Gabrieldelacal/PFC/Latex project/prolat.pdf

## Projecte Final de Carrera ENGINYERIA INDUSTRIAL

# Control d’un Quadcopter

# Memòria

Autor: | Gabriel de la Cal Mendoza
Director: | Manel Velasco Garcia
Convocatòria: Data a presentar

## Escola Tècnica Superior d’Enginyeria Industrial de Barcelona

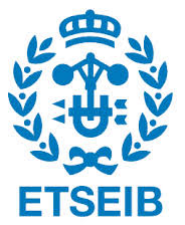
[picture p1: figure]

Quadcopter Control | 1

## Resum

## Índice

Resum | 1
1. Prefaci | 5
2. Introducció | 6
3. Definicio del model | 7
4. Disseny del controlador | 11
5. Implementació del control | 12
6. Construcció del Quadcopter | 13
7. Anàlisi econòmic | 18

4 | Quadcopter Control

## Índice de figuras

1. | Marcs de referència en el quadcopter | | 7
2. | Raspberry Pi a utilitzar | | 13
3. | Conectors de la Raspberry Pi | | 13
4. | IMU MPU-6050 | | 14
5. | Emissora i Receptor | | 14

## 1. Prefaci

### 1.1. Motivació

La principal motivació d’aquest projecte és la d’aplicar els coneixements bàsics adquirits en aquests 6 anys de carrera, i més en particular en l’àrea del control en haver fet l’intensificació d’automàtica.

Llavors, a l’hora de plantejar un tema per al projecte ràpidament va sorgir la idea de realitzar-lo sobre el control d’un sistema, i més en particular sobre un que estigués actualment emergent tant en mercats com en el camp de l’investigació.

D’entre les diferents alternatives, un quadcopter és la més atractiva tant per la seva sim-plicitat constructiva com pel no excessiu cost. Existeixen actualment en el mercat infinitat de proveïdors dels components necessaris per a construïr un quadcopter, amb un gran ventall d’opcions per a escollir cada element com motors, bateries, electrònica, etc.

Les possibles aplicacions són nombroses, tant que encara no s’han ni tan sols explotat totes les possibles. Com a exemple: vigilància de superfícies obertes, transport de petits paquets, eina d’oci, entre d’altres.

El preu d’un quadcopter no es gaire elevat ja que un comercial com el ARDrone2,0 oscil·la els 300 € i en construïr un amb menys prestacions no hauria de superar aquest cost.

### 1.2. Requeriments previs

Com a requeriments previs és necessari tenir certs coneixements mínims en automàtica per tal de controlar el quadcopter, aíxí com l’inquietut per aprendre el que sigui necessari per a complir, en la mesura del possible, els objectius inicials del present projecte com superar les dificultats que hagin sorgit, tenint en compte que el fi no justifica els medis.

## 2. Introducció

Un Quadcopter es un vehicle volador no tripulat (UnmannedAerialV ehicle) que es caracte-ritza per tenir quatre rotors a mode d’actuadors en comptes de dos com en el cas dels helicòpters. Aquest tipus d’autogir intenta obtenir una flotabilitat estable i vol precís balancejant les forces produïdes pels quatre motors.

Un dels avantatges que s’obtenen amb aquest canvi és la major capacitat de càrrega ja que es tenen 4 motors per a soportar el pes. L’estabilitat del vehicle millora en permetre aterratges i enlairaments verticals amb una major maniobrabilitat. També pot treballar en àreas de difícil accés o més agressives, com amb pluja i vent.

### 2.1. Estudi de l’art

### 2.2. Objectius del projecte

Esquemàticament es pot representar com una estructura en X amb el seu centre coincidint amb el centre de masses i quatre actuadors a les puntes de cada braç, tots ells apuntant en la mateixa direcció y sentit
descripción por encima
historia
estudio del arte
futuras aplicaciones

## 3. Definicio del model

### 3.1. Definició de les variables

Per a caracteritzar la planta amb la que es treballarà, és necessari obtenir un model del quadcopter. Les constants pròpies del model es deixaran en forma de paràmetres a calibrar una vegada es tingui l’objecte físic. D’aquesta manera el model serà general per a tot quadcopter que comparteixi la mateixa família de paràmetres. És necessari considerar dos marcs de referència: l’inercial format pels eixos x, y, z i el del cos (Body) format pels eixos xB, yB, zB. El primer té la persepectiva de l’observador en terra, estàtic, mentre que el segon és solidari a l’estructura. Segons l’orientació del eixos del cos amb aquesta referència es poden donar els següents dos cassos:

Crosstype: Els eixos de coordenades coincideixen amb els braços de l’estructura ja que es tenen els actuadors a les puntes de cada braç.
X − type: Els eixos i l’estructura formen 45º. Es tenen llavors dos motors al davant i dos

al darrere.

Per ser més usual la primera opció, es decideix utilitzar la configuració Crosstype tal i com es té en la figura 1.

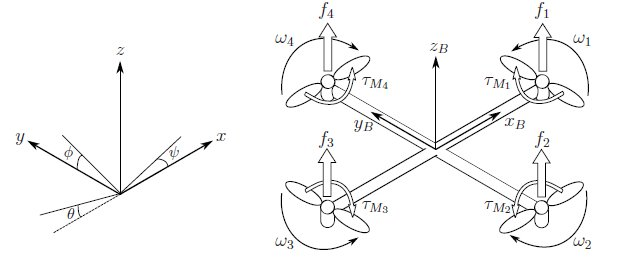
[picture p2: figure]

Figura 1: Marcs de referència en el quadcopter

Es suposa que l’objecte és un rotor esfèric, i per tant el seu tensor d’inèrcia és diagonal:

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
Ixx | 0 | 0
0 | Iyy | 0
0 | 0 | Izz

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
Es defineix la posició linear absoluta amb les coordenades x, y, z pel vector ξ i igualment per a la posició angular a partir de η segons:

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
, η =

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
, q = [
ξ
η
] | (2)

on φ és l’angle de capcineig (Pitch), θ és el de balanceig (Roll) i ψ el de guiñada (Yaw). Per a l’orientació angular entre els dos marcs es té un sistema de referència amb angles Tait Bryan, on la matriu de transformació és:

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
CψCθ | CψSθSφ − SψCφ | CψSθCφ + SψSφ
SψCθ | SψSθSφ + CψCφ | SψSθCφ − CψCφ
−Sθ | CθCφ | CθCφ

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
amb Cφ = cos(φ) i Sφ = sin(φ).

Les velocitats lineals en el marc de referència del cos (Body Frame) es representen amb el vector vB y les velocitats angulars amb γ segons:
vB =

⎡
⎢
⎢
⎢
⎢
⎢
⎣

vx,b

vy,b

vz,b

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
En canvi, les velocitats en el marc de referència inercial (Inertial Frame) es representen per η˙ per a les velocitats lineals i per ˙ξ per a les angulars:

˙ξ =

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
η˙ =

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
Ja que la derivada dels angles φ, θ i ψ no és el vector de velocitats angulars és necessari tenir un canvi de base per relacionar el marc de referència inercial al del cos amb la matriu Wη:

Wη =

⎡
⎢
⎢
⎢
⎢
⎢
⎣
1 | 0 | −Sθ
0 | Cφ | CθSφ
0 −Sφ | CθCφ

⎤
⎥
⎥
⎥
⎥
⎥
⎦
amb | γ = [Wη] η˙ | (6)

Les forces de sustentació i moments generats pels quatre actuadors són f1, f2, f3, f4 i w1, w2, w3, w4 respectivament. Seguint l’orientació de la figura 1, per tal de poder anular els moments produïts en l’eix zB (en el marc del cos) el sentit de gir dels actuadors 4 i 2 és en el de les agulles del rellotge (clockwise) i els dels 1 i 3 en sentit contrari (counterclockwise).

Interessa conèixer quina força i moment aportarà cada motor per a una velocitat angular coneguda. Es tenen les següents relacions per a cada actuador:
fi = kw²

i

τMi = bw²

i

(7)

Per tant l’empenta total TB proporcionada en la direcció zB i els moments generats τB pels motors és:

TB = k (
4
∑

i=1

w

2

i ) ezB =

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
τB =

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
lk(w

2

4 − w
2/2)
lk(w

2

3 − w
2/1)

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
### 3.2. Obtenció del model

Les equacions que governen el sistema s’obtenen amb el mètode de Euler-Lagrange, pel que es parteix obtenint el Lagrangià del sistema:

L = Ecinetica − Epotencial = (Etranslacio + Erotacio) − Epotencial | (9)

Substituïnt cada component per la seva expressió:

L(q, q˙) =
m
2

˙ξ

T ˙ξ +
1
2

γ

T

Iγ − mgz | (10)

Es troba el vector de forçes i moments com:
F = [
f
τB

] =
d
dt (

∂L

∂q˙

) −

∂L
∂q | (11)
amb | q = [ x y z φ θ ψ ]
T
i | q˙ = [ x˙ | y˙ | z˙ φ˙ | ˙θ ψ˙ ]
T

En calcular F és necessari fer el canvi de variables de γ a η˙ amb el canvi de base η˙ = [Wη]
−1
γ
per tal de poder derivar el Lagrangià respecte q˙, que són les variables pròpies del marc de referència inercial

1
2

γ

T

Iγ =
1
2

(Wηη˙)

T

I(Wηη˙) =
1
2

η˙

T

(WT
η

IWη)η˙ =
1
2

η˙

T
Jη˙ | (12)

on la matriu J queda com

J = WT

η

IWη =

⎡
⎢
⎢
⎢
⎢
⎢
⎣
Ixx | 0 | −IxxSθ
0 | IyyC

2

φ + IzzS
2
φ

(Iyy − Izz)CφSφCθ
−IxxSθ | (Iyy − Izz)CφSφCθ | IxxS
2

θ + IyyS
2
φC

2

θ + IzzC
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
(13)

i per tant el Lagrangià queda com:

L(q, q˙) =
m
2

˙ξ

T ˙ξ +
1
2

η˙

T

Jη˙ − mgz | (14)

Les components lineals y angulars no depenen unes de les altres, i per tant es poden estudiar per separat obtenint dos equacions: una per les forces lineals y un altre per als moments. Això vol dir que la força que exerceixen els actuadors no depenen de les velocitats angulars que es tinguéssin, i tampoc es tindran accel·leracions angulars diferents segons l’altura a la que es trobi el quadcopter: l’objecte girarà de la mateixa manera sigui quina sigui la seva posició en l’espai. Llavors, fent la derivada parcial respecte q˙ s’obté

F =
d
dt (

m
2

(1 ⋅

˙ξ + ˙ξ ⋅ 1) +
1
2

∂
∂η˙

(η˙

T

Jη˙)) −

∂L
∂q | (15)

Com que J és una matriux simètrica, es pot dir que ∂
∂η˙

(η˙

T Jη˙) = 2
∂
∂η˙

(η˙

T J)η˙.

Demostració: Per probar això es veurà per al cas ∂
∂x (x

T Ax) = 2
∂
∂x (x

T A)x amb

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
a11 | a12 | a13
a21 | a22 | a23
a31 | a32 | a33

⎤
⎥
⎥
⎥
⎥
⎥
⎦

(16)

Llavors
∂
∂x(x

T Ax) =
∂
∂x

⎛
⎜
⎝

[x1x2x3]

⎡
⎢
⎢
⎢
⎢
⎢
⎣
a11 | a12 | a13
a21 | a22 | a23
a31 | a32 | a33

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
= | (17)

∂
∂x(x

2

1a11 + x1x2a21 + x1x3a31 + x1x2a12 + x 2

xa22 + x2x3a32 + x1x3a13 + x2x3a23 + x 2

3a33) = (18)

Com que A és simètrica a12 = a21, a13 = a31 i a23 = a32, i en fer la derivada direccional resulta

∂
∂x(x

T Ax) =

⎡
⎢
⎢
⎢
⎢
⎢
⎣

2x1a11 + x2a21 + x3a31 + x2a12 + x3a13

x1a21 + x1a12 + 2x2a22 + x3a32 + x3a23

x1a31 + x2a32 + x1a31 + x2a23 + 2x3a23

⎤
⎥
⎥
⎥
⎥
⎥
⎦

= 2 ⋅

⎡
⎢
⎢
⎢
⎢
⎢
⎣

x1a11 + x2a12 + x3a13

x1a12 + x2a22 + x3a23

x1a13 + x2a23 + x3a23

⎤
⎥
⎥
⎥
⎥
⎥
⎦

(19)

I en avaluar l’altre costat de la igualtat es té el mateix resultat

2

∂
∂x(x

T A)x = 2
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
x1a11 + x2a12 + x3a13

x1a21 + x2a22 + x3a23

x1a13 + x2a32 + x3a33

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
x = | (20)
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
a11 | a12 | a13
a21 | a22 | a23
a31 | a32 | a33

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
= 2 ⋅

⎡
⎢
⎢
⎢
⎢
⎢
⎣

x1a11 + x2a12 + x3a13

x1a12 + x2a22 + x3a23

x1a13 + x2a23 + x3a23

⎤
⎥
⎥
⎥
⎥
⎥
⎦

(21)
∎

Com que 2

∂
∂η˙

(η˙

T J)η˙ = 2Jη˙ es té, aplicant la regla de la cadena en el producte Jη˙:

F =
d
dt

(m ˙ξ + Jη˙) −

∂L
∂q = m¨ξ + Jη¨ + J˙η˙ −

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
J)η˙ − mg

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
(22)

Per arribar a aquest resultat s’ha aplicat la derivada direccional a mgz:

Dq(mgz) = Dξ(mgz) = mg

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
(23)

Separant les components lineals i angulars en dues equacions:

f = m¨ξ + mg

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
= RTB | (24)

τ = Jη¨ + (J˙ −
∂
∂η˙

(η˙

T

J))
×≠≠≠≠≠≠≠≠≠≠≠≠≠≠≠≠≠≠≠≠≠÷≠≠≠≠≠≠≠≠≠≠≠≠≠≠≠≠≠≠≠≠≠∂
C(η,η˙)
η˙ = Jη¨ + C(η, η˙)η˙ | (25)

On C(η, η˙) és la matriu de Coriolis. Per obtenir el sistema d’equacions del model s’han d’aïllar les accel·leracions, i s’obté:
⎧⎪⎪
⎨
⎪⎪⎩

¨ξ =
1

m RTB − g ⋅ [ 0 0 1 ]
T
η¨ = J
−1

(τ − C(η, η˙)η˙)

(26)

Per a realitzar el control será útil representar el sistema 26 en forma d’espai d’estats:

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
m RTB − g ⋅ [ 0 0 1 ]
T

η˙
J

−1

(τ − C(η, η˙)η˙)

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
(27)

### 3.3. Representació del model amb Matlab

## 4. Disseny del controlador

## 5. Implementació del control

## 6. Construcció del Quadcopter

El conjunt de peces que formen aquest aparell estan conectades entre sí segons la funció que realitzen. Esencialment la Raspberry Pi controla els motors segons les señals que reb de l’IMU i el Receptor. Tot el conjunt és alimentat per una bateria LiPo i s’adapta el voltatge de 11.1V a 5V per mitjà d’un Regulador per tal d’alimentar a la Raspberry. Tots els components estan subjectats a una estructura (Frame) que també pateix les forces y moments.

### 6.1. Descripció dels components

Es descriu tot seguit cada component i el criteri de sel·lecció que s’ha aplicat.

Raspberry Pi

Abreujat com a RPi, és un petit ordinador integrat en una sola placa (Single-Board Com-puter o SBC en anglès) del tamany d’una targeta de crèdit, és a dir, amb unes dimensions de 85.6cm x 53.98cm, desenvolupat per la Fundació Raspberry Pi amb l’intenció de promocionar les ciències computacionals a les escoles [2].

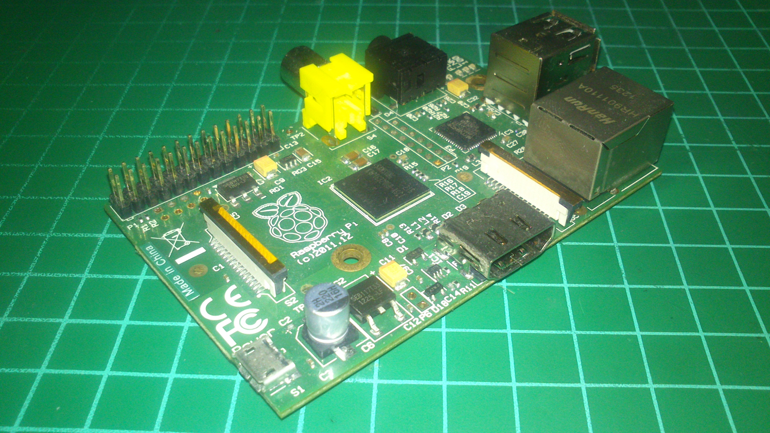
[picture p3: figure]

Figura 2: Raspberry Pi a utilitzar

S’ha optat per aquesta opció pel seu econòmic preu, la velocitat de processament i baix consum. A més, s’ha volgut ampliar els coneixements d’aquest petit monstre. En particular s’utilitza la segona revisió del model B:

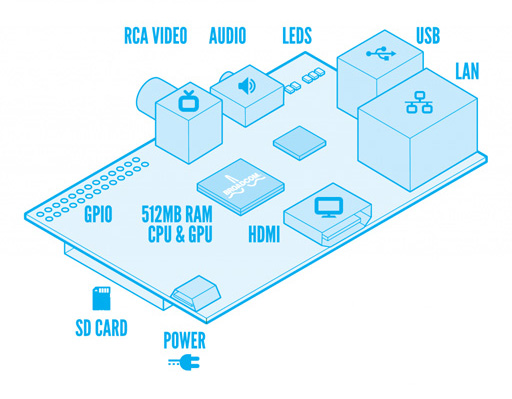
[picture p4: figure]

Figura 3: Conectors de la Raspberry Pi

Té un System-on-Chip (SoC) Broadcom BCM2835 amb un ARM1176JZF-S a 700 Mhz, una GPU VideoCore IV i 512 MB de memòria RAM. Disposa de dos ports USB, una sortida mini-jack 3.5mm, sortida d’audio/vídeo HDMI, una sortida RCA i un port RJ45 10/100 d’Ethernet. L’alimentació es realitza per mitjà d’un mini USB a 5V/700mA, amb un consum de 3.5W. El sistema operatiu és un Raspbian, gravat en una targeta SD de 4GB. Disposa d’un conjunt de pins que permeten comunicació amb perifèrics de baix nivell UART, I2C, SPI i 8 pins de propòsit general (General Porpouse Input Output o GPIO).

GY-521 MPU-6050

Es tracta d’una Unitat de Mesura Inercial (IMU en anglès) que integra en un mateix encap-sulat de 4x4x0,9mm un acceleròmetre i un giròscop, ambdós de 3 eixos. Disposa dun conversor ADC de 16 bits per a cada eix i es comunica mitjançant un protocol de comunicació I2C. S’ha optat per utilitzar aquest dispositiu pel seu baix cost i la fàcil comunicació que comporta amb la RPi.

Figura 4: IMU MPU-6050

Com a característiques dels sensors: el giròscop té un rang de ±250,±500,±1000,±2000 graus/segon, i l’accel·leròmetre de ±2g,±4g,±8g, 16g. La tensió d’alimentació és del rang de 2,375V − 3,46V

i cap la possibilitat d’utilitzar un mòdul DMP (Digital Motion Processor), però s’ha decidit implementar un filtre de Kalman per llegint les dades en cru (raw) de la cua F IF O del sensor.

Emissor-Receptor

Amb aquest parell de components es transmet la consigna generada des del transmissor cap al receptor mitjançant ones de radio. El model que s’utilitza és el T urnigy5X5ChM ini, per què és un model fàcil d’utilitzar i econòmic. Les especificacions tècniques més rellevants són:

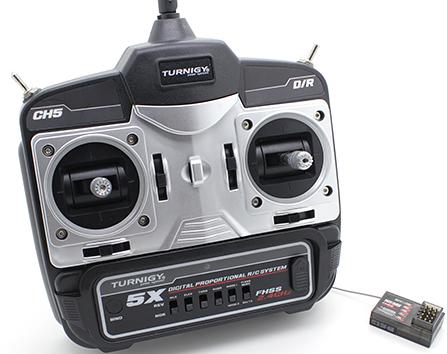
[picture p5: figure]

Figura 5: Emissora i Receptor

El transmissor té unes dimensions de 156x152x50mm, un pes de 265g i s’alimenta a 6V (4 bateries AA). El receptor té unes mides de 33,5x20,5x13mm i s’alimenta a 4.8-6V. Disposa de 5 canals de radio, amb transmissió segura a 2.4GHz amb el mètode FHSS. Pot configurarse per traballar amb dos modes (mode1-mode2).
La senyal que es reb per cada canal en el receptor és de PWM de 50Hz amb un Duty que veria de 1ms a 2ms.

Bateria LiPo

Per a alimentar a tot el conjunt s’utilitza una LiPo T urnigy2200mAh3S1P25C. Per tant, és capaç d’entregar 2.2A durant una hora, i com que la capacitat és de 25C, la descàrrega pot ser de 2,2 ∗ 25 = 55A amb un pic de descàrrega de 35C, és a dir, amb un pic de 2,2 ∗ 35 = 77A

durant 10 segons. Aquesta bateria està formada per tres cel·les que proporcionen un voltatge total d’uns 11,1V :

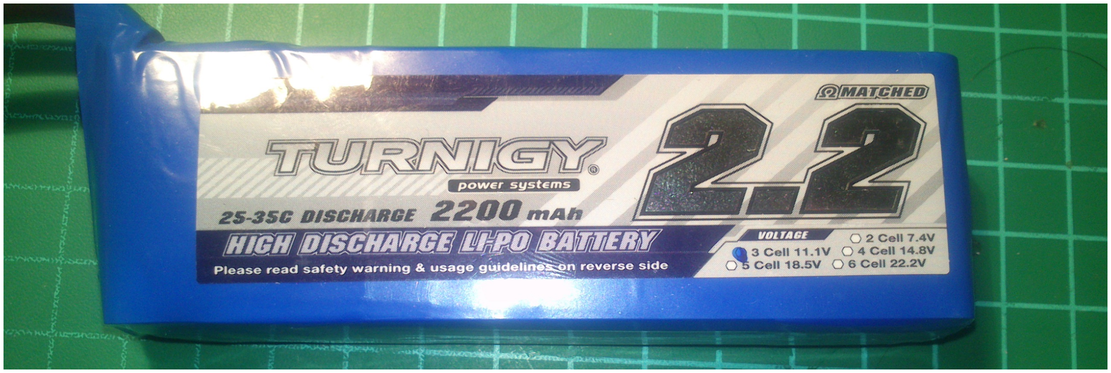
[picture p6: figure]

El conector de càrrega és el JST − XH i el de descàrrega el XT60. Per a tenir en compte amb

per al quadcopter és interessant saber que pesa 188g i respecte a l’estructura (frame) que les seves dimensions són de 105x33x24mm.

Regulador Step-Down

Per adaptar la tensió de 11.1V de la bateria LiPo a 5V per alimentar la Raspberry Pi, és necessari un regulador. En aquest cas es té l’Interruptor-Mode Màxim BEC LM2576S, que proporciona fins a 3A de corrent [6]

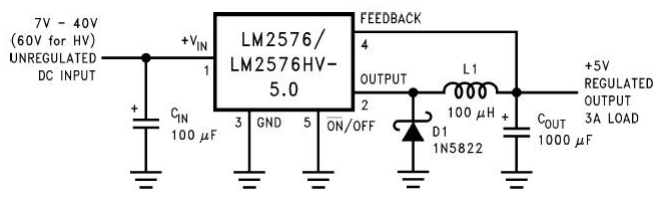
[picture p7: figure]

Motors Brushless

Els actuadors que s’utilitzen són motors brushless (BL-DC). En partircular el Turnigy 2213 20turn 1050kv 19A Outrunner. Les seves especificacions més rellevants són:

Kv: 1050rpm/v

Operating Current: 6A 16A

Peak Current: 19A

Weight: 56g

Dimensions: 27.6 x 32mm

Shaft Size: 3.175mm

Variador ESC

Per a controlar un motor brushless l’etapa de potència a utilitzar un ESC (Electronic Speed Controller) que és un variador que consta d’un inversor trifàsic:

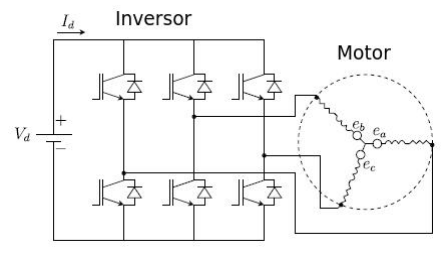
[picture p8: figure]

Turnigy AE-20A Brushless ESC Specification: Output: Continuous 20A, burst 25A up to 10 seconds. Input Voltage: 2-4 cells lithium battery or 5-12 cells NIMH battery. BEC: Linear 2A @ 5V Control Signal Transmission: Optically coupled system. Max Speed: 2 Pole: 210,000rpm 6 Pole: 70,000rpm 12 Pole: 35,000rpm Size: 50mm (L) * 26mm (W) * 12mm (H). Weight: 19g.

Features: High performance microprocessor brings out the best compatibility with all kinds of motors and the highest driving efficiency. Wide-open heatsink design to get the best heat dissipation effect. Improved Normal, Soft, Very-Soft start modes, compatible with aircraft and helicopter. Smooth, linear, quick and precise throttle response. Multiple protection features: Low-voltage cut-off protection / Over-heat protection / Throttle signal loss protection Pro-gramable via transmitter Programming features: Brake setting (we recommend using brake for only folding props applications) Battery type(Li-xx or Ni-xx) Low voltage cutoff setting Factory default setup restore Timing settings (to enhance ESC efficiency and smoothness) Soft acceleration start ups (for delicate gearbox applications) Low voltage cutoff type (power reduction orirnmediate shutdown)
Factory default settings: Brake: off Battery type: Li-xx (Li-ion or Li-Po) Low voltage cutoff threshold: Soft cut-off (2.6V) Timing setup: Low Soft Acceleration Start Up: Normal
Low voltage cutoff type: Medium

Frame

Peso 190g

Hèlix

### 6.2. Muntatge

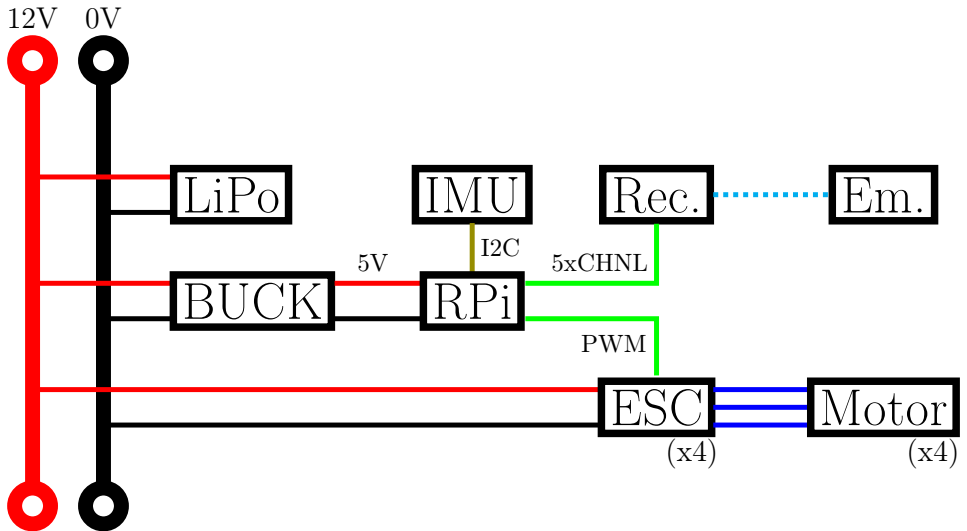
[picture p9: figure]
LiPo; IMU; Rec.; 5xCHNL; BUCK; RPi; PWM ESC; Motor

## 7. Anàlisi econòmic

## ANNEXES

Annex 1: Obtenció vector de forces

asdfasdf

Annex 2:Preparació de la Raspberry Pi

Per a posar a punt la RPi s’ha d’instal·lar Raspbian i configurar-lo per tal que es pugui comunicar amb la placa MPU-6050.

Instalació Raspbian

Havent introduït la targeta SD en un lector adeqüat, es detecta en una terminal mitjançant l’ordre df -h. Suposant que hagués estat gravada anteriorment:

S’han de desmontar les dos particions, tant la /dev/sdb1 com la /dev/sdb2 :

umount /dev/sdb1
umount /dev/sdb2

Havent descarregat la imatge a instalar per exemple a l’Escriptori, es procedeix amb:

sudo dd bs=4M if=~/Escritorio/2013-07-26-wheezy-raspbian.img of=/dev/sdb

Passats uns minuts ja es té la SD grabada amb el sistema operatiu Raspbian.

Configuració de la Raspberry

Per tal de poder comunicar la RPi amb la IMU MPU-6050 per I2C és necessari configurar el sistema. Primer és necessari instal·lar els drivers més rellevants. De l’arxiu

sudo nano /etc/modules

s’han d’afegir les següents dues línies al final de l’arxiu:

i2c-bcm2708
i2c-dev

En l’arxiu blacklist:

sudo vi /etc/modprobe.d/raspi-blacklist.conf

les següents dues línies han de començar amb un signe # (de comentari):

#blacklist spi-bcm2708

#blacklist i2c-bcm2708

Per provar de connectar el sensor, és necessari seguir primer el connexionat:

És a dir:

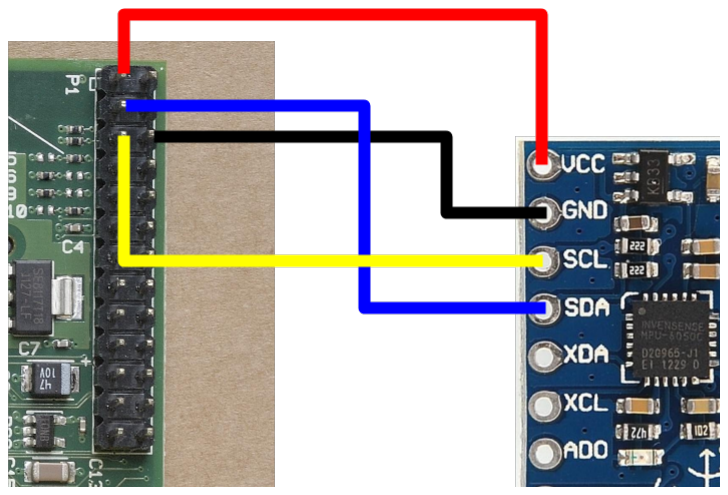
[picture p10: figure]

Pin1-3.3V es connecta VCC.

Pin3-SDA es connecta a SDA

Pin5-SCL es connecta a SCL

Pin6-Ground es connecta a GND
S’ha d’instal·lar el paquet i2c − tools:

sudo apt-get install i2c-tools

Per a veure el sensor s’escriu:

sudo i2cdetect -y 1

El resultat és

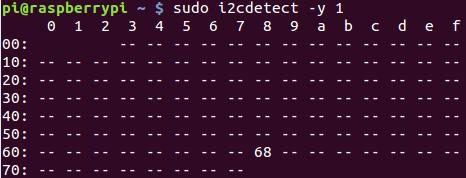
[picture p11: figure]

que és el dispositiu que correspon al MPU-6050.

Annex 3: Filtre de kalman

## Referencias

[1] Teppo Luukkonen (August 22,2011). Modelling and control of quadcopter
[2] Wikipedia de la Raspberry Pi: http://en.wikipedia.org/wiki/Raspberry_Pi
[3] Accel·leròmetre i Giròscop MPU-6050 per a Arduino: http://playground.arduino.cc/Main/MPU-6050#.UzhsVCK9jb4 (http://playground.arduino.cc/Main/MPU-6050#.UzhsVCK9jb4)
[4] MPU-6050. Especificació del producte: http://www.invensense.com/mems/gyro/documents/PS-MPU-6000A-00v3.4.pdf (http://www.invensense.com/mems/gyro/documents/PS-MPU-6000A-00v3.4.pdf)
[5] MPU-6050. Mapa de Registres i descripcions: http://www.invensense.com/mems/gyro/documents/RM-MPU-6000A-00v4.2.pdf (http://www.invensense.com/mems/gyro/documents/RM-MPU-6000A-00v4.2.pdf)
[6] LM2576S Datasheet: http://www.ti.com/lit/ds/symlink/lm2576.pdf
