Gabrieldelacal/PFC/Latex project/prolat.tex

\documentclass[twoside,11pt]{book}

%\usepackage[latin1]{inputenc}
\usepackage[utf8]{inputenc}
\usepackage[spanish]{babel}
\usepackage{amsmath, amsthm, amsfonts}
\usepackage{textcomp}
\usepackage[T1]{fontenc}
\usepackage{hyperref}
\usepackage{array}
\usepackage{MnSymbol}   % Para poder escribir el cuadrado negro

\usepackage{geometry}
    \geometry{a4paper,total={210mm,297mm},left=30mm,right=20mm,top=30mm,bottom=30mm,}

\usepackage{listings}
\lstset{
	% linewidth=15cm,
	% xrightmargin=1cm,
	breaklines=true,
	numbers=left,
	language=Matlab,
	frame=single}
\usepackage{color}
\usepackage{pgfplots}
\usepackage{pgfplotstable}
\usepackage{slashbox}
\usepackage{tikz}
\usetikzlibrary{arrows,shapes,trees}
\usepackage{multirow}
\usepackage{tabularx}
%\usepackage[official]{eurosym}
\usetikzlibrary{decorations.pathmorphing,patterns,calc,shapes,arrows}
\usepackage{setspace}
% \renewcommand{\baselinestretch}{1.3}

\usepackage{booktabs}

\usepackage{graphicx}
%\usepackage{epstopdf}

\title{\begin{center} 
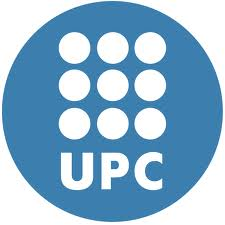
[picture p12: Latex project/images/upc.png]
 
\end{center} 
\vspace{0cm} 
Proyecto Final de Carrera\\
INGENIERÍA INDUSTRIAL \\
\vspace{0cm} 
\Huge{Modelado, simulación, construcción y control de un Quadcopter} 
\vspace{0cm} \\ 
Memoria}
%\author{Gabriel de la Cal Mendoza}
\date{}

\usepackage{fancyhdr}		%% Para cabezera de página

\pagestyle{fancy}

% \lhead[x1]{x2}
% \chead[y1]{y2}
% \rhead[LE,RO]{z2}
% \renewcommand{\headrulewidth}{0.5pt}

% \lfoot[a1]{b2}
% \cfoot[c1]{d2}
% \rfoot[LE,RO]{\includegraphics[scale=0.1]{etseib.jpg}}
% \renewcommand{\footrulewidth}{0.5pt}

\fancyhead[LO,RE]{Modelado, simulación, construcción y control de un Quadcopter}
\fancyhead[LE,RO]{\thepage}
\fancyfoot[LE,RO]{\includegraphics[scale=0.2,bb=0 0 257 257] {images/etseib_blue.png}}
\fancyfoot[C]{}

\begin{document}
\onehalfspacing
%\maketitle
%\begin{center}
%\large{
%$\begin{array}{ll}
%\mbox{Autor:} & \mbox{Gabriel de la Cal Mendoza} \\
%\mbox{Director:} & \mbox{Manel Velasco Garcia} \\
%\mbox{Convocatoria:} & \mbox{Fecha a presentar}
%\end{array}$}
%\\ \vspace{0cm} \Large{Escola Tècnica Superior d'Enginyeria Industrial de Barcelona}\\ \vspace{0cm}
%\includegraphics[scale=0.4]{images/etseib.jpg}
%\end{center}

\thispagestyle{empty}
\newpage
\begin{center}

\end{center}
\thispagestyle{empty}
\newpage
\setcounter{page}{1}

\begin{center}
\section*{Resumen}
\end{center}

En el presente proyecto se ha tenido como meta el control de un Quadcopter. Para tal propósito se ha linealizado  el modelo no lineal obtenido y controlado mediante un Regulador Lineal Cuadrático (LQR). El contenido de este trabajo está organizado en 9 capítulos y 4 anexos.\\

En el capítulo \ref{prefacio} se presentan los motivos por los que se ha elegido este tema y requerimientos previos para no tener insalvables dificultades. 

En el capítulo \ref{intro}, como Introducción, se hace un estudio del arte, con breves pinceladas del basto campo que hoy en día se encuentra sobre este tema. Además se describen los objetivos de este proyecto. Éstos no son más que el resolver todo problema que haya surgido durante esta aventura.

Se obtiene el modelo a partir de los parámetros característicos del sistema físico en el capítulo \ref{def}. En linealizar el sistema en el punto de equilibrio se llega a la conclusión de que las variables que lo forman se desacoplan y se comportan como un conjunto de dobles integradores. Ésto permite que la ley de control sea sencilla y justifica el que se hayan usado controladores PID tan asiduamente. También se presenta el modelo implementado en Simulink, con el que se probará el control obtenido posteriormente para verificar su eficiencia.

El capítulo anterior permite que en el \ref{control} se obtengan las acciones de control $\pmb{u}=-\pmb{k} \cdot \pmb{X}$ por medio de un regulador LQR (Linear Quadratic Regulator) y así atacar al sistema.

%En el capítulo \ref{implement} se explica cómo y qué se ha implementado respecto al control. Se comenta el código C que se está continuamente ejecutando.

En el capítulo \ref{construc} se describen tanto los componentes que se utilizan como el proceso de montaje paso a paso. Se justifica la elección de cada elemento tomando como criterio tanto las características de los otros elementos que lo componen como el dimensionado mismo del Quadcopter. 

En los capítulos \ref{economics}, \ref{impacto} y \ref{conclusiones} se tiene un análisis económico, un  estudio de impacto ambiental y las conclusiones respectivamente. En el primero se desglosan los costes materiales y se valoran las horas invertidas. Sobre el impacto ambiental se describen brevemente los principales efectos en el medio ambiente de los componentes que se utilizan y en el último capítulo se relata con qué se queda uno en limpio tras acabar esta empresa y sobre la continuad del proyecto.\\

En el Anexo A se muestra mediante códigos Matlab de dónde se ha extraído el vector de fuerzas del modelo y se obtienen las constantes $K$ de la realimentación.

En el Anexo B se detalla el proceso de grabado y posteriores modificaciones realizadas a la Raspberry Pi según se ha requerido.
 
En el Anexo C se describe el filtro de Kalman y cómo se ha implementado. 

En el Anexo D se describe cómo se han encontrado los parámetros que representan al sistema físico que se tiene. Para ello se han caracterizado los motores, además de la masa, inercias y distancias características propias del aparato.

%\newpage
%\begin{center}

%\end{center}
%\thispagestyle{empty}
\newpage

\setcounter{page}{1}
\tableofcontents
\addcontentsline{toc}{section}{Resumen}
\fancyhead[LE,RO]{3}
\fancyfoot[C]{}
%\setcounter{page}{1}
\newpage
\fancyhead[LE,RO]{\thepage}
\setcounter{page}{4}
\listoffigures
\newpage

\chapter{Prefacio} \label{prefacio}
%\section{Prefacio} \label{prefacio}
\section{Motivación}

La principal motivación de este proyecto es la de aplicar por uno mismo los conocimientos básicos adquiridos en la carrera, y más en particular en el área del control en haber cursado la intensificación de automática.\\

En plantear un tema para el proyecto rápidamente surgió la idea de realizarlo sobre el control de un sistema mecánico, y más en particular sobre uno que estuviera actualmente emergiendo tanto en mercados como en el campo de la investigación.\\ 

De entre las diferentes alternativas, un quadcopter es la más atractiva para el proyecto tanto por su simplicidad constructiva como por su no excesivo coste. Existen actualmente en el mercado infinidad de proveedores para los componentes necesarios para construir un quadcopter, con un gran abanico de opciones de entre las que escoger cada elemento como motores, baterías, electrónica, etc.\\

Las posibles aplicaciones son numerosas, tanto que aún no se han explotado todas las posibles. Como ejemplo: vigilancia de superficies abiertas, transporte de pequeños paquetes, herramienta de ocio, entre otras.\\

Entender el funcionamiento y familiarizarse con el mecanismo es una inquietud que se ha mantenido insatisfecha durante largo tiempo. Con este pretexto se pretende acabar de justificar la elección del tema de esta pequeña gran empresa.

\section{Requerimientos previos}

Es necesario tener ciertos conocimientos mínimos en automática para poder controlar el quadcopter, así como la inquietud de aprender lo que sea necesario para cumplir, en la medida de lo posible, los objetivos iniciales. \\

Nociones de mecánica son necesarias para elaborar e interpretar el sistema sobre el que se trabaje, así como sus resultados. Conocimientos del lenguaje $C$ como $Matlab$ son imprescindibles ya que el código del programa que realiza los cálculos está escrito en este mismo lenguaje. Estar familiarizado con $Simulink$ ha sido de gran ayuda a la hora de implementar el modelo y simularlo. 

Para adaptar los elementos que componen el aparato y afianzarlos a la estructura (Frame)  del Quadcopter ha sido de gran ayuda contar con el servicio de una impresora 3D de creación también propia, así como estar familiarizado con el argot y elementos de un Quadcopter: motores, emisoras de radio, entre otros. \\

Superar las dificultades que han surgido, teniendo en cuenta que el fin no justifica los medios, es la praxis que se ha aplicado a la hora de realizar este trabajo. Finalmente, recordar reminiscencias de la carrera es siempre útil e interesante: conceptos adquiridos pero no utilizados que se esperan aplicar.
 
\newpage
\chapter{Introducción} \label{intro}
%\section{Introducción} \label{intro}

Un Quadcopter es un vehículo volador no tripulado ($Unmanned \>Aerial\>Vehicle$ o $UAV$) que se caracteriza por tener quatro rotores como actuadores en vez de dos como en el caso de los helicópteros. Este tipo de autogiro intenta obtener una flotabilidad más estable y vuelo preciso balanceando las fuerzas producidas por los cuatro motores y surge de la necesidad de tener un aparato de vuelo de dimensiones reducidas y gran estabilidad, con prestaciones superiores a las de un helicóptero convencional. \\

\begin{figure}[h!]
\begin{center}
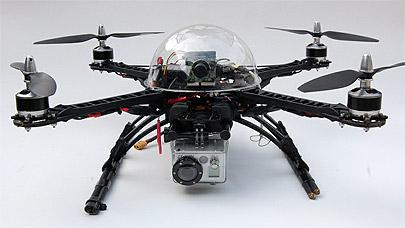
[picture p13: Latex project/images/quadcopter_example.png]
\hspace{1cm}
\caption{Quadcopter de ejemplo con cámara}
\end{center}
\end{figure}

Una de las ventajas que se obtiene con el cambio es la mayor capacidad de carga ya que es tienen 4 motores  para soportar el peso. La estabilidad del vehículo mejora en permitir aterrizajes y despegues verticales con una mayor maniobrabilidad. También puede trabajar en áreas de difícil acceso o más agresivas, como con lluvia y viento. \\

Esquemáticamente se puede representar como una estructura en $X$ con su centroide coincidiendo con el centro de masas y cuatro actuadores en las puntas de cada brazo, todos ellos apuntando en la misma dirección y sentido pero con giros de aspa en sentido contrario, pero igual en lados opuestos.

\section{Estudio del arte}

En la actualidad el campo referente a estos aparatos se ha diversificado tanto que se pueden encontrar muchas variedades y tipos de Quadcopters. Se ha hecho mención del modelo de cuatro motores, pero bien pueden encontrarse de tres hasta 8 motores, sino más en casos más concretos. \\

\begin{figure}[h!]
\begin{center}
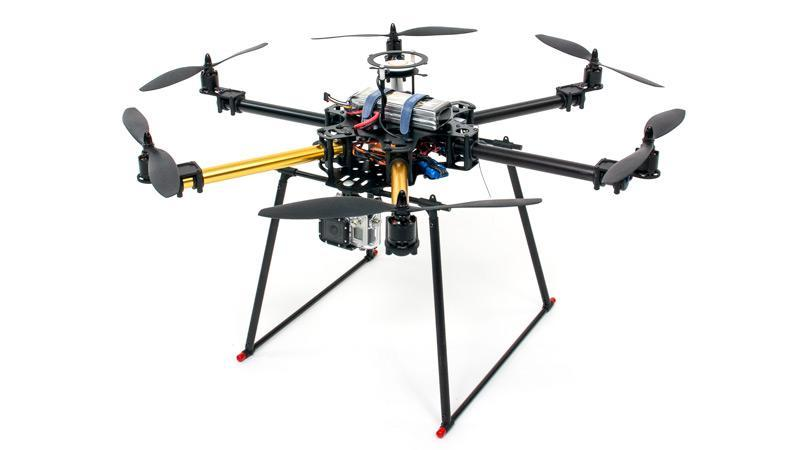
[picture p14: Latex project/images/6_armed_quadcopter.png]

\caption{Ejemplo de Quadcopter con 6 motores}
\end{center}
\end{figure}

Con el objetivo de desarrollar un $UAV$ que realice tareas de forma totalmente autónoma, se han diseñado sensores para estimar los estados del vehículo de manera más rápida y eficiente, así como diferentes estrategias para controlar la estabilidad y orientación del mismo. Se ha utilizado visión  por computador para realizar aterrizajes, detección de objetivos y navegación autónoma. También pueden combinarse diferentes técnicas con el uso del GPS para asegurar una buena localización del aparato. \\

Para controlar esta clase de aparatos se utilizan diferentes leyes de control, así como PID, LQR, Redes Neuronales, Machine Learning, entre otros. La más utilizada es sin duda el PID por su fácil implementación y poca carga computacional.

\section{Objetivos del proyecto}

La meta que se persigue es la de controlar un Quadcopter. Éste es un excelente subterfugio para cumplir con otros objetivos relacionados con este fin, como el control de motores, el inteligente uso de la electrónica y correcto diseño mecánico del aparato. Además, se espera haber ampliado la visión que uno tiene en cada campo. \\

De entre todas las disciplinas involucradas, se espera acabar familiarizado con las facetas relacionadas con la presente empresa para clarificar la relación entre los elementos que componen un Quadcopter.  A saber, se espera poder acabar entendiendo la electrónica, mecánica y conocimientos de control que reinan en el sistema. \\

En el caso de la electrónica se espera entender y poder implementar sencillos protocolos de comunicación, en este caso $I2C$ entre los sensores y la Raspberry Pi. Ésta es el centro neurálgico del Quadcopter, así que es esencial saber utilizarla como se requiere para que pueda recibir consignas, estados y enviar la correspondiente acción de control a los motores para que se llegue al estado final deseado. \\

Por parte de la mecánica, es primordial tener conocimientos sólidos de conceptos como el Teorema de la Cantidad de Movimiento y el de la conservación del Momento de Inercia, así como poder calcular el Lagrangiano ($\mathcal{L}$) para generar un modelo verosímil y que represente fidedignamente la realidad para que se desarrolle de manera efectiva el control. \\

Finalmente, y como más serio objetivo de toda esta aventura, es el de haber afianzado lo que se creía entendido en relación al control. Asimilar otros métodos de control aplicables a sistemas multilineales no contemplados en la carrera es un excitante reto que se espera haber superado con éxito. \\

Entonces, se entiende este trabajo como la causa de la motivación a cumplir con un objetivo multidisciplinar, como puede serlo cualquiera en el campo de la robótica, en el que se debe tener constancia de muchos aspectos relevantes, como el de la economía. Poder tener idea de lo que cuesta un robot es de gran importancia si uno se embarca en un proyecto de envergadura, ya que se quiere que los pronósticos sobre el presupuesto cuadren con la futura realidad. 
\section{Alcance}

En este proyecto se ha perseguido el objetivo de controlar un Quadcopter mediante un regulador LQR. Para ello se ha obtenido un modelo lineal parametrizado con la información representativa propia del sistema real que representa: masas, inercias, distancias y caracterización de los actuadores, al que se le ha aplicado la misma ley de control que al sistema real. \\

La construcción del mismo se ha llevado a cabo mediante piezas compradas por separado sin recurrir a kits montados o modelos completos, como Ardupilot o un AR Drone. No se ha pretendido construir un vehículo totalmente robusto, sino una plataforma de trabajo sobre la que se comparan comportamientos con su simulación y a la que se intenta abordar un control.\\  

No se analizan ni comparan los resultados con otros posibles controles a implementar, tales como el PID. Se juzgará la calidad del vuelo según su aparente estabilidad y si se mantiene la posición asignada como consigna. 

\newpage
\chapter{Definición del modelo} \label{def}
%\section{Definición del modelo} \label{def}
\section{Definición de las variables}
Para caracterizar la planta con la que es trabajará, es necesario obtener un modelo del Quadcopter. Las constantes propias del modelo se dejarán en forma de parámetros a calibrar una vez se tenga el objeto físico. De esta manera el modelo será general para todo Quadcopter que comparta la misma familia de parámetros.
Es necesario considerar dos marcos de referencia: el inercial formado por los ejes $x,y,z$ y el del cuerpo (Body) formado por los ejes $x_B,y_B,z_B$. El primero tiene la perspectiva de el observador en tierra, estático, mientras que el segundo es solidario a la estructura. Según la orientación de los ejes del cuerpo con esta referencia se pueden dar los siguientes dos casos:
\begin{itemize}
\item \textbf{Cross type}: Los ejes de coordenadas coinciden con los brazos de la estructura ya que se tienen los actuadores en las puntas de cada brazo.
\item \textbf{X-type}: Los ejes y la estructura forman $45º$. Se tienen entonces dos motores en la parte delantera y dos en la trasera.
\end{itemize} 
Por ser más usual la primera opción, se decide utilizar la configuración $Cross type$ tal y como se tiene en la figura \ref{RefQuad}.
\begin{figure}[h!]
\centering
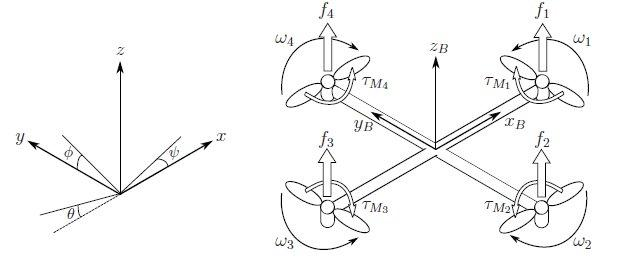
[picture p15: Latex project/images/quad.png]
\hspace{2cm}
\caption{Marcos de referencia en el quadcopter}
\label{RefQuad}
\end{figure}\\
Se supone que el objeto es un rotor esférico, y por tanto su tensor de inercia es diagonal:
\begin{equation}\textbf{I}=\left[ \begin{array}{ccc}
I_{xx} & 0 & 0 \\
0 & I_{yy} & 0 \\
0 & 0 & I_{zz} 
\end{array} \right] \end{equation}
Se define la posición lineal absoluta a partir de las coordenadas $x,y,z$ con el vector $\pmb{\xi}$ e igualmente para la posición angular a partir de $\pmb{\eta}$ según:
\begin{equation} 
\pmb{\xi}=\left[ \begin{array}{ccc}
x\\
y\\
z \end{array} \right] ,\quad \pmb{\eta}=\left[ \begin{array}{ccc}
\phi\\
\theta\\
\psi \end{array} \right] , \quad \pmb{q}=\left[\begin{array}{c}
\pmb{\xi}\\
\pmb{\eta} \end{array} \right] 
\end{equation}

donde $\phi$ es el ángulo de cabeceo (Pitch), $\theta$ és el de alabeo (Roll) y $\psi$ el de guiñada o deriva (Yaw).\\
Para la orientación angular entre los dos marcos se tiene un sistema de referencia con ángulos Tait-Bryan, donde la matriz de transformación es:

\begin{equation}
\pmb{R}(\phi,\theta,\psi)=\left[\begin{array}{ccc}
C_\psi C_\theta & C_\psi S_\theta S_\phi - S_\psi C_\phi & C_\psi S_\theta C_\phi + S_\psi S_\phi \\
S_\psi C_\theta & S_\psi S_\theta S_\phi + C_\psi C_\phi & S_\psi S_\theta C_\phi - C_\psi C_\phi \\
-S_\theta & C_\theta C_\phi & C_\theta C_\phi 
\end{array}\right]
\end{equation}

con $C_\phi=cos(\phi)$ i $S_\phi=sin(\phi)$. Ésto se obtiene del sistema de  orientación intrínseco basado en las rotaciones fundamentales respecto $\phi,\theta$ y $\psi$:

\begin{equation}
\pmb{R}(\phi,\theta,\psi)=\pmb{R}_{1}(\psi)\cdot \pmb{R}_{2}(\theta)\cdot \pmb{R}_{3}(\phi)
\end{equation}

donde las matrices de rotación son de la forma:

\begin{equation}
\begin{array}{c}
\pmb{R}(\phi)=\left[\begin{array}{ccc}
1 & 0 & 0 \\
0 & cos(\phi) & -sin(\phi) \\
0 & sin(\phi) & cos(\phi) \\ \end{array} \right]\hspace{1cm} \pmb{R}(\theta)=\left[\begin{array}{ccc}
cos(\theta) & 0 & sin(\theta) \\
0 & 1 & 0 \\
-sin(\theta) & 0 & cos(\theta) \\ \end{array} \right] \\
\\
\pmb{R}(\psi)=\left[\begin{array}{ccc}
cos(\psi) & -sin(\psi) & 0 \\
sin(\psi) & cos(\psi) & 0 \\
0 & 0 & 1 \\ \end{array} \right] \end{array}
\end{equation}

Las velocidades lineales en el marco de referencia del cuerpo (Body Frame) se representan con el vector $v_B$ y las velocidades angulares con $\gamma$ según:
\begin{equation}
\pmb{v_B}=\left[\begin{array}{c}
v_{x,b}\\
v_{y,b}\\
v_{z,b}\\
\end{array}\right] \hspace{1cm} \pmb{\gamma}=\left[\begin{array}{c}
p\\
n\\
r
\end{array} \right]
\end{equation}
En cambio, las velocidades en el marco de referencia inercial (Inertial Frame)  se representan por $\pmb{\dot{\xi}}$ para las velocidades lineales y con $\pmb{\dot{\eta}}$ para las angulares: 
\begin{equation}
\pmb{\dot{\xi}}=\left[\begin{array}{c}
\dot{x} \\
\dot{y} \\
\dot{z}
\end{array} \right] \hspace{1cm} \pmb{\dot{\eta}}=\left[\begin{array}{c}
\dot{\phi} \\
\dot{\theta} \\
\dot{\psi}
\end{array} \right] 
\end{equation}
Ya que la derivada de los ángulos $\phi$, $\theta$ y $\psi$ no es igual al vector de velocidades angulares ($\pmb{\gamma} \neq \pmb{\dot{\eta}}$), es necesario tener un cambio de base para relacionar las velocidades en el marco de referencia inercial con las del cuerpo. Para ello se calcula la matriz de transformación de velocidades angulares entre las referencias Inercial y Body como:

\begin{equation}
\left[ \begin{array}{c}
p \\
n \\
r\\\end{array} \right] = \pmb{I_{3}}\left[\begin{array}{c}
\dot{\phi} \\
0 \\
0 \\ \end{array} \right] + \pmb{R}(\phi) \left[ \begin{array}{c}
0 \\
\dot{\theta} \\
0 \\ \end{array} \right] + \pmb{R}(\phi)\cdot \pmb{R}(\theta) \left[ \begin{array}{c}
0 \\
0 \\
\dot{\psi} \\ \end{array} \right]= \left[ \pmb{W_{\eta}} \right] \left[ \begin{array}{c}
\dot{\phi} \\
\dot{\theta} \\
\dot{\psi} \\ \end{array} \right] 
\end{equation}

y se obtiene la matriz $\pmb{W_\eta}$:

\begin{equation}
\pmb{W_\eta}=\left[\begin{array}{ccc}
%1 & 0 & -S_\theta \\
%0 & C_\phi & C_\theta S_\phi \\
%0 & -S_\phi & C_\theta C_\phi 
1 & 0 & sin(\theta) \\
0 & cos(\phi) & -sin(\phi)cos(\theta) \\
0 & sin(\phi) & cos(\phi)cos(\theta) \\
\end{array} \right] \hspace{0.5cm} con \hspace{0.5cm} 
\pmb{\gamma}=\left[ \pmb{W_\eta} \right] \pmb{\dot{\eta}} 
\end{equation}

Las fuerzas de sustentación y velocidades angulares de los cuatro actuadores son $f_1,f_2,f_3,f_4$ y $w_1,w_2,w_3,w_4$ respectivamente. Siguiendo la orientación de la figura \ref{RefQuad}, con el objetivo de poder anular los momentos producidos en el eje $z_B$ (en el marco del cuerpo $B$) el sentido de giro de los actuadores  $4$ y $2$ son en el de las agujas del reloj (clockwise) y el de los $1$ y $3$ en sentido contrario (counterclockwise).

Interesa conocer qué fuerza y momento aportará cada motor dada una velocidad angular conocida. Se supone poder controlar ambos y cómo aproximación inicial se considera que están relacionados con la velocidad angular de la forma:
\begin{equation}
\begin{array}{l}
f_i=kw^2_i \\ 
\tau_{M_i}=bw^2_i
\end{array}
\end{equation}
Por tanto el empuje total $\pmb{T_B}$ proporcionado en la dirección $z_B$ y los momentos generados $\pmb{\tau_B}$ por los motores son:
\begin{equation}
\pmb{T_B}=k\left(\sum_{i=1}^{4}w^2_i \right)e_{z_B}=\left[ \begin{array}{c}
0 \\
0 \\
\displaystyle\sum_{i=1}^{4}f_i
\end{array} \right] 
\hspace{1cm} \pmb{\tau_B}=\left[ \begin{array}{c}
\tau_\phi \\
\tau_\theta \\
\tau_\psi
\end{array} \right] = \left[ \begin{array}{c}
l(f_4 - f_2) \\
l(f_3 - f_1) \\
\displaystyle\sum_{i=1}^{4}\tau_{M_i}
\end{array} \right]
\end{equation}

donde $l$ es la longitud de los brazos.

\section{Obtención del modelo}
Las ecuaciones que gobiernan el sistema se obtienen con el método de Euler-Lagrange, por lo que se empieza obteniendo el Lagrangiano del sistema:
\begin{equation}
\mathcal{L}=E_{cinetica} - E_{potencial} = (E_{translacion}+E_{rotacion})-E_{potencial}
\end{equation}

Substituyendo cada componente por su expresión:
\begin{equation}
\mathcal{L}(\pmb{q},\pmb{\dot{q}})=\frac{m}{2} \pmb{\dot{\xi}}^T \pmb{\dot{\xi}} + \frac{1}{2}\pmb{\gamma}^{T}\pmb{I}\pmb{\gamma} - mgz
\end{equation}
Es encuentra el vector de fuerzas y  momentos:
\begin{equation}
\pmb{F}=\left[ \begin{array}{c}
\pmb{f} \\
\pmb{\tau_B}
\end{array} \right] = \frac{d}{dt}\left(\frac{\partial \mathcal{L}}{\partial \pmb{\dot{q}}}\right)-\frac{\partial\mathcal{L}}{\partial \pmb{q}}
\end{equation}

con $ \hspace{0.5cm} \pmb{q}=[\begin{array}{cccccc}
x & y & z & \phi & \theta & \psi
\end{array} ]^{T} \hspace{0.5cm}$ y $ \hspace{0.5cm} \pmb{\dot{q}}=[\begin{array}{cccccc}
\dot{x} & \dot{y} & \dot{z} & \dot{\phi} & \dot{\theta} & \dot{\psi}
\end{array} ]^{T}$.\\

En calcular $\pmb{F}$ es necesario hacer el cambio de variables de $\pmb{\gamma}$ a $\pmb{\dot{\eta}}$ con el cambio de base $\pmb{\dot{\eta}}=\left[ \pmb{W_\eta} \right]^{-1} \pmb{\gamma}$ para poder derivar el Lagrangiano respecto $\pmb{\dot{q}}$, que son las variables propias del marco de referencia inercial:

\begin{equation}
\frac{1}{2}\pmb{\gamma}^{T}\pmb{I}\pmb{\gamma} = \frac{1}{2}(\pmb{W_\eta} \pmb{\dot{\eta}})^{T}\pmb{I}(\pmb{W_\eta} \pmb{\dot{\eta}}) = \frac{1}{2}\pmb{\dot{\eta}}^{T}(\pmb{W_\eta} ^{T}\pmb{I}\pmb{W_\eta})\pmb{\dot{\eta}} = \frac{1}{2}\pmb{\dot{\eta}}^{T}\pmb{J}\pmb{\dot{\eta}}
\end{equation}

donde la matriz $J$ queda como
\begin{equation}
\pmb{J}=\pmb{W_\eta} ^{T}\pmb{I}\pmb{W_\eta} = \left[ \begin{array}{ccc}
I_{xx} & 0 & I_{xx} S_\theta \\
0 & I_{yy} C^2_\phi + I_{zz} S^2_\phi & (I_{zz}-I_{yy}) C_{\phi} S_\phi C_\theta \\
I_{xx} S_\theta & (I_{zz}-I_{yy}) C_{\phi} S_\phi C_\theta & I_{xx} S^2_{\theta}+I_{yy} S^2_{\phi} C^2_\theta +I_{zz}C^2_{\phi} C^2_{\theta}
\end{array} \right]
\end{equation} 

y por tanto el Lagrangiano queda:

\begin{equation}
\mathcal{L}(\pmb{q},\pmb{\dot{q}})=\frac{m}{2} \pmb{\dot{\xi}}^T \pmb{\dot{\xi}} + \frac{1}{2}\pmb{\dot{\eta}}^{T}\pmb{J}\pmb{\dot{\eta}} - mgz
\end{equation}
Los componentes lineales y angulares del vector de fuerzas no dependen unos de los otros y por tanto se pueden estudiar por separado obteniendo dos ecuaciones: una para las fuerzas lineales y otro para los momentos. Ésto quiere decir que la fuerza que ejercen los actuadores no depende de las velocidades angulares que se tengan ni tampoco se tendrán aceleraciones angulares diferentes según la altura a la que se encuentre el quadcopter: el objeto girará de la misma manera sea cual sea la  posición en la que se encuentre en el espacio.

Entonces, calculando la derivada parcial respecto $\pmb{\dot{q}}$ se obtiene que 
\begin{equation}
\pmb{F}=\frac{d}{dt}\left(\frac{m}{2}(1\cdot \pmb{ \dot{\xi}}+\pmb{\dot{\xi}}\cdot 1)+\frac{1}{2}\frac{\partial}{\partial \pmb{\dot{\eta}}}(\pmb{\dot{\eta}}^{T}\pmb{J}\pmb{\dot{\eta}})\right)-\frac{\partial \mathcal{L}}{\partial \pmb{q}}
\end{equation}

En ser $\pmb{J}$ una matriz simétrica, se puede decir que  $\frac{\partial}{\partial \pmb{\dot{\eta}}}(\pmb{\dot{\eta}}^{T}\pmb{J}\pmb{\dot{\eta}})=2 \frac{\partial}{\partial \pmb{\dot{\eta}}}(\pmb{\dot{\eta}}^{T}\pmb{J})\pmb{\dot{\eta}} $. \\

\textbf{Demostración:} Para probar ésto se verá para el caso $\frac{\partial}{\partial \pmb{x}}(\pmb{x}^{T}\pmb{A}\pmb{x})=2 \frac{\partial}{\partial \pmb{x}}(\pmb{x}^{T}\pmb{A})\pmb{x} $ con 

\begin{equation}
\pmb{x}=\left[ \begin{array}{c}
x_1 \\
x_2 \\
x_3 
\end{array} \right] \hspace{1cm} \pmb{A}=\left[ \begin{array}{ccc}
a_{11} & a_{12} & a_{13} \\
a_{21} & a_{22} & a_{23} \\
a_{31} & a_{32} & a_{33} 
\end{array} \right]
\end{equation}
Llavors
\begin{equation}
\frac{\partial}{\partial \pmb{x}}(\pmb{x}^{T}\pmb{A} \pmb{x}) = \frac{\partial}{\partial \pmb{x}}\left(\left[x_1 x_2 x_3 \right]\left[\begin{array}{ccc}
a_{11} & a_{12} & a_{13} \\
a_{21} & a_{22} & a_{23} \\
a_{31} & a_{32} & a_{33} 
\end{array} \right]\left[\begin{array}{c}
x_1 \\
x_2 \\
x_3 
\end{array} \right] \right) =
\end{equation}
\begin{equation}
\frac{\partial}{\partial \pmb{x}}(x^2_1 a_{11}+x_1x_2a_{21}+x_1x_3a_{31} + x_1x_2a_{12}+x^2_xa_{22}+x_2x_3a_{32} + x_1x_3a_{13}+x_2x_3a_{23}+x^2_3a_{33})=
\end{equation}
Com que $\pmb{A}$ es simétrica $a_{12}=a_{21}$, $a_{13}=a_{31}$ i $a_{23}=a_{32}$, y en hacer la derivada direccional resulta
\begin{equation}
\frac{\partial}{\partial \pmb{x}}(\pmb{x}^{T}\pmb{A} \pmb{x})=\left[ \begin{array}{c}
2x_1a_{11}+x_2a_{21}+x_3a_{31}+x_2a_{12}+x_3a_{13} \\
x_1a_{21}+x_1a_{12}+2x_2a_{22}+x_3a_{32}+x_3a_{23} \\
x_1a_{31}+x_2a_{32}+x_1a_{31}+x_2a_{23}+2x_3a_{23}
\end{array} \right]=2\cdot\left[ \begin{array}{c}
x_1a_{11}+x_2a_{12}+x_3a_{13} \\
x_1a_{12}+x_2a_{22}+x_3a_{23} \\
x_1a_{13}+x_2a_{23}+x_3a_{23}
\end{array} \right]
\end{equation}
Y en avaluar el otro costado de la igualdad se tiene el mismo resultado
\begin{equation}
2 \frac{\partial}{\partial \pmb{x}}(\pmb{x}^{T}\pmb{A})\pmb{x}=2 \frac{\partial}{\partial \pmb{x}} \left( \left[ \begin{array}{ccc}
x_1a_{11}+x_2a_{12}+x_3a_{13} \\
x_1a_{21}+x_2a_{22}+x_3a_{23} \\
x_1a_{13}+x_2a_{32}+x_3a_{33}
\end{array} \right]^{T} \right)\pmb{x}=
\end{equation}
\begin{equation}
=2\left[\begin{array}{ccc}
a_{11} & a_{12} & a_{13} \\
a_{21} & a_{22} & a_{23} \\
a_{31} & a_{32} & a_{33} 
\end{array} \right]\cdot\left[\begin{array}{c}
x_1 \\
x_2 \\
x_3
\end{array} \right]=2\cdot\left[ \begin{array}{c}
x_1a_{11}+x_2a_{12}+x_3a_{13} \\
x_1a_{12}+x_2a_{22}+x_3a_{23} \\
x_1a_{13}+x_2a_{23}+x_3a_{23}
\end{array} \right]
\end{equation}
\hfill $\blacksquare$ \\
Como $2 \frac{\partial}{\partial \pmb{\dot{\eta}}}(\pmb{\dot{\eta}}^{T}\pmb{J})\pmb{\dot{\eta}=2} \pmb{J} \pmb{\dot{\eta}}$, en aplicar la regla de la cadena en el producto $\pmb{J}\pmb{\dot{\eta}}$ se obtiene que:
\begin{equation}
\pmb{F}=\frac{d}{dt}\left(m \dot{\pmb{\xi}}+\pmb{J} \pmb{\dot{\eta}}\right)-\frac{\partial \mathcal{L}}{\partial \pmb{q}} =m\pmb{\ddot{\xi}} + \pmb{J}\pmb{\ddot{\eta}} + \pmb{\dot{J}}\pmb{\dot{\eta}}-\left( \frac{1}{2} 2 \frac{\partial}{\partial \pmb{\dot{\eta}}} ( \pmb{\dot{\eta}}^{T}\pmb{J})\pmb{\dot{\eta}} - mg\left[\begin{array}{c}
0 \\
0 \\
1
\end{array} \right] \right)
\end{equation}

Para llegar a este resultado se ha aplicado la derivada direccional a $mgz$:
\begin{equation}
D_q(mgz)=D_{\pmb{\xi}}(mgz)=mg \left[ \begin{array}{c}
0 \\
0 \\
1
\end{array} \right]
\end{equation}

Separando las componentes lineales y angulares en dos ecuaciones:
\begin{equation}
\begin{cases}
%\begin{align}
\pmb{f} & = m \pmb{\ddot{\xi}} + mg \left[ \begin{array}{c}
0 \\
0 \\
1
\end{array} \right] =\pmb{R}\pmb{T_B} \\
\pmb{\tau} & =\pmb{J} \pmb{\ddot{\eta}} +  \underbrace{\left( \pmb{\dot{J}} - \frac{\partial}{\partial \pmb{\dot{\eta}}}(\pmb{\dot{\eta}}^{T}\pmb{J})\right)}_{\pmb{C(}\eta,\dot{\eta}\pmb{)}} \pmb{\dot{\eta}} =\pmb{J} \pmb{\ddot{\eta}} +  \pmb{C(\eta,\dot{\eta})}\cdot\pmb{\dot{\eta}} 
%\end{align}
\end{cases}
\label{3.24}
\end{equation}

Donde $\pmb{C(\eta,\dot{\eta})}$ es la matriz de Coriolis. 
Para obtener el sistema de ecuaciones del modelo se deben aislar las aceleraciones y se obtiene:
\begin{equation}
\begin{cases}
\pmb{\ddot{\xi}} & =\frac{1}{m}\pmb{R}\pmb{T_{B}} - g \cdot \left[ \begin{array}{ccc}
0 & 0 & 1\\
\end{array} \right]^{T} \\
\pmb{\ddot{\eta}} & =\pmb{J}^{-1} \left( \pmb{\tau} - \pmb{C(\eta,\dot{\eta})}\cdot\pmb{\dot{\eta}}  \right)
\end{cases}
\label{eq:system}
\end{equation}

Reescribiendo estas ecuaciones de la forma $\pmb{\dot{x}}=\pmb{f(x,u)}$, donde $\pmb{u}$ es el conjunto de fuerzas ejercidas por los motores, se tiene 

\begin{equation}
\frac{\partial}{\partial t}\left[ \begin{array}{l}
\pmb{\xi} \\
\pmb{\dot{\xi}} \\
\pmb{\eta} \\
\pmb{\dot{\eta}} \\
\end{array} \right] =\left[ \begin{array}{l}
\pmb{\dot{\xi}} \\
\frac{1}{m}\pmb{R}\pmb{T_{B}} - g \cdot \left[ \begin{array}{ccc}
0 & 0 & 1 \\
\end{array} \right]^{T} \\
\pmb{\dot{\eta}} \\
\pmb{J}^{-1} \left( \pmb{\tau} - \pmb{C(\eta,\dot{\eta})}\cdot\pmb{\dot{\eta}} \right)
\end{array} \right]
\label{eq:system2}
\end{equation}

Para realizar el control será útil representar el sistema \ref{eq:system}  en forma de espacio de estados, y por tanto el vector de estados será de la forma $\enspace \pmb{X}=\left[ x \enspace \dot{x} \enspace y \enspace \dot{y} \enspace z \enspace \dot{z} \enspace \phi \enspace \dot{\phi} \enspace \theta \enspace \dot{\theta} \enspace \psi \enspace \dot{\psi} \right]$. El punto de equilibrio de este sistema es aquél que hace que las componentes angulares del vector de estados no varíe y no haya desplazamientos lineales. 

Este caso se puede dar para toda posición $\pmb{\xi}$ dada. Ésto se tiene si todos los motores hacen exactamente la misma fuerza y en total, sumando la de los cuatro, la misma al peso del Quadcopter, además de tener una cantidad de movimiento nulo y evitar que el ángulo  $\psi$ (yaw) varíe. Se trata de un punto de equilibrio forzado. El punto de equilibrio será entonces:

\begin{equation}
\begin{cases}
\pmb{X_0}=\left[x \enspace 0 \enspace y \enspace 0 \enspace z \enspace 0 \enspace 0 \enspace 0 \enspace 0 \enspace 0 \enspace 0 \enspace 0 \right]^{T} \\
\pmb{U_0}=\left[ \begin{array}{l}
f_{1} \\
f_{2} \\
f_{3} \\
f_{4} \end{array} \right] = \frac{m \cdot g}{4} \left[ \begin{array}{l}
1 \\
1 \\
1 \\
1 \\ \end{array} \right]
\end{cases}
\end{equation}

El modelo se expresa en forma lineal como

\begin{equation}
\begin{array}{l}
\pmb{\dot{X}}=[\pmb{A}] \cdot \pmb{X} + \pmb{G} + [\pmb{B}] \cdot \pmb{U} \\
\pmb{Y} = [\pmb{C}] \cdot \pmb{X} 
\end{array}
\end{equation} 

donde $\pmb{G}$ es el término que incluye a la constate de la gravedad, separada de la función $\pmb{f(x,u)}$. Se calculan las matrices $\pmb{A}$ y $\pmb{B}$ con los respectivos jacobianos en el punto de equilibrio:

\begin{equation}
\begin{array}{c}
%\vspace*{-0.6cm}
\pmb{A}=\left.{\frac{\partial \pmb{f(x,u)}}{\partial \pmb{x}}}\right\vert_{\pmb{X_0},\pmb{U_0}} \\ %\hspace*{1.5cm} 
\\
\pmb{B}=\left.{\frac{\partial \pmb{f(x,u)}}{\partial \pmb{u}}}\right\vert_{\pmb{X_0},\pmb{U_0}} \\\end{array}
\label{jacobians}
%\vspace*{1cm}
\end{equation}

En considerar que las posiciones angulares de $\phi$ y $\theta$ no diferirán significativamente respecto de zero y que el ángulo $\psi$ no es relevante, se trabaja con una matriz de rotación $R$ igual a la identidad
\begin{equation}
\pmb{R}=\left[\begin{array}{ccc}
1 & 0 & 0 \\
0 & 1 & 0 \\
0 & 0 & 1 \\ \end{array} \right]
\end{equation}
Se ha mantenido el término independiente de la gravedad a fuera de la función $\pmb{f(x,u)}$ para no eliminarlo en la derivada del jacobiano. Las matrices $\pmb{A}$ y $\pmb{B}$ quedan como
\begin{equation}
\hspace*{-0.9cm}\pmb{A}=\left[ \begin{array}{cccccccccccc}
0 & 1 & 0 & 0 & 0 & 0 & 0 & 0 & 0 & 0 & 0 & 0 \\
0 & 0 & 0 & 0 & 0 & 0 & 0 & 0 & 0 & 0 & 0 & 0 \\
0 & 0 & 0 & 1 & 0 & 0 & 0 & 0 & 0 & 0 & 0 & 0 \\
0 & 0 & 0 & 0 & 0 & 0 & 0 & 0 & 0 & 0 & 0 & 0 \\
0 & 0 & 0 & 0 & 0 & 1 & 0 & 0 & 0 & 0 & 0 & 0 \\
0 & 0 & 0 & 0 & 0 & 0 & 0 & 0 & 0 & 0 & 0 & 0 \\
0 & 0 & 0 & 0 & 0 & 0 & 0 & 1 & 0 & 0 & 0 & 0 \\
0 & 0 & 0 & 0 & 0 & 0 & 0 & 0 & 0 & 0 & 0 & 0 \\
0 & 0 & 0 & 0 & 0 & 0 & 0 & 0 & 0 & 1 & 0 & 0 \\
0 & 0 & 0 & 0 & 0 & 0 & 0 & 0 & 0 & 0 & 0 & 0 \\
0 & 0 & 0 & 0 & 0 & 0 & 0 & 0 & 0 & 0 & 0 & 1 \\
0 & 0 & 0 & 0 & 0 & 0 & 0 & 0 & 0 & 0 & 0 & 0 \\ \end{array} \right] \hspace*{0.5cm} \pmb{B} = \left[ \begin{array}{cccc}
0 & 0 & 0 & 0 \\
0 & 0 & 0 & 0 \\
0 & 0 & 0 & 0 \\
0 & 0 & 0 & 0 \\
0 & 0 & 0 & 0 \\
1/m & 1/m & 1/m & 1/m \\ 
0 & 0 & 0 & 0 \\
0 & {}^{-l}/_{Ixx} & 0 & {}^{l}/_{Ixx} \\ 
0 & 0 & 0 & 0 \\
{}^{-l}/_{Iyy} & 0 & {}^{l}/_{Iyy} & 0 \\
0 & 0 & 0 & 0 \\
{}^{b}/_{Izz} & {}^{-b}/_{Izz} & {}^{b}/_{Izz} & {}^{-b}/_{Izz} \\ \end{array} \right]
\end{equation}

y las matrices $\pmb{G}$ i $\pmb{C}$ quedan como 

\begin{equation}
\hspace*{0.5cm} \pmb{G}= \left[ \begin{array}{c}
0 \\
0 \\
0 \\
0 \\
0 \\
-9.81 \\
0 \\
0 \\
0 \\
0 \\
0 \\
0 \\ \end{array} \right]  \hspace*{1cm} \pmb{C}=\left[ \begin{array}{cccccccccccc}
1 & 0 & 0 & 0 & 0 & 0 & 0 & 0 & 0 & 0 & 0 & 0 \\
0 & 0 & 1 & 0 & 0 & 0 & 0 & 0 & 0 & 0 & 0 & 0 \\
0 & 0 & 0 & 0 & 1 & 0 & 0 & 0 & 0 & 0 & 0 & 0 \\
0 & 0 & 0 & 0 & 0 & 0 & 1 & 0 & 0 & 0 & 0 & 0 \\
0 & 0 & 0 & 0 & 0 & 0 & 0 & 0 & 1 & 0 & 0 & 0 \\
0 & 0 & 0 & 0 & 0 & 0 & 0 & 0 & 0 & 0 & 1 & 0 \\ \end{array} \right]
\end{equation}

Éstos son los resultados obtenidos del código comentado en el $Anexo \>\>A$, en donde se detalla el procedimiento.

Como se desea implantar un control sobre el equilibrio del Quadcopter en vez de la posición, se tendrán las variables pertinentes a la orientación, y por tanto el vector de estados estará formado por %$\enspace \left[ \enspace \phi \enspace \dot{\phi} \enspace \theta \enspace \dot{\theta} \enspace \psi \enspace \dot{\psi} \right]$.
$\pmb{X}=\left[ \enspace \phi \enspace \dot{\phi} \enspace \theta \enspace \dot{\theta} \right]$. 

Queda entonces
\iffalse
\begin{center}
\begin{equation}
\left[ \begin{array}{c}
\dot{\phi} \\
\ddot{\phi} \\
\dot{\theta} \\
\ddot{\theta} \\
\dot{\psi} \\
\ddot{\psi} \\ \end{array} \right] = \left[ \begin{array}{cccccc}
0 & 1 & 0 & 0 & 0 & 0 \\
0 & 0 & 0 & 0 & 0 & 0 \\
0 & 0 & 0 & 1 & 0 & 0 \\
0 & 0 & 0 & 0 & 0 & 0 \\
0 & 0 & 0 & 0 & 0 & 1 \\
0 & 0 & 0 & 0 & 0 & 0 \\ \end{array} \right] \left[ \begin{array}{c}
\phi \\
\dot{\phi} \\
\theta \\
\dot{\theta} \\
\psi \\
\dot{\psi} \\ 
\end{array} \right] + \left[ \begin{array}{cccc}
0 & 0 & 0 & 0 \\
0 & {}^{-l}/_{Ixx} & 0 & {}^{l}/_{Ixx} \\ 
0 & 0 & 0 & 0 \\
{}^{-l}/_{Iyy} & 0 & {}^{l}/_{Iyy} & 0 \\
0 & 0 & 0 & 0 \\
{}^{b}/_{Izz} & {}^{-b}/_{Izz} & {}^{b}/_{Izz} & {}^{-b}/_{Izz} \\ \end{array} \right] \left[ \begin{array}{c}
f_{1} \\
f_{2} \\
f_{3} \\
f_{4} \\ \end{array} \right]
\end{equation} 
\end{center}

\begin{equation}
\nonumber
Y=\left[ \begin{array}{cccccc}
1 & 0 & 0 & 0 & 0 & 0 \\
0 & 0 & 1 & 0 & 0 & 0 \\
0 & 0 & 0 & 0 & 1 & 0 \\
\end{array} \right] \left[ \begin{array}{c}
\phi \\
\dot{\phi} \\
\theta \\
\dot{\theta} \\
\psi \\
\dot{\psi} \\ \end{array} \right]
\end{equation} 
\fi
\begin{center}
\begin{equation}
\left[ \begin{array}{c}
\dot{\phi} \\
\ddot{\phi} \\
\dot{\theta} \\
\ddot{\theta} \\ \end{array} \right] = \left[ \begin{array}{cccccc}
0 & 1 & 0 & 0 \\
0 & 0 & 0 & 0 \\
0 & 0 & 0 & 1 \\
0 & 0 & 0 & 0 \\ \end{array} \right] \left[ \begin{array}{c}
\phi \\
\dot{\phi} \\
\theta \\
\dot{\theta} \\\end{array} \right] + \left[ \begin{array}{cccc}
0 & 0 & 0 & 0 \\
0 & {}^{-l}/_{Ixx} & 0 & {}^{l}/_{Ixx} \\ 
0 & 0 & 0 & 0 \\
{}^{-l}/_{Iyy} & 0 & {}^{l}/_{Iyy} & 0 \\ \end{array} \right] \left[ \begin{array}{c}
f_{1} \\
f_{2} \\
f_{3} \\
f_{4} \\ \end{array} \right]
\label{eq:final_system}
\end{equation} 
\end{center}

\begin{equation}
\nonumber
\pmb{Y}=\left[ \begin{array}{cccccc}
1 & 0 & 0 & 0 \\
0 & 0 & 1 & 0 \\ \end{array} \right] \left[ \begin{array}{c}
\phi \\
\dot{\phi} \\
\theta \\
\dot{\theta} \\ \end{array} \right]
\end{equation} 

donde el vector $\pmb{G}$ se ha obviado porque las componentes que se hubieran considerado de éste son todas nulas. 

El eliminar estas componentes se hace porque no hay una referencia zero para el ángulo $\psi$, mientras que en el caso de los ángulos $\phi$ y $\theta$ la referencia siempre será la horizontal. No supone un infranqueable problema a la hora de hacer mover el Quadcopter, pues éste ya se puede desplazar en todo su plano horizontal, sin necesidad de girar en la dirección del $yaw$.\\

Para abordar el control de este sistema reducido se evalúa su controlabilidad y observabilidad. Se espera poder llevar el vector de estados de una posición a otra mediante una entrada adecuada, en un tiempo finito. La matriz de controlabilidad $\pmb{W_c}=[B \>\> AB \>\> A^{2}B \>\> ... \>]$ es de la forma:

\begin{equation}
\pmb{Wc}=\left[ \left.{\begin{array}{cccc}
0 & 0 & 0 & 0 \\
0 & {}^{-l}/_{Ixx} & 0 & {}^{l}/_{Ixx} \\ 
0 & 0 & 0 & 0 \\
{}^{-l}/_{Iyy} & 0 & {}^{l}/_{Iyy} & 0 \\ \end{array}}\right\vert_{} \left.{\begin{array}{cccc}
0 & {}^{-l}/_{Ixx} & 0 & {}^{l}/_{Ixx} \\
0 & 0 & 0 & 0 \\
{}^{-l}/_{Iyy} & 0 & {}^{l}/_{Iyy} & 0 \\
0 & 0 & 0 & 0 \\
\end{array}}\right\vert_{} \quad ... \quad \right]
\end{equation}

Con las 8 primeras columnas es suficiente para ver que el rango de la matriz es máximo, y el resto de componentes de la matriz son nulas. Por lo tanto, no hay subsistema inaccesible des de la entrada y es entonces controlable:

\begin{equation}
rango(\pmb{Wc})=4\>\>(max.)\> \rightarrow \>Controlable
\end{equation}

Para evaluar la observabilidad se calcula la matriz de observabilidad $\pmb{W_o}$ y como en el caso anterior, se evaluará su rango:

\begin{equation}
\pmb{W_o}=\left[ \begin{array}{c}
C \\
CA \\
CA^2 \\
...
\end{array}\right] =\left[\begin{array}{c}

\begin{array}{cccc}
1 & 0 & 0 & 0 \\
0 & 0 & 1 & 0 \\
\hline 
0 & 1 & 0 & 0 \\
0 & 0 & 0 & 1 \\
\hline
\end{array}\\
...\\ \end{array} \right]
\end{equation}

otra vez no es necesario evaluar todos los términos de la matriz, ya que con las primeras 4 filas se ve que el rango vuelve a es máximo:
\begin{equation}
rango(\pmb{W_o})=4\>\>(max.) \> \rightarrow \> Observable
\end{equation}

Ésto arroja lo que ya era sabido del sistema: de un Quadcopter se pueden observar sus estados y se puede gobernar (controlar) mediante los actuadores provistos. 

\newpage
\section{Representación del modelo con Simulink}

Obtenidas las ecuaciones del modelo, se quiere poder trabajar con éste para comprobar que la ley de control que se tenga es válida como para controlar el aparato real. Se intenta que el modelo sea lo más preciso posible, por lo que no se tienen en cuenta linealizaciones ni aproximaciones de tipo alguno. 

\begin{figure}[h!]
\begin{center}
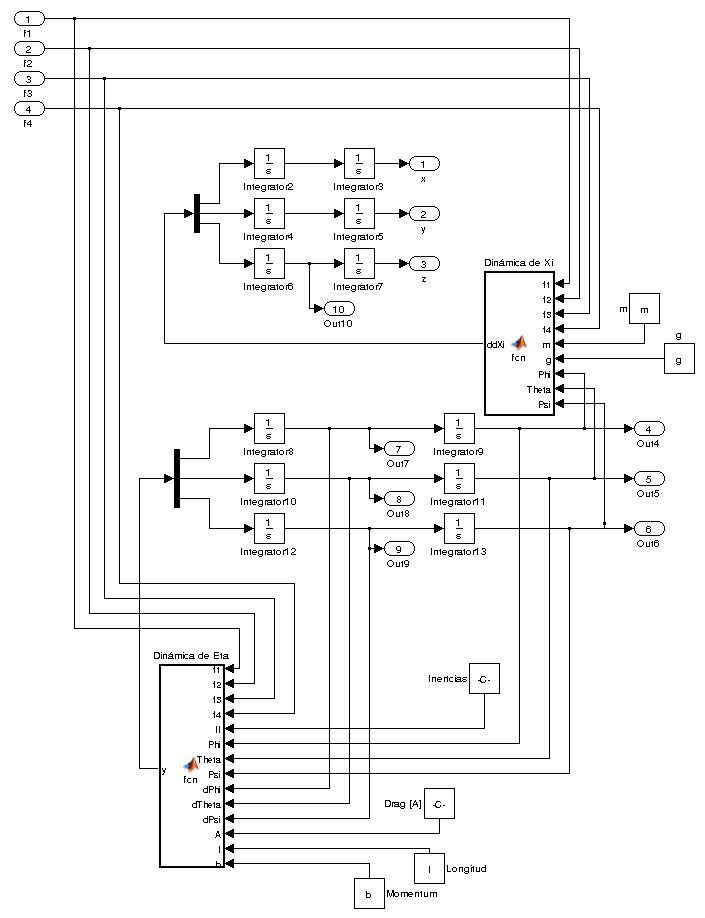
[picture p16: Latex project/images/Simulink_model.png]
\hspace{0cm} 
\caption{Modelo en Simulink de la dinámica del Quadcopter}
\end{center}
\end{figure}

Como se ha visto en el apartado anterior, no se han tenido en cuenta en el modelo los respectivos coeficientes de fricción con el aire ya que la determinación de estos parámetros no es fácil y de incluirse podrían aportar un considerable error en los resultados. \\

Tal y como se explica a la hora de caracterizar los motores, no se pudo encontrar la relación existente entre la fuerza y momento ejercido por cada actuador, por lo que en este caso se ha supuesto que varía proporcionalmente con $b$.

Los dos bloques presentes en el modelo ($Function \>\> Matlab$) definen su dinámica. La función $Dinámica \>\> de \>\> Xi$ determina las aceleraciones lineales. El código incluido en ésta es:\\

\begin{lstlisting}[language=Matlab]
function ddXi = fcn(f1,f2,f3,f4,m,g,Phi,Theta,Psi)
%#codegen

R=[[cos(Psi)*cos(Theta) cos(Psi)*sin(Theta)*sin(Phi)-sin(Psi)*cos(Phi) cos(Psi)*sin(Theta)*cos(Phi)+sin(Psi)*sin(Phi)];
   [sin(Psi)*cos(Theta) sin(Psi)*sin(Theta)*sin(Phi)+cos(Psi)*cos(Phi) sin(Psi)*sin(Theta)*cos(Phi)-cos(Psi)*sin(Phi)];
   [-sin(Theta) cos(Theta)*sin(Phi) cos(Theta)*cos(Phi)]];

T=[0; 0; (f1+f2+f3+f4)];

ddXi = R*T/m+[0; 0; -g];
\end{lstlisting}

En ella se calcula la matriz de rotación $\mathbf{R}$ en función de la posición angular($\phi$, $\theta$ y $\psi$) y con el vector de fuerzas en la base móvil (del cuerpo $Body$) se calcula en vector de aceleraciones lineales, es decir, $\pmb{\ddot{\xi}}=\left[ \ddot{\phi} \quad \ddot{\theta} \quad \ddot{\psi} \right]^{T}$. \\

En la función $Dinámica \>\> de \>\> Eta$ se calculan las aceleraciones angulares. Su código corresponde a: 

\singlespacing
\begin{lstlisting}[language=Matlab]
function y = fcn(f1,f2,f3,f4,II,Phi,Theta,Psi,dPhi,dTheta,dPsi,A,l,b)
%#codegen

Ixx=II(1);
Iyy=II(2);
Izz=II(3);
 
TauB=[[       l*(f4-f2)];
      [       l*(f3-f1)];
      [ b*(f1+f3-f2-f4)]];  

Weta=[[ 1         0           sin(Theta)];
      [ 0  cos(Phi) -cos(Theta)*sin(Phi)];
      [ 0  sin(Phi)  cos(Theta)*cos(Phi)]];
 
J=transpose(Weta)*[[Ixx 0 0];[0 Iyy 0];[0 0 Izz]]*Weta;  

CdE1=(Iyy*dTheta^2*sin(2*Phi))/2 - (Izz*dTheta^2*sin(2*Phi))/2 - Ixx*dPsi*dTheta*cos(Theta) - (Iyy*dPsi^2*sin(2*Phi)*cos(Theta)^2)/2 + (Izz*dPsi^2*sin(2*Phi)*cos(Theta)^2)/2 - Iyy*dPsi*dTheta*cos(2*Phi)*cos(Theta) + Izz*dPsi*dTheta*cos(2*Phi)*cos(Theta);

CdE2=-dPhi*(Ixx*dPsi*cos(Theta) + 2*Iyy*dTheta*cos(Phi)*sin(Phi) - 2*Izz*dTheta*cos(Phi)*sin(Phi) + Iyy*dPsi*cos(Phi)^2*cos(Theta) - Izz*dPsi*cos(Phi)^2*cos(Theta) - Iyy*dPsi*cos(Theta)*sin(Phi)^2 + Izz*dPsi*cos(Theta)*sin(Phi)^2)  - Ixx*dPsi^2*cos(Theta)*sin(Theta) + Iyy*dPsi^2*cos(Theta)*sin(Phi)^2*sin(Theta) + Izz*dPsi^2*cos(Phi)^2*cos(Theta)*sin(Theta);

CdE3= dPhi*(Ixx*dTheta*cos(Theta) - Iyy*dTheta*cos(Phi)^2*cos(Theta) + Izz*dTheta*cos(Phi)^2*cos(Theta) + Iyy*dTheta*cos(Theta)*sin(Phi)^2 - Izz*dTheta*cos(Theta)*sin(Phi)^2 + 2*Iyy*dPsi*cos(Phi)*cos(Theta)^2*sin(Phi) - 2*Izz*dPsi*cos(Phi)*cos(Theta)^2*sin(Phi)) + Iyy*dTheta^2*cos(Phi)*sin(Phi)*sin(Theta) - Izz*dTheta^2*cos(Phi)*sin(Phi)*sin(Theta) + 2*Ixx*dPsi*dTheta*cos(Theta)*sin(Theta) - 2*Izz*dPsi*dTheta*cos(Phi)^2*cos(Theta)*sin(Theta) - 2*Iyy*dPsi*dTheta*cos(Theta)*sin(Phi)^2*sin(Theta);

CdEta=[CdE1; CdE2; CdE3];

y = inv(J)*(TauB-CdEta);
\end{lstlisting}
\onehalfspacing

En esta función se calcula el vector de momentos ($\mathbf{TauB}$), se calcula la actual matriz de cambio de base de velocidad angular a derivadas de ángulos de Euler ($\pmb{W_\eta}$), se actualiza el tensor de inercias según este cambio y se obtiene el producto $\pmb{C(\eta,\dot{\eta})}\cdot\pmb{\dot{\eta}}$. Finalmente devuelve las aceleraciones según se obtienen en la ecuación \ref{eq:system2}.

Los parámetros que se cargan en Matlab necesarios para definir este modelo son
\begin{lstlisting}[language=Matlab]
% Declaracion simbolica de las variables

syms x dx ddx y dy ddy z dz ddz Phi dPhi ddPhi Theta dTheta ddTheta Psi dPsi ddPsi
syms f1 f2 f3 f4 
syms Ixx Iyy Izz
syms Ax Ay Az 
syms k m g l b

l=0.165			% Longitud de los brazos (m)
Ixx=0.007931		% Producto de inercia en x (kg*m2)
Iyy=0.007664		% Producto de inercia en y (kg*m2)
Izz=0.009741		% Producto de inercia en z (kg*m2)
m=0.96			% Masa del Quadcopter (kg)
b=1.2*10^-7		% Relacion Momento-Fuerza
g=9.81			% Aceleracion gravedad (m/s2)

Ax=0			% Friccion aire (no usado)
Ay=0
Az=0
\end{lstlisting}

\newpage
\chapter{Diseño del controlador} \label{control}
% \section{Diseño del controlador} \label{control}

Con el modelo linealizado del sistema ya se tiene lo que emulará una respuesta verosímil y acorde a la realidad.Para que haga lo que uno espera  se decide aplicar un control óptimo mediante un regulador LQR (Linear Quadratic Regulator). \\

\section{Regulador Quadrático Lineal}
% Explicar teoría del regulador

Dado un sistema lineal de tiempo discreto definido por 

\begin{equation}
\begin{array}{l}
\dot{\mathbf{X}}_{k+1}=[\mathbf{A}] \cdot \mathbf{X}_{k} + [\mathbf{B}] \cdot \mathbf{U}_{k} \\
\mathbf{Y}_{k+1} = [\mathbf{C}] \cdot \mathbf{X}_{k} 
\end{array}
\end{equation} 

se quiere operar este sistema mediante un coste mínimo según un criterio determinado. Este criterio se caracteriza por tener una función de costes $\mathbf{J}$ que depende tanto de los estados como de las entradas del sistemas \cite{LQR_Wikipedia}

\begin{equation}
\mathbf{J} =\sum^{\infty}_{k=0} \left( \mathbf{X}^{T}_{k} \mathbf{Q}\pmb{X}_{k} + \mathbf{U}^{T}_{k} \mathbf{R}\mathbf{U}_{k} + 2\mathbf{X}^{T}_{k} \mathbf{N}\mathbf{U}_{k} \right)
\end{equation}

y se definen los pesos $\mathbf{Q}$, $\mathbf{R}$ y $\mathbf{N}$ como matrices definidas positivas y simétricas, según la penalización que se le quiera dar a los estados ($\mathbf{X}$), acciones ($\mathbf{U}$) o el efecto de ambos ($\mathbf{N}$) respectivamente, tal que se minimice el coste $\mathbf{J}$. Se Supondrá que $\mathbf{N}=\pmb{0}$. Se obtiene la ley de control $\mathbf{U}_{k}=-\mathbf{K} \cdot \mathbf{X}_{k}$ de 

%\begin{equation}
%\mathbf{K}=\mathbf{R}^{-1} \left( \mathbf{B}^{T} \mathbf{S} + \mathbf{N}^{T} \right) 
%\end{equation}

\begin{equation}
\mathbf{K}=(\mathbf{B}^{T}\mathbf{S}\mathbf{B}+\mathbf{R})^{-1}(\mathbf{B}^{T}\mathbf{S}\mathbf{A}+\mathbf{N}^{T})
\end{equation}

donde $\mathbf{S}$ es la solución de la ecuación de Riccati asociada 

%\begin{equation}
%\mathbf{A}^{T}\mathbf{S} + \mathbf{S}\mathbf{A} - \left( \mathbf{S}\pmb{B}+\mathbf{N} \right) \mathbf{R}^{-1} \left( \mathbf{B}^{T} \mathbf{S} + \mathbf{N}^{T} \right) + \mathbf{Q} = \pmb{0}
%\end{equation}

\begin{equation}
\mathbf{A}^{T}\mathbf{S}\mathbf{A}-\mathbf{S}-(\mathbf{A}^{T}\mathbf{S}\mathbf{B}+\mathbf{N})(\mathbf{B}^{T}\mathbf{S}\mathbf{B}+\mathbf{R})^{-1}(\mathbf{B}^{T}\mathbf{S}\mathbf{A}+\mathbf{N}^{T})+\mathbf{Q}=\mathbf{0}
\end{equation}

%En este caso se supondrá que $\mathbf{N}=0$ \cite{LQR_Matlab} se tendrá

%\begin{equation}
%\mathbf{J} =\int^{\infty}_{0} \left( \mathbf{X}^{T} \mathbf{Q}\mathbf{X} + \mathbf{U}^{T}\mathbf{R}\mathbf{U} \right) dt
%\end{equation}

%y por consiguiente, la ecuación a resolver es

%\begin{equation}
%\mathbf{A}^{T}\mathbf{S} + \mathbf{S}\mathbf{A} - \mathbf{S}\mathbf{B} \mathbf{R}^{-1} \mathbf{B}^{T} \mathbf{S} + \mathbf{Q} = 0
%\end{equation}

Finalmente, de este procedimiento se obtiene, además de las constantes de realimentación $\mathbf{K}$ y la solución $\mathbf{S}$, los polos del sistema: $\mathbf{P}=eigenvalue( \mathbf{A} - \mathbf{B} \cdot \mathbf{K})$.

\section{Obtención de la ley de control}
% Cálculo de las k's

Como se ha visto en la ecuación \ref{eq:final_system}, las matrices que representan el sistema son

\begin{equation}
\pmb{A}= \left[ \begin{array}{cccc}
0 & 1 & 0 & 0 \\
0 & 0 & 0 & 0 \\
0 & 0 & 0 & 1 \\
0 & 0 & 0 & 0 \\ \end{array} \right] \hspace{1cm} \pmb{B}=\left[ \begin{array}{cccc}
0 & 0 & 0 & 0 \\
0 & {}^{-l}/_{Ixx} & 0 & {}^{l}/_{Ixx} \\ 
0 & 0 & 0 & 0 \\
{}^{-l}/_{Iyy} & 0 & {}^{l}/_{Iyy} & 0 \\ \end{array} \right] 
\end{equation} 

\begin{equation}
\nonumber
\pmb{C}=\left[ \begin{array}{cccc}
1 & 0 & 0 & 0 \\
0 & 0 & 1 & 0 \\ \end{array} \right] 
\end{equation} 

En el apartado anterior se ha visto que se deben asignar valores a $\mathbf{Q}$ y $\mathbf{R}$, y como tanto $\mathbf{X}$ como $\mathbf{U}$ son vectores $4x1$, las matrices a asignar serán $4x4$. La matriz $\mathbf{Q}$ se puede escribir como 

\begin{equation}
\mathbf{Q}=1 \cdot \pmb{C}^{T}\pmb{C}
\end{equation}

por lo tanto 

\begin{equation}
\mathbf{Q}= \left[ \begin{array}{cc}
1 & 0 \\
0 & 0 \\
0 & 1 \\
0 & 0 \\ \end{array} \right] \left[ \begin{array}{cccc}
1 & 0 & 0 & 0 \\
0 & 0 & 1 & 0 \\ \end{array} \right] = \left[ \begin{array}{cccc}
1 & 0 & 0 & 0 \\
0 & 0 & 0 & 0 \\
0 & 0 & 1 & 0 \\
0 & 0 & 0 & 0 \\ \end{array} \right]
\end{equation}

Para el caso de $\mathbf{R}$ se consideran toda un mismo peso para todas las entradas $f_i$ y muy superior a los pesos de $\mathbf{Q}$: 

\begin{equation}
\mathbf{R}=100 \cdot \pmb{I} = \left[ \begin{array}{cccc}
100 &   0 &   0 &   0 \\
0   & 100 &   0 &   0 \\
0   &   0 & 100 &   0 \\
0   &   0 &   0 & 100 \\ \end{array} \right] 
\end{equation}

Se hayan $\mathbf{K}$,$\mathbf{S}$ y $ \mathbf{E}$ mediante la toolbox de Matlab para calcular el control óptimo según el regulador LQR\cite{Toolbox_lqr} en tiempo discreto:

\begin{verbatim}
            [K,S,E] = lqrd(A,B,Q,R,Ts)
\end{verbatim}

El tiempo de muestreo se tiene que es $T_{s}=20\>ms$ porque las acciones de control tienen una frecuencia de 50 Hz. Teniendo en cuenta que los parámetros del sistema físico obtenidos en el Anexo 4 son $I_{xx}=7.931\cdot 10^{-3} \>\> kg \cdot m^{2}$, $I_{yy}=7.664\cdot 10^{-3}\>\> kg \cdot m^{2}$ y $l=0.165 \>\> m$ se tiene que las constantes $\mathbf{K}$ en la realimentación son:

\begin{equation}
\mathbf{K}= \left[ \begin{array}{cccc}
         0  &      0  &  -0.0690  & -0.0566 \\
   -0.0690 &   -0.0576    &     0    &     0 \\
         0    &     0 &   0.0690  &  0.0566 \\
    0.0690  &  0.0576    &     0    &     0 \\ \end{array} \right]
   \label{Kmatrix}
\end{equation}

En ser la ley de control $\pmb{U}=-\mathbf{K}\cdot \mathbf{X}$, el vector de estados $\mathbf{X}=[\phi \quad \dot{\phi \quad \theta \quad \dot{\theta}}]^{T}$ y $\mathbf{U}=[f_{1} \quad f_{2} \quad f_{3} \quad f_{4}]$, el ángulo $\phi$ tendrán efecto en el los motores $f_{1}$ y  $f_{3}$ mientras que $\theta$ afectará a $f_{2}$ y $f_{4}$. La matriz $\mathbf{S}$, solución de la ecuación de Riccati, queda

\begin{equation}
\mathbf{S}= \left[ \begin{array}{cccc}

    0.8245  &  0.3399    &     0 &        0 \\
    0.3399  &  0.2802    &     0   &      0 \\
         0  &       0  &  0.8107  &  0.3286 \\
         0   &      0  & 0.3286  &  0.2664 \\ \end{array}     \right]
\end{equation}

y los polos del sistema, considerando que es un sistema discreto, son

\begin{equation}
\mathbf{E}= \left[ \begin{array}{c}
  -0.9757 + 0.0237i \\
  -0.9757 - 0.0237i \\
  -0.9753 + 0.0241i \\
  -0.9753 - 0.0241i \\
\end{array} \right] 
\end{equation}

\section{Aplicación en el modelo}

Como prueba para la ley de control extraída, se aplica ésta al modelo simulado en Matlab explicado anteriormente. Se encierra el modelo de la dinámica del sistema en un bloque ($Quadcopter$) y se usan sus salidas para realimentar la acción de control de control a través de los motores. \\

No se considera el control de la altura en el sistema real, pero se implementa un PID para evaluar la respuesta también en la estabilización mientras se alcanza una altura determinada. Esta disposición de bloques permite implementar otros controles sobre el sistema también usados en el mundo físico tales como PID. El sistema que se tiene en Simulink es

\newpage

\begin{center}
\begin{figure}[h!]
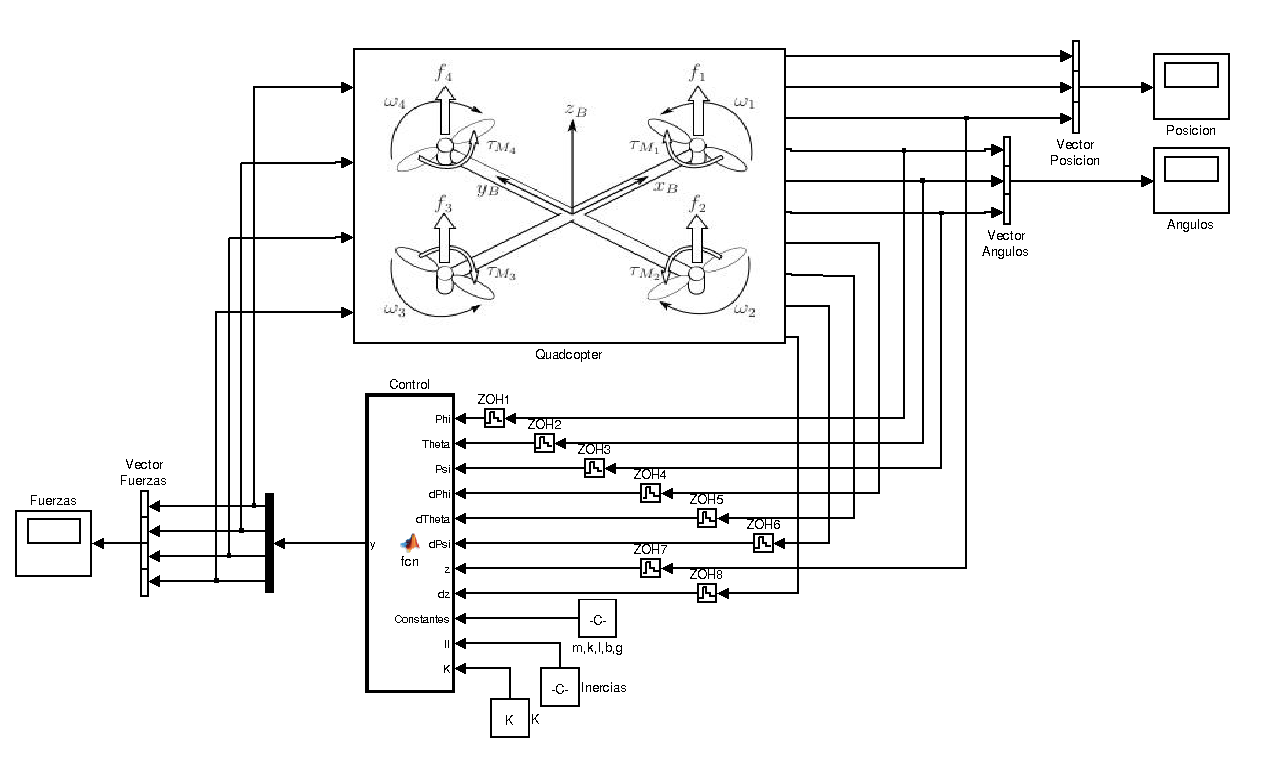
[picture p17: Latex project/images/Simulink_model_2.png]

\caption{Modelo en Simulink del lazo cerrado aplicado en el Quadcopter}
\end{figure}
\end{center}

La frecuencia de la señal con la que se controlan los motores es de 50 Hz, por lo que se disponen los $Zero-Order-Holder$ en la entrada de la función de Matlab $Control$ para incluir en la simulación esta característica del sistema real.\\ 
Mediante los tres $Scopes$ se pueden observar la posición, ángulos y acciones de los motores del Quadcopter. La $Function \>\> Matlab$ proporciona la acción de control según sea el estado del sistema. En ella se importan las constantes de realimentación $\mathbf{K}$ desde el $Workspace$ de Matlab y su contenido es

\begin{lstlisting}[language=Matlab]
function y = fcn(Phi,Theta,Psi,dPhi,dTheta,dPsi,z,dz,Constantes,II,K)
%#codegen

m=Constantes(1);
% k=Constantes(2);
l=Constantes(2);
b=Constantes(3);
g=Constantes(4);

Ixx=II(1);
Iyy=II(2);
Izz=II(3);

zD=10;
dzD=0;

KzP=6;
KzD=1.75;

vector=-K*[Phi; dPhi; Theta; dTheta]+(g+KzD*(dzD-dz)+KzP*(zD-z))*m;

if(vector(1)<0) 
       vector(1)=0;
elseif(vector(1)>10)
       vector(1)=10;
end
if(vector(2)<0) 
       vector(2)=0;
elseif(vector(2)>10)
       vector(2)=10;       
end
if(vector(3)<0) 
       vector(3)=0;
elseif(vector(3)>10)
       vector(3)=10;       
end
if(vector(4)<0) 
       vector(4)=0;       
elseif(vector(4)>10)
       vector(4)=10;       
end
 
y=[vector(1);vector(2);vector(3);vector(4)];
\end{lstlisting}

Se calcula la acción de control $\mathbf{U}=-\mathbf{K} \cdot \mathbf{X}$ en la línea 21 mediante los estados pero se añade un control para la altura para simular un caso más real. Se saturan las acciones de control para que no puedan ser negativas con los cuatro $if's$ entre las líneas 23 y 34 porque los motores no pueden ni cambiar de sentido ni superar la fuerza máxima que puedan aportar, que se considera que es de $10\>\>N$. De esta manera se tiene una representación de la realidad más verosímil. 

A modo de ejemplo, para las $\mathbf{K}2$ calculadas según los parámetros obtenidos del modelo,
%\begin{equation}
%\mathbf{K}=\left[ \begin{array}{cccc}
%         0 &         0 &  -0.0224 &  -0.0322 \\
%   -0.0224 &  -0.0328    &     0  &       0 \\
%         0      &   0  &  0.0224 &   0.0322 \\
%    0.0224  &  0.0328  &       0    &     0 \\
%\end{array} \right]
%\end{equation}
y partiendo de unas condiciones iniciales de $\mathbf{q}=[\xi \quad \eta]^{T}=[0 \quad 0 \quad 0 \quad 45^{o} \quad 0 \quad 0 ]$ se tiene como respuesta para el ángulo $\phi$: 

\begin{figure}[h!]
\begin{center}
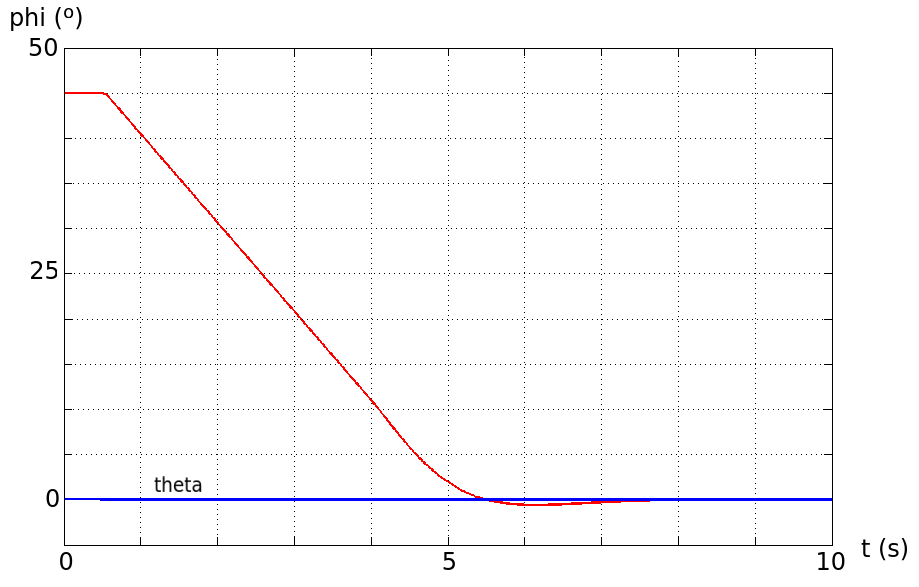
[picture p18: Latex project/images/simulation_2_2.png]

\end{center}
\caption{Respuesta del ángulo $\phi$ en la simulación}
\end{figure}

representado en grados $(^{o})$ por considerarse más gráfico. La acción de control que se ha aplicado por parte de los motores hasta llegar a la posición de equilibrio es

\begin{figure}[h!]				
\begin{center}
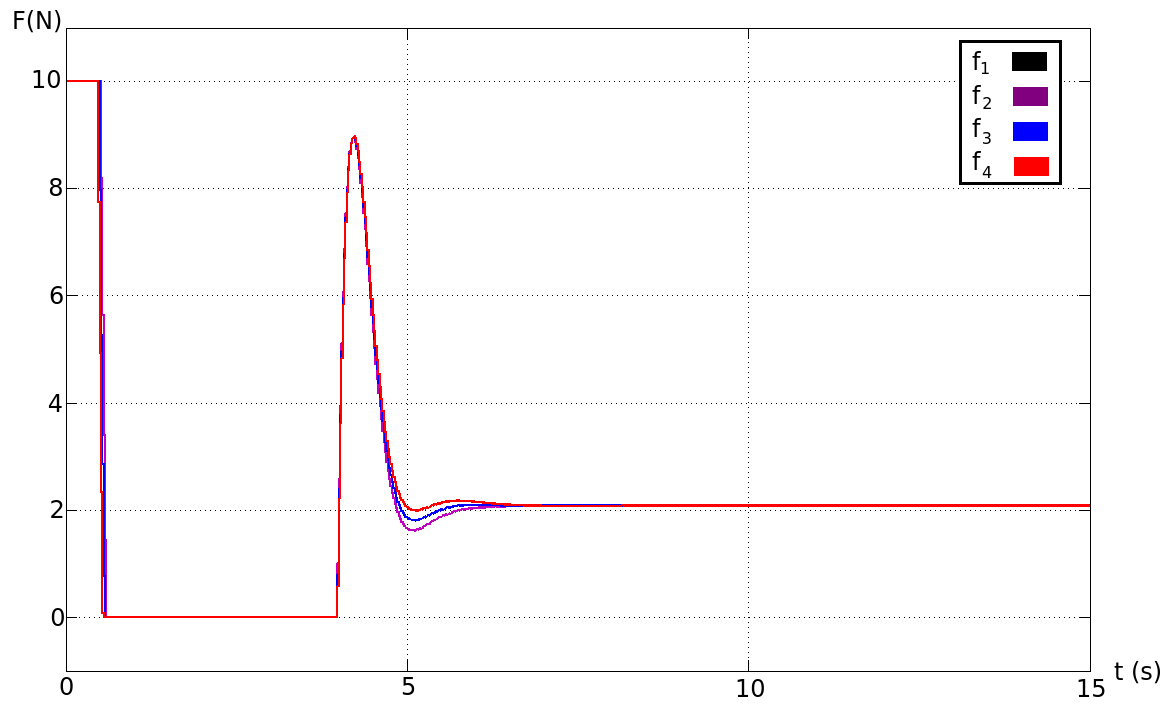
[picture p19: Latex project/images/simulation_1_1.png]

\end{center}
\caption{Acciones de los motores en la simulación}
\end{figure}

Se hace notar que las acciones de los actuadores estan saturadas con límites tanto inferior como superior y el control implementado no contempla tales no linealidades. Por ello el control no es óptimo y se tarda más, aún seguir siendo estable, en alcanzar la consigna. Se detecta también un comportamiento extraño en la evolución del mismo ángulo, que se atribuye a la no linealidad del modelo.
	
\newpage
\chapter{Implementación del control} \label{implement}
% \section{Implementación del control} \label{implement}

El implementar un control implica hacer capaz al sistema en cuestión de poder recibir la información necesaria para calcular las acciones de control apropiadas y atacar con éstas al sistema. \\

Las funciones que debe realizar la Raspberry Pi en este caso son las de captar tanto la consigna como los sensores, y calcular qué señal PWM se les debe enviar a los cuatro motores que se tienen a partir del error entre estado y consigna: 

\begin{figure}[h!]
\begin{center}
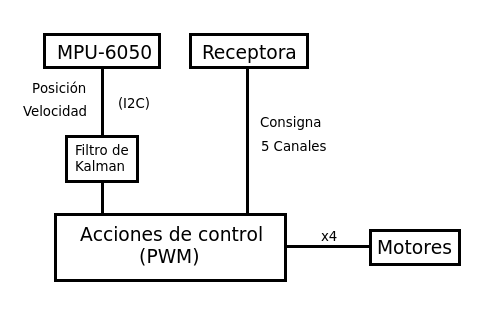
[picture p20: Latex project/images/flowchart.png]

\caption{Flowchart del código a ejecutar}
\label{flowchart}
\end{center}
\end{figure}

A los sensores giróscopo y acelerómetro se accede mediante el protocolo de comunicaciones $I2C$ con la librería $wiringPiI2C.h$ y se hace pasar la información por un filtro de Kalman ($Anexo\>\>C$) para quitar el ruido existente en las lecturas. De éstos se obtiene la posición y velocidad.

La consigna se obtiene de la Receptora. Ésta emite 5 señales PWM de iguales características que las que se envían a los motores, es decir, de 50 Hz con un ciclo de trabajo de entre el 5\% y 10\% y se leen del GPIO (General Purpose Input-Output) las 5 señales mediante interrupciones por cambio de flanco y flanco de bajada creadas con la librería $wiringPi.h$.

Mediante la consigna y la lectura de las estimaciones de los estados $\hat{\pmb{x}}_{k|k}$ se calcula con la matriz $\pmb{K}$, obtenida mediante el regulador LQR, la señal a enviar a los motores. Ésta tiene dos componentes: una está influenciada por la diferencia entre los estados  $\pmb{X}=[\phi \quad \dot{\phi} \quad \theta \quad \dot{\theta}]$ y la consigna, es decir, los valores que se desean que tomen. La otra componente viene dada por la persona que controla el aparato en cuestión: el $throttle$, es decir, cuánta fuerza se quiere que apliquen los actuadores (por igual) al sistema, que influirá en el impulso mecánico total del vehículo. 

Entonces, si $K_{i,j}$ es cada constante de la matriz $\pmb{K}$ (\ref{Kmatrix}) y si $f_i$ es la fuerza que requiere ser ejercida por cada motor $i-\acute{e}simo$ en gramos (pondios), éstas se obtienen en el bloque $Acciones\>\>de\>\>control$ de la figura \ref{flowchart} como: 

\begin{equation}
\begin{array}{l}
f_1=(K_{1,3}\cdot(-\theta+\theta_{c})+K_{1,4}\cdot(\dot{\theta}))\cdot \frac{1000}{9.81}+throttle \\
f_2=(K_{2,1}\cdot(-\phi+\phi_{c})+K_{2,2}\cdot(\dot{\phi}))\cdot \frac{1000}{9.81}+throttle \\
f_3=(K_{3,3}\cdot(-\theta+\theta_{c})+K_{3,4}\cdot(\dot{\theta}))\cdot \frac{1000}{9.81}+throttle \\
f_4=(K_{4,1}\cdot(-\phi+\phi_{c})+K_{4,2}\cdot(\dot{\phi}))\cdot \frac{1000}{9.81}+throttle \\ \end{array}
\end{equation}

donde $\phi_{c}$ y $\theta_{c}$ son las consignas. Finalmente, para hallar el ciclo de trabajo que deben tener las señales que se envían a los motores se usa la relación encontrada en el $Anexo\>\>D$ en la caracterización de los motores:

\begin{equation}
f_{i}=119\cdot PWM_{i} -613 \hspace{1cm} \longrightarrow \hspace{1cm}  PWM_{i}=\frac{f_{i}+613}{119}
\end{equation}

Para enviar la información se escribe según la especificación de la librería $pi-blaster$ en el archivo FIFO $/dev/pi-blaster$ (creado en la instalación de la misma) el PWM al que funcionará cada motor.

\newpage
\chapter{Construcción del Quadcopter} \label{construc}
% \section{Construcción del Quadcopter} \label{construc}
% Descripción de cómo se hará en general
El conjunto de piezas que forman este aparato están conectadas entre sí según la función que realicen. Esencialmente la Raspberry Pi controla los motores según les señales que recibe de la IMU y el Receptor. Todo el conjunto es alimentado por una batería LiPo y se adapta el voltaje de 11.1V a 5V por medio de un Regulador para poder alimentar a la Raspberry. Todos los componentes están sujetos a una estructura (Frame) que también subre las fuerzas y momentos.  

\section{Descripción de los componentes}
% Descripción y explicación de cada componente del Quadcopter, con imágenes de cada
Se describe seguidamente cada componente y el criterio de selección que se ha aplicado.
\subsubsection*{Raspberry Pi} 
Abreviado como RPi, es un pequeño ordenador integrado en una sola placa (Single-Board Computer o SBC en inglés) del tamaño de una tarjeta de crédito, es dir, con unas dimensiones de 85.6cm x 53.98cm, desarrollada por la Fundación Raspberry Pi con la intención de promocionar las ciencias computacionales en las escuelas: \cite{RPiWiki}. 

%\begin{tabular}{cc}
\begin{figure}[h!]
\begin{center}
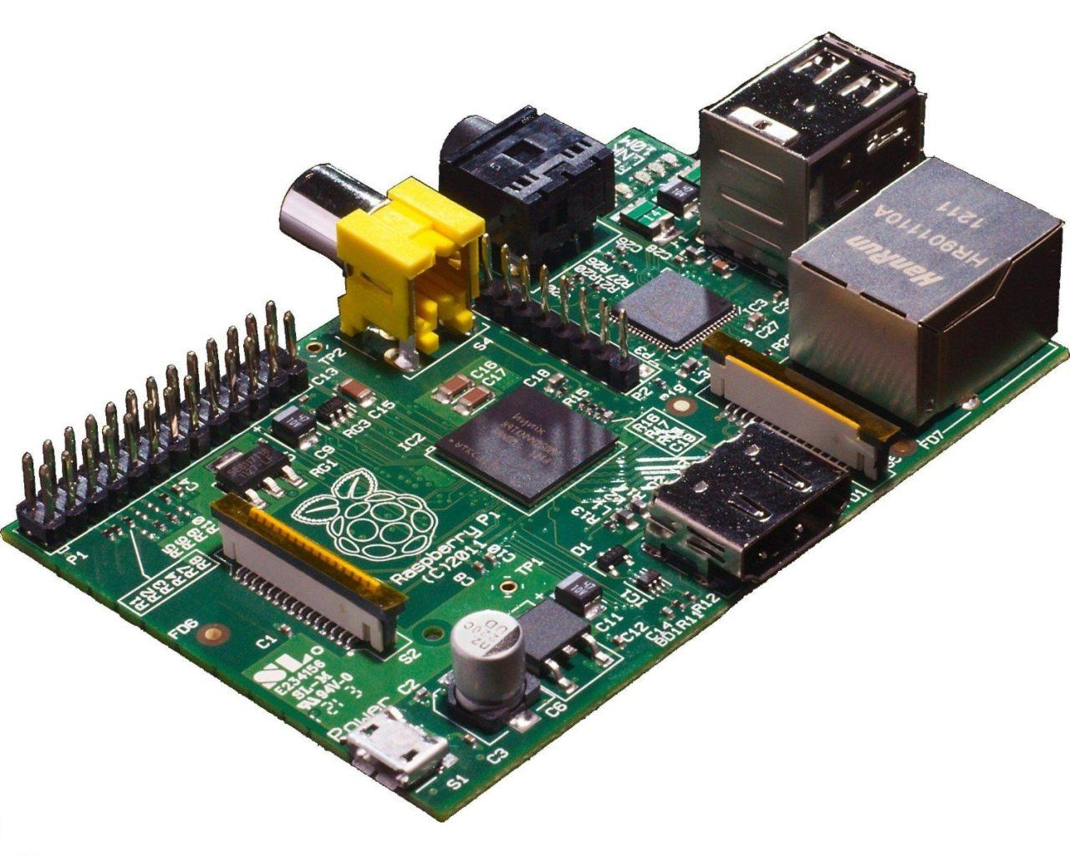
[picture p21: Latex project/images/RPi.png]

\caption{Raspberry Pi a utilizar}
\label{RPiImage}
\end{center}
\end{figure}
%\end{tabular}

Se ha optado por esta opción por su económico precio, la velocidad de procesamiento y bajo consumo. Además, se han querido ampliar los conocimientos de este pequeño monstruo. En particular se utiliza la segunda revisión del modelo B:

\begin{figure}[h!]
\begin{center}
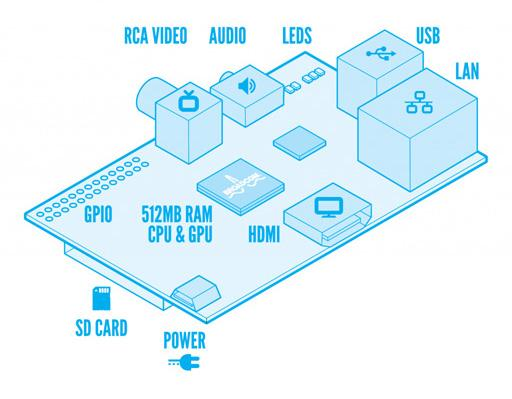
[picture p22: Latex project/images/RPi2.png]

\caption{Conectores de la Raspberry Pi}
\label{RPiConn}
\end{center}
\end{figure}

%\begin{tabular}{cc}
%\hspace{1cm}\includegraphics[scale=0.06]{images/RPi.jpg}
%& \hspace{0.5cm} \includegraphics[scale=0.3]{images/RPi2.jpg}
%\end{tabular} \\

Tiene un System-on-Chip (SoC) Broadcom BCM2835 con un ARM1176JZF-S a 700 Mhz, una GPU VideoCore IV y 512 MB de memoria RAM. Dispone de dos puertos USB, una salida mini-jack 3.5mm, salida de audio/vídeo HDMI, una salida RCA y un puerto  RJ45 10/100 de Ethernet. 

La alimentación se realiza por medio de un mini USB a 5V/700mA, con un consumo de 3.5W. El sistema operativo es un $Raspbian$, grabado en una tarjeta SD de 8GB. Dispone de un conjunto de pines que permiten comunicación con periféricos de bajo nivel UART, I2C, SPI y 8 pines de propósito general (General Porpouse Input Output o GPIO).

\subsubsection*{GY-521 MPU-6050} 
Utilizado a modo de Unidad de Medida Inercial (IMU en inglés) que integra en un mismo encapsulado de $4x4x0.9mm$ un acelerómetro y un giróscopo, ambos de 3 ejes. Dispone de un conversor ADC de 16 bits para cada eje y se comunica mediante un protocolo de comunicación $I2C$. Se ha optado por utilizar este dispositivo por su bajo coste y la fácil comunicación con la RPi.
\begin{figure}[h!]
\begin{center}
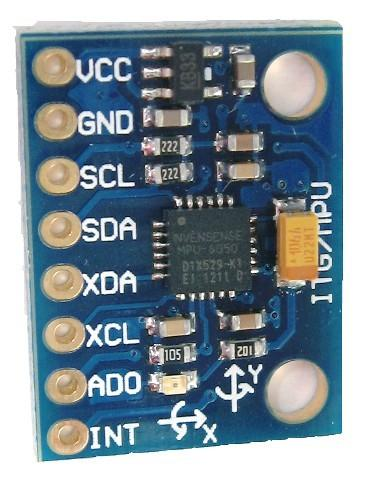
[picture p23: Latex project/images/mpu-6050.png]
 
\caption{IMU MPU-6050}
\end{center}
\end{figure}\\
Como características de los sensores: el giróscopo tiene un rango configurable de  $\pm250^{o}/s$, $\pm500^{o}/s$, $\pm1000^{o}/s$, $\pm2000^{o}/s$ y el acelerómetro de $\pm2g,\pm4g,\pm8g,16g$. La tensión de alimentación es del rango de $2.375V-3.46V$ y cabe la posibilidad de utilizar un módulo $DMP$ (Digital Motion Processor), pero se ha decidido implementar un filtro de Kalman para leer los datos en crudo (raw) de la cola $FIFO$ del sensor.

\subsubsection*{Emisor-Receptor}
Con este aparato de se transmite la consigna generada des del transmisor hacia el receptor mediante ondas de radio. El modelo que se utiliza es el $Turnigy\>\>5X\>\>5Ch\>\>Mini$, porque es fácil de utilizar y además económico. Las especificaciones técnicas más relevantes son: 

\begin{figure}[h!]
\begin{center}
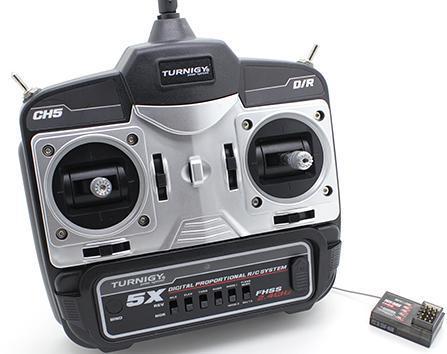
[picture p24: Latex project/images/E_R.png]
 
\caption{Emisora y Receptor}
\end{center}
\end{figure}

El transmisor tiene unas dimensiones de $156x152x50mm$, un peso de 265g y se alimenta a 6V (4 baterías AA). El receptor tiene unas medidas de $33.5x20.5x13mm$ y se alimenta a 4.8-6V. Dispone de 5 canales de radio, con transmisión segura a 2.4GHz con el método FHSS. Puede configurarse para trabajar con dos modos(mode1-mode2).

La señal que se recibe en cada canal en el receptor es un $PWM$ de $50Hz$ con un ciclo de trabajo entre $1ms$ y $2ms$. Las señales que se reciben son  : Aileron, Elevator, Throttle, Rudder y el Channel 5. 

%% Especificación por canal de los PWM: mínimo y máximo Duty
%% Mirar con osciloscopio la señal

\subsubsection*{Batería LiPo}
Para alimentar a todo el conjunto se utiliza una LiPo $Turnigy\>\>2200mAh\>\>3S1P\>\>25C$: 

\begin{figure}[h!]
\begin{center}
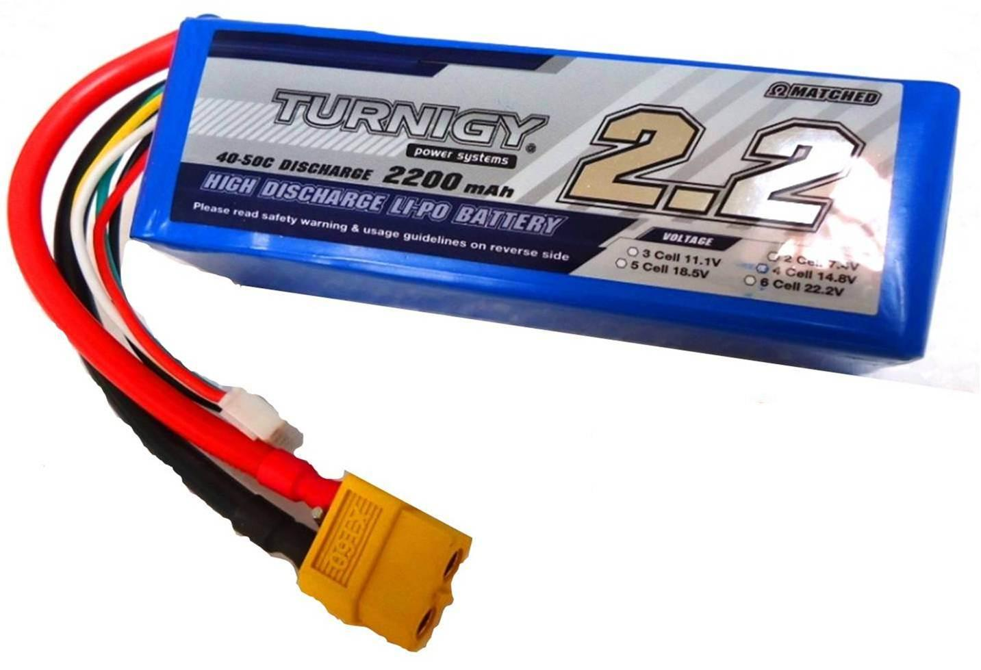
[picture p25: Latex project/images/LiPo.png]
 \\
\caption{Batería LiPo empleada}
\end{center}
\end{figure}

%viewport=0 400 2560 1250,clip

Por tanto, es capaz de entregar 2.2A durante una hora, y como la capacidad es de 25C, la descarga puede ser de $2.2*25=55A$ con un pico de descarga de 35C, es dir, con un pico de $2.2*35=77A$ durante 10 segundos. Esta batería está formada por tres celdas que proporcionan un voltaje total de unos $11.1V$.

El conector de carga es el $JST-XH$ y el de descarga el $XT60$. De cara al diseño del Quadcopter, es interesante saber que pesa $188g$ y respecto al dimensionado de la estructura (frame) que sus dimensiones son de $105x33x24mm$.

\subsubsection*{Regulador Step-Down}
Para adaptar la tensión de 11.1V de la batería LiPo a 5V para alimentar la Raspberry Pi, es necesario un regulador. En este caso se tiene el Interruptor-Modo Máximo BEC LM2576S, que proporciona hasta 3A de corriente.

%\begin{figure}[h!]
%\begin{center}
%\includegraphics[scale=0.06]{images/Reg_stepdown.jpg}
%\caption{Regulador Step-Down}
%\end{center}
%\end{figure}

El esquema del componente \cite{lm2576s}:

\begin{figure}[h!]
\begin{center}
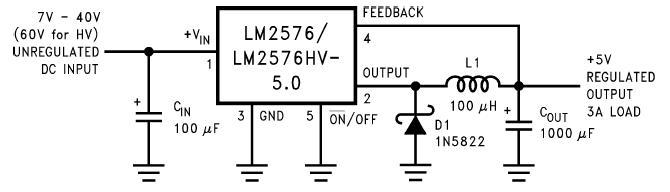
[picture p26: Latex project/images/lm2576s.png]
 
\caption{Esquema del Regulador Step-Down}
\end{center}
\end{figure}

\subsubsection*{Motores Brushless}
Los actuadores que se utilizan son motores brushless (BL-DC). En particular el Turnigy 2213 20turn 1050kv 19A Outrunner.
Se trata de máquinas síncronas de imanes permanentes, con un campo magnético repartido uniformemente en el entrehierro. Se conocen también de fuerza electromotriz (FEM) trapezoidal porque a velocidad constante la FEM tiene esta forma. 
Para controlarlo se utiliza un inversor (inverter), y como la conmutación deja de ser mecánica la armadura de la máquina puede ser el estátor. Ésto permite llegar a voltajes de uso y velocidades de funcionamiento más altos.
Sus especificaciones más relevantes son:
\begin{itemize}
\item Kv: 1050rpm/V
\item Corriente de trabajo: 6A ~ 16A
\item Corriente de pico: 19A
\item Peso: 56g
\item Dimensiones: 27.6 x 32mm
\item Medida de el eje: 3.175mm
\end{itemize}

El primer parámetro hace referencia a cuántas rpm's funcionará el motor por Voltio aplicado. A este valor se le aplica un porcentaje $\%NLS$ (Porcentaje de Velocidad sin Carga, típicamente de 70\%) para saber cuántas revoluciones por minuto funcionará:

\begin{equation}
Kv  \cdot V \cdot \%NLS = 1050 \cdot \frac{rpm}{V}\cdot V \cdot 0.70 = 8085 \>\> rpm
\end{equation}

Esta velocidad es teórica, y como no hay un lazo de control sobre ésta no se tendrá en cuenta, siendo éste un valor orientativo. En cambio, se atacará al motor con la señal de PWM que se envía al Variador que lo controla. La relación entre la señal de PWM y la fuerza, así como el consumo que se desarrolla se encuenta en los Anexos. 

\subsubsection*{Variador ESC}

Para controlar un motor brushless la etapa de potencia a utilitzar es un ESC (Electronic Speed Controller) que es un  variador que se compone de un inversor trifásico:
\begin{figure}[h!]
\begin{center}
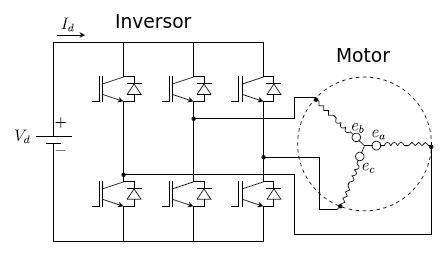
[picture p27: Latex project/images/ESC.png]

\caption{Esquema de un Variador como inversor trifásico}
\end{center}
\end{figure}
El modelo a utilitzar es el Turnigy AE-20A Brushless ESC. El uso de éste en particular se justifica con el amperaje que soporta, en cuanto los motores consumen un pico de hasta 19A, que es menor a la màxima corrente de este Variador (como límite se puede quemar el componente si se hacen circular 25A durante 10 segundos). 
Se debe asegurar la compatibilidad con la batería también, ya que soporta tensiones de entrada correspondientes a Baterías LiPo de entre 2 y 4 celdas. 

Incluye un circuito BEC (Battery Eliminator Circuit) para poder alimentar también el receptor de 2A de máxima corriente. 
La máxima velocidad de funcionamiento del motor depende de sus polos: si es de 2 polos será de 210000 rpm, con 6 polos de 70000 rpm y de 12 polos a 35000 rpm.

Tanto el peso de $19$g,  como las dimensiones de $50x26x12$mm son parámetros a tener en cuenta en el montaje, ya que se hubican en los brazos del Quadcopter, aumentando la inercia por eje e influyendo considerablemente en el modelo. Antes de usar cada Variador se ha tenido que programar para que éste responda con un mejor rendimiento al caso en cuestión.

\begin{figure}[h!]
\begin{center}
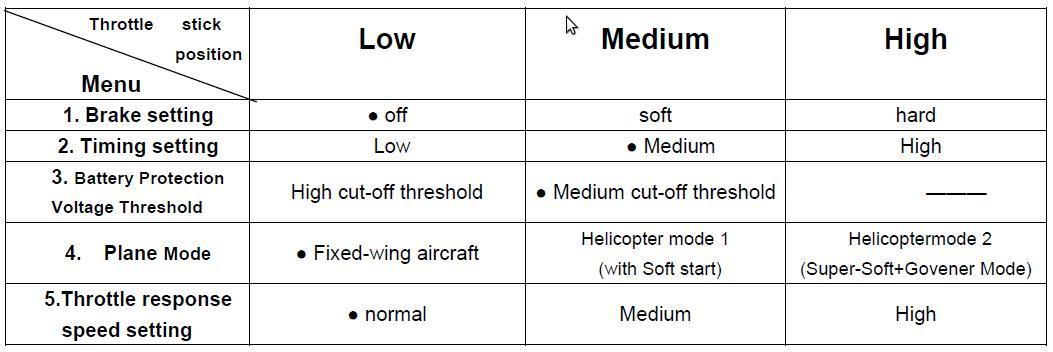
[picture p28: Latex project/images/ESC_config.png]

\caption{Tabla de Set up de un ESC}
\end{center}
\end{figure}

Para los 5 parámetros a configurar hay tres opciones, y las marcadas con un punto son las que se han aplicado.

\subsubsection*{Marco}

Todos los elementos que componen el Quadcopter se sujetan en una estructura que mantiene la integridad y rigidez necesarias para el vuelo. Para el caso se tiene el modelo $F330\>\>Wheelbase\>\>330mm$:

\begin{figure}[h!]
\begin{center}

\caption{Piezas que componen la estructura del Quadcopter}
\end{center}
\end{figure}

La mayor parte del peso se concentra en el centro de la estructura e interesa que sea lo más ligera posible sin comprometer su integridad, de tal manera que los motores, situados en las puntas de cada brazo, deban compensar el menor peso posible. En este caso tiene un peso de 190g y las piezas están hechas de fibra de vidrio las centrales (de color negro en la imagen) y de Nylon los brazos (rojo y blanco en la imagen). La distancia entre dos motores de una diagonal es de 33cm.

\subsubsection*{Hélices}

En girar el motor, las aspas solidarias a su eje utilizan la energía cinética del rotor para proporcionar sustentación propulsando aire en sentido contrario. El tipo de aspa condiciona el rendimiento que se obtenga, así que se utilizan las que optimizan la fuerza de propulsión respecto al consumo de corriente. El modelo de hélice utilizado es el 8x4

\begin{figure}[h!]
\begin{center}
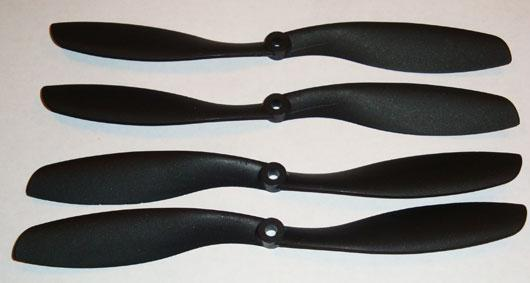
[picture p29: Latex project/images/propellers4.png]

\caption{Hélices 8x4 simétricas}
\end{center}
\end{figure}

% ,viewport=0 200 2560 1100,clip

Los parámetros que definen una hélice son su Longitud ($X$), és decir, diámetro de superficie recorrida por las aspas en pulgadas, y el Pitch ($Y$), que es la distancia que se avanzaría la hélice en una revolución de moverse en una masa blanda. Se representan en el siguiente gráfico:

\begin{figure}[h!]
\begin{center}

\caption{Representación de la Longitud y Pitch de una hélice de dos aspas}
\end{center}
\end{figure} 

\newpage
\section{Montaje}

En la unión de todos los componentes se ha optado por hacer uso de la impresión 3D para crear las piezas que se han necesitado en la unión de las mismas. En el ensamblaje de los componentes, se ha empezado con el Frame: \\

\begin{figure}[h!]
\begin{center}
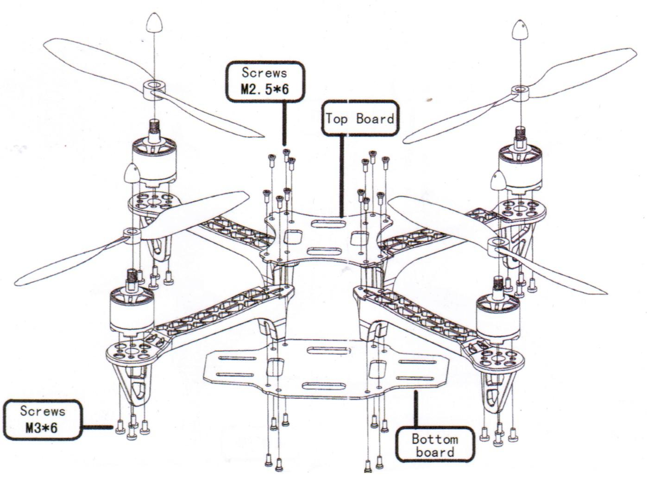
[picture p30: Latex project/images/frame_mount.png]

\end{center}
\caption{Ensamblaje del esqueleto del Quadcopter}
\end{figure}

Dado que no se tiene una montura para la Raspberry Pi y demás piezas, se diseñan dos piezas a modo de soporte para la electrónica, con el fin también de proteger tales componentes. Se sujetarán a estas piezas la Raspberry Pi y el Receptor: \\

\begin{figure}[h!]
\begin{center}
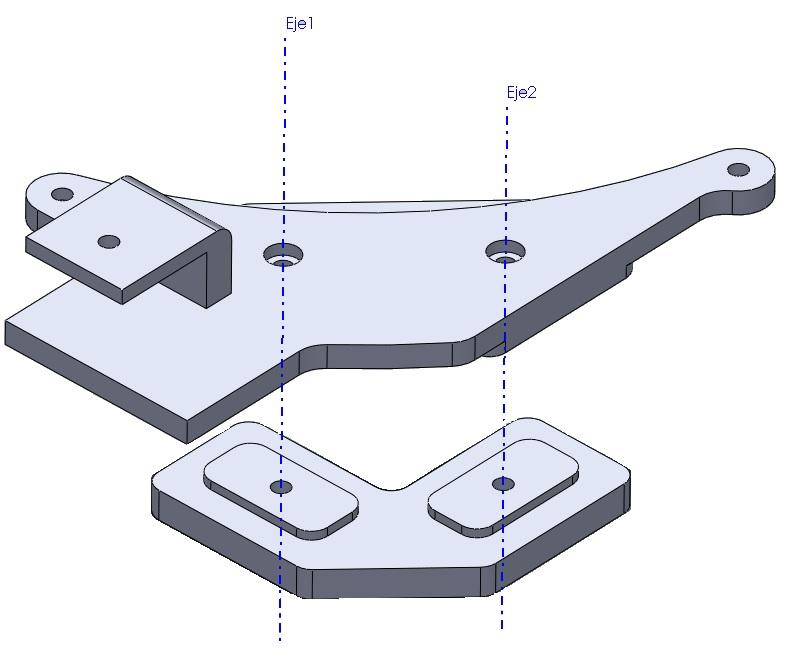
[picture p31: Latex project/images/ensamblaje_rpi_mount.png]

\end{center}
\caption{Ensamblaje de la montura de la RPi y el Receptor}
\end{figure}

Atornillados los motores, se sueldan a éstos los variadores, sujetándolos con bridas y teniendo en cuenta que se quiere que se quiere que el sentido de rotación de éstos sea opuesto en las diagonales:\\

\begin{figure}[h!]
\begin{center}
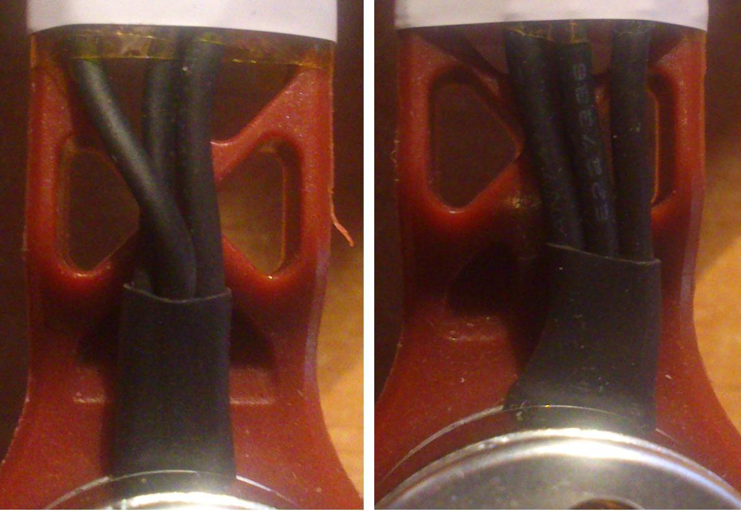
[picture p32: Latex project/images/comp_motor_wires.png]

\end{center}
\caption{Detalle del cruce de fases en los motores}
\label{detalle_cable_motor}
\end{figure}

Para tener un vuelo estable es necesario asegurar la sugeción de la batería al marco. En ser ésta el elemento más pesado de todos de los que componen el aparato, de moverse sería el que más contribuiría en un cambio de los parámetros del sistema, i.e.: los momentos de inercia $I_{xx}$ y $I_{yy}$. Se montan entonces escuadras que se atornillan a la estructura para fijar su posición. \\

En despegar se tiene un efecto aerodinámico no considerado en el modelo denominado "$Efecto \>\> suelo$". Se trata de las perturbaciones del aire que, en encontrarse con el suelo, afectan al funcionamiento de las hélices. Para evitar este efecto no deseado se decide elevar la altura inicial del Quadcopter con una extensión de las patas mediante piezas imprimidas: \\

\begin{figure}[h!]
\begin{center}
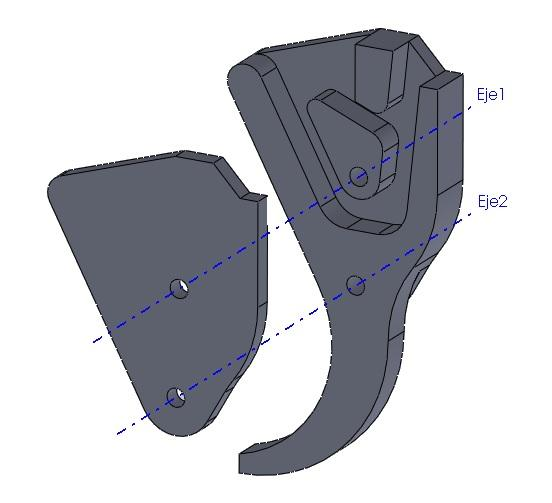
[picture p33: Latex project/images/ensamblaje_pata.png]
 \hspace{1.5cm}
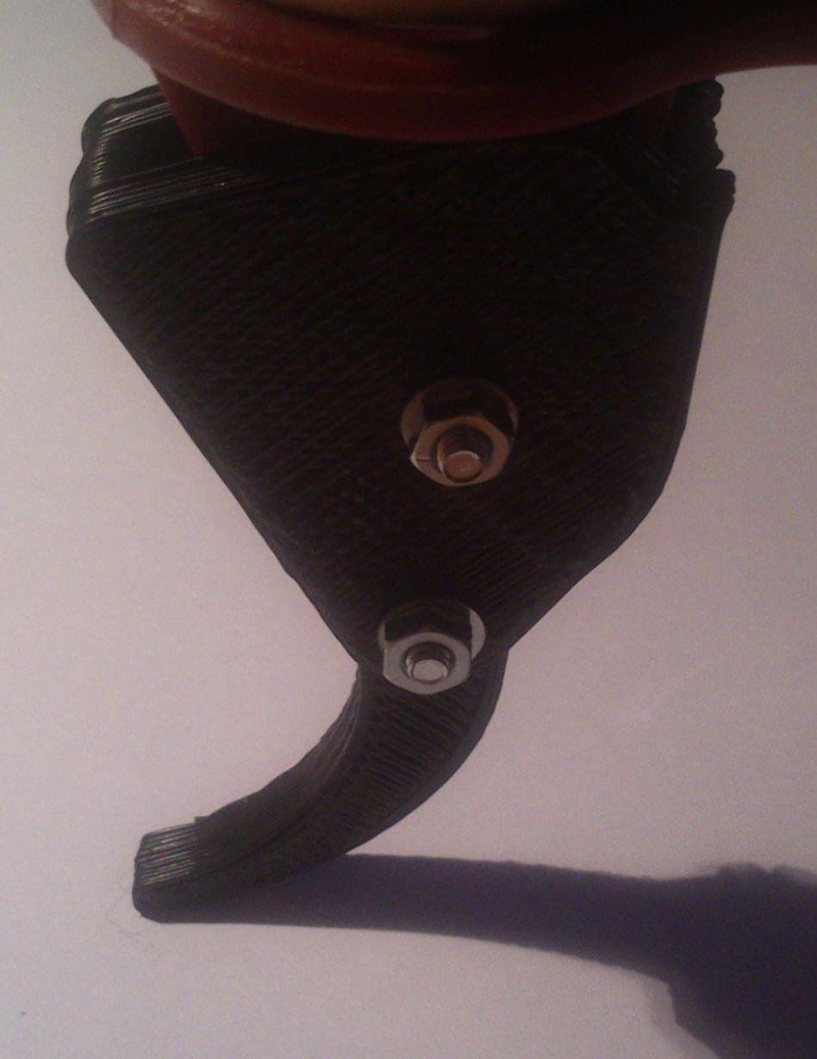
[picture p34: Latex project/images/detalle_pata.png]

\end{center}
\caption{Ensamblaje y detalle de una de las patas.}
\end{figure}

Y finalmente se fija el Regulador Step-Down a la estructura mediante bridas. En lo referente al conexionado, el esquema que se sigue es \\

\begin{center}
\begin{tikzpicture}
%%% POWER LINES
\path[draw] (1,8.25) node {\large 12V};
\path[draw] (2,8.25) node {\large 0V};
\path[draw,line width=6pt,color=red,o-o] (1,1) -- (1,8);
\path[draw,line width=6pt,color=black,o-o] (2,1) -- (2,8);

%%% LIPO LEVEL
\path[draw,line width=2pt,color=red] (1,6) -- (3,6);
\path[draw,line width=2pt,color=black] (2,5.5) -- (3,5.5);
\path[draw] (3.8,5.75) node[draw,line width=3pt] (nodeA) {\huge LiPo};
\path[draw] (7.2, 5.75) node[draw,line width=3pt] (nodeA) {\huge IMU};
\path[draw,line width=2pt,color=olive] (7.2,5.35) -- (7.2,4.6);
\path[draw] (7.6,5) node (nodeC) { I2C};
\path[draw] (9.8, 5.75) node[draw,line width=3pt] (nodeA) {\huge Rec.};
\path[draw, line width=2pt,color=green] (9.8, 5.34) -- (9.8, 4.5) -- (7.95, 4.5);
\path[draw] (9, 4.8) node {5xCHNL};
\path[draw,line width=2pt,dotted, color=cyan](10.6,5.75) -- (12.3,5.75);
\path[draw] (13, 5.75) node[draw,line width=3pt] (nodeA) {\huge Em.};

%\node[draw, minimum width=2cm, minimum height=1cm, anchor=south west, text width=2cm, align=center] (A) at (LLA) {Impedance\\control};

%%% BUCK LEVEL
\path[draw,line width=2pt,color=red] (1,4.5) -- (3,4.5);
\path[draw,line width=2pt,color=black] (2,4) -- (3,4);
\path[draw] (4.1,4.25) node[draw,line width=3pt] (nodeA) {\huge BUCK};
\path[draw,line width=2pt,color=red] (5.26,4.5) -- (6.5,4.5);
\path[draw,line width=2pt,color=black] (5.2,4) -- (6.5,4);
\path[draw] (7.2,4.25) node[draw,line width=3pt] (nodeA) {\huge RPi};
\path[draw] (5.8,4.8) node (nodeC) {5V};
\path[draw, line width=2pt, color=green] (7.95,4)--(9.8,4) -- (9.8,3.2);
\path[draw] (9.2,3.65) node {PWM};

%%% ESC LEVEL
\path[draw, line width=2pt, color=red] (1,3) -- (9,3);
\path[draw, line width=2pt, color=black] (2,2.5) -- (9,2.5);
\path[draw] (9.8,2.75) node[draw,line width=3pt] (nodeC) {\huge ESC};
\path[draw] (10.3,2.1) node (nodeC) {\large (x4)};
\path[draw, line width=2pt, color=blue] (10.6,3) -- (12,3);
\path[draw, line width=2pt, color=blue] (10.6,2.75) -- (12,2.75);
\path[draw, line width=2pt, color=blue] (10.6,2.5) -- (12,2.5);
\path[draw] (13,2.75) node[draw,line width=3pt] (nodeC) {\huge Motor};
\path[draw] (13.7,2.1) node (nodeC) {\large (x4)};
\end{tikzpicture}
\end{center}

Se han introducido conectores en las tomas positivas de cada ESC para poder programar cada uno por separado de ser necesario. \\

A cada motor se le atornilla la hélice adecuada según su sentido de giro, que viene dado por el orden en que se han soldado las fases del actuador, según \ref{detalle_cable_motor}.\\

El resultado final es:

%\textbf{Figura con el resultado final}
\begin{figure}[h!]
\begin{center}
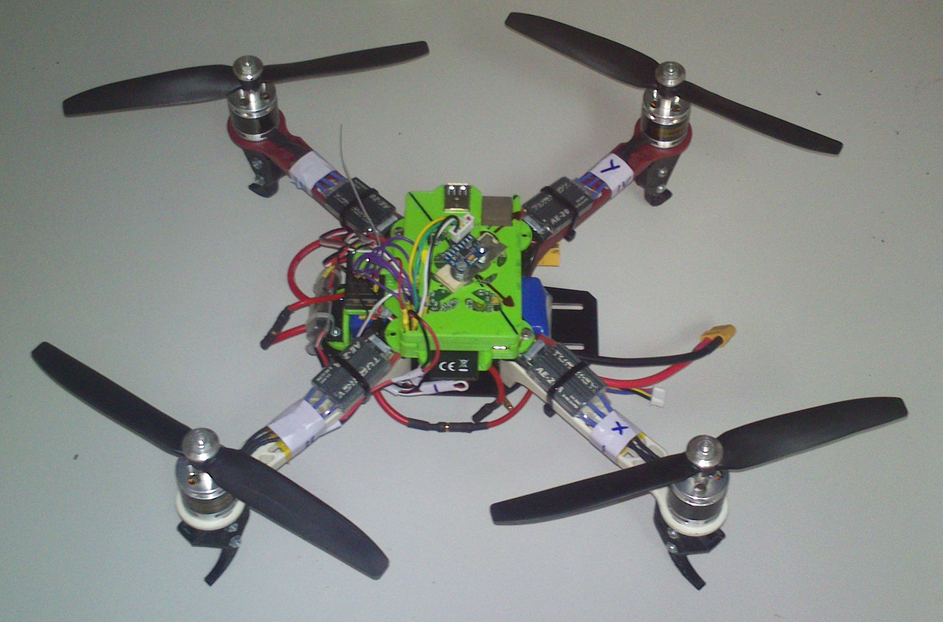
[picture p35: Latex project/images/qc_final.png]

\caption{Vehículo finalizado}
\end{center}
\end{figure}

\newpage

\chapter{Análisis económico} \label{economics}

Como en todo proyecto es importante conocer y justificar el gasto económico implicado. En no ser éste una excepción, se desglosan los costes asociados, tanto materiales como los de mano de obra. \\
Referente a los costes materiales, se incluye el de todos los elementos que componen el Quadcopter, así como otros igualmente necesarios como el cargador de las baterías. Se considera que el trabajo se ha realizado por un estudiante en desarrollo de su Proyecto Final de Carrera. El coste que se le supone por el tiempo del digno obrero es de $6$€$/ hora$. \\  
%\hspace{-1cm}
\begin{figure}[h!]
\hspace{0.6cm}
\begin{tabular}{|l|r|r|r|}
\hline

\hspace{2cm}\textbf{Componente} & \textbf{Precio}(€ /u) & \textbf{Cantidad} & \textbf{Coste}(€) \\
%\textbf{Componente} & \textbf{Precio unitario} & \textbf{Cantidad} & \textbf{Coste}(€) \\

\hline
\hline
Conector XT60 macho & 0.36 & 1 & 0.36 \\
Cable 12AWG (1 metro) Turnigy & 2.2 & 1 & 2.20 \\
Emisor-Receptor Mini Turnigy 5X 5Ch & 24.99 & 1 & 24.99 \\
Batería Turnigy LiPo 2200mAh 3S 25C & 10.57 & 2 & 21.14 \\
Motor Turnigy 2213 20turn 1050kv 19A & 14.53 & 4 & 58.12 \\
Variador Turnigy AE-20A Brushless & 10.48 & 4 & 41.92 \\
Pack 4 hélices 8x4 & 2.28 & 1 & 2.28 \\
Pack 4 hélices 8x4R & 2.28 & 1 & 2.28 \\ 

Cargador LiPo iMAX B6 & 16.95 & 1 & 16.95 \\
\hline \cmidrule{2-4}

%Cargador lipo & 16.95 & 1 & 16.95 \\
%\hline \cmidrule{3-4}

%\hline
\multicolumn{1}{r}{} & \multicolumn{2}{|l|}{\textbf{Total del Coste material}} & 170.24 €\\ \cmidrule{2-4}
\multicolumn{4}{r}{} \\
\hline
\hspace{1.5cm}\textbf{Recursos Humanos} & \textbf{Coste}(€/hora) & \textbf{Horas} & \textbf{Coste}(€) \\
\hline
\hline
Estudiante de PFC & 6 & 540 & 3240 \\
\hline \cmidrule{2-4}
%\hline
\multicolumn{1}{r}{} & \multicolumn{2}{|l|}{\textbf{Total R.R. H.H.}} & 3240 €\\ \cmidrule{2-4}
\multicolumn{4}{r}{} \\
\cmidrule{3-4}
\multicolumn{2}{r}{} & \multicolumn{1}{|l|}{\textbf{TOTAL}} & 3410.24 €\\ \cmidrule{3-4}
\end{tabular} 
\end{figure}
\newpage

\chapter{Impacto ambiental} \label{impacto}

En el desarrollo del presente proyecto se ha construido un aparato  compuesto por partes de diferentes materiales, de entre los que destacan el ABS, Nylon y fibra de vidrio. No se estudiará el  impacto medioambiental del complejo proceso de producción, uso y reciclaje de los mismos, sino un comentario del impacto que éstos generan en general. \\

Por parte de la fibra de vidrio, se considera un material de baja toxicidad debido a sus diferencias con los cancerígenos asbestos. En poder fabricarse las fibras a partir de vídrio reciclado, el impacto de este material al medio se considera bajo.

Por otro lado, el Nylon es una poliamida de gran resistencia a la corrosión ambiental. Por este motivo éste es uno de los plásticos que más han contribuido en el incremento de los niveles de contaminación. Los tiempos de degradación del Nylon son muy largos y sus residuos muy perjudiciales para el medio ambiente. Por ello es de gran importancia tener una consolidada etapa de reciclado de éste material, también para otros polímeros parecidos a éste.

Respecto al ABS, se trata de un plástico de ingeniería que de la misma manera que el Nylon por su resistencia térmica y química, debe reciclarse y tratarse los residuos. \\

Como sistema de alimentación para el quadcopter se usan baterías del tipo LiPo, conocidas también como de ion de litio. Éstas son muy contaminantes de no tratarse adecuadamente en la fase de reciclado y requieren estar completamente descargadas antes de ser entregadas a un punto de recogida.

\newpage

\chapter{Conclusiones} \label{conclusiones}

Concluido el trabajo, se tiene como resultado el modelo de un Quadcopter definido a partir de sus parámetros característicos, los cuales se han obtenido a partir de procedimientos eminentemente heurísticos. Dado cualquier Quadcopter, éste puede ser representado por el modelo.

Se ha obtenido un modelo no lineal, pero a la hora de diseñar el controlador conveniente se ha  linealizado el sistema. Se ha atacado al sistema mediante un control basado en un regulador LQR en función de las características del vehículo, por lo que adoptando un criterio adecuado a la hora de imponer los pesos en la función de costes con $\mathbf{Q}$ y $\mathbf{R}$ el vehículo podría estabilizarse.

A pesar de atacar un sistema fuertemente no lineal mediante un controlador lineal, en la simulación se obtiene como resultado que el vehículo se estabiliza, aún mostrar un comportamiento no lineal en estar alejado del punto de equilibrio. \\

Como los resultados distan mucho de ser óptimos, se esperan añadir mejoras en el futuro y mantener al proyecto en constante evolución. Por ello se mantiene en el repositorio  $https://github.com/Gabrieldelacal/PFC$ toda la información y material necesario tanto para seguir mejorando el trabajo como para que, quien lo desee, clonar el repositorio y seguir por cuenta propia.

\newpage

\chapter*{Agradecimientos}

Un trabajo de esta índole no podría haber sido posible sin la ayuda y apoyo de quienes, sin o con la aportación directa en el proyecto, lo han hecho realmente posible. \\

A la familia, la verdadera $Alma\>\>Mater$, por su apoyo,  soporte y paciencia en la convivencia durante mis peores momentos, que no han sido pocos. A Manel Velasco y Cecilio Angulo, tutores y mentores de este pobre $umpa\>\>lumpa$ de la ciencia, por la guía, consejos y espacio de trabajo tan amablemente proporcionados en esta empresa. A Joan Guasch y Diego Muñoz, porque es importante hacer ameno el trabajo en los días poco fructíferos, que tan pesados son. 

\newpage

\begin{thebibliography}{99}
\bibitem{QuadPaper} Teppo Luukkonen (August 22,2011). \textit{Modelling and control of quadcopter}
\bibitem{RPiWiki} Wikipedia de la Raspberry Pi: \url{http://en.wikipedia.org/wiki/Raspberry_Pi}
\bibitem{IMUArduino} Acelerómetro y giroscopio MPU-6050 para Arduino: \url{http://playground.arduino.cc/Main/MPU-6050#.UzhsVCK9jb4}
\bibitem{6050Esp} MPU-6050. Especificación del producto: \url{http://www.invensense.com/mems/gyro/documents/PS-MPU-6000A-00v3.4.pdf}
\bibitem{6050RegMap} MPU-6050. Mapa de Registros y descripciones: \url{http://www.invensense.com/mems/gyro/documents/RM-MPU-6000A-00v4.2.pdf}
\bibitem{lm2576s} LM2576S Datasheet: \url{http://www.ti.com/lit/ds/symlink/lm2576.pdf}
\bibitem{wiringPi} Librería wiringPi: \url{http://wiringpi.com/}
\bibitem{LQR_Wikipedia} Artículo sobre LQR de Wikipedia: \url{http://en.wikipedia.org/wiki/Linear-quadratic_regulator}
\bibitem{LQR_Matlab} Documentación de la función LQR de Matlab: \url{http://www.mathworks.es/help/control/ref/lqr.html;jsessionid=8f737c267ee85a89cc2544a09a44}
\bibitem{Toolbox_lqr} Toolbox de Matlab del LQR : \url{http://www.mathworks.es/es/help/control/ref/lqr.html}
\bibitem{Lagrangian_Matlab} Ecuaciones de Lagrange en Matlab: \url{http://www.mathworks.com/matlabcentral/fileexchange/23037-lagranges-equations/content/Lagrange.m}
\bibitem{pi-blaster} Github de la librería pi-blaster: \url{https://github.com/sarfata/pi-blaster/}
\end{thebibliography}{}

\newpage

\addcontentsline{toc}{chapter}{ANEXOS}
\chapter*{ANEXOS}
\section*{Anexo A: Obtención del vector de fuerzas}

El archivo que se ejecuta para obtener el modelo parte de los parámetros necesarios para caracterizar el sistema como variables simbólicas. A partir de ellas se extrae el modelo. Se comenta por partes el código Matlab del que se extrae toda la información. \\

Se inicializan las variables simbólicas implicadas en el Lagrangiano y las necesarias en el modelo:

\singlespacing
\begin{lstlisting}[language=Matlab]
clear all
clc

%%% Para usar la funcion Laplace en el archivo Laplace.m se deben declarar las variables de esta manera:

syms x dx ddx y dy ddy z dz ddz Phi dPhi ddPhi Theta dTheta ddTheta Psi dPsi ddPsi
syms f1 f2 f3 f4 		    % fuerza motores
syms Ixx Iyy Izz				% Inercias
syms Ax Ay Az                % No considerados
syms k m g l b

l=0.165             % longitud de los brazos (m)
Ixx=0.007931           % Momento de inercia del eje x (kg*m2) 
Iyy=0.007664           % Momento de Inercia del eje y
Izz=0.009741           % Momento de Inercia del eje z
m=0.96              % Peso del Quadcopter (kg)
g=9.81              % gravedad (m/s2)
\end{lstlisting}

Se agrupan adecuadamente las variable en vectores, tal y como se especifica en el capítulo \ref{def}:

\begin{lstlisting}[language=Matlab,firstnumber=18]
% El vector de variables que se usaran

v=[x dx ddx y dy ddy z dz ddz Phi dPhi ddPhi Theta dTheta ddTheta Psi dPsi ddPsi]

Xi=[x; y; z]
dXi=[dx; dy; dz]

Eta=[Phi; Theta; Psi]
dEta=[dPhi; dTheta; dPsi]

Q=[Xi; Eta]
dQ=[dXi; dEta]

II=[[Ixx 0 0];
    [0 Iyy 0];
    [0 0 Izz]]

A=[[Ax 0 0];
   [0 Ay 0];
   [0 0 Az]]   
   
T=f1+f2+f3+f4        % Fuerza total (Total Thrust)
TB=[0; 0; T]         % Thrust en la referencia del Quadctopter

TauB=[l*(f4-f2);
      l*(f3-f1);
      b*(f1-f2+f3-f4)]   
\end{lstlisting}
\onehalfspacing
Se declaran las matrices de rotación, transformación de velocidad angular a derivada de ángulos de Euler, matriz de inercia y finalmente el Lagrangiano del sistema:
\singlespacing
\begin{lstlisting}[language=Matlab,firstnumber=45]
R=[[cos(Psi)*cos(Theta) cos(Psi)*sin(Theta)*sin(Phi)-sin(Psi)*cos(Phi) cos(Psi)*sin(Theta)*cos(Phi)+sin(Psi)*sin(Phi)];
    [sin(Psi)*cos(Theta) sin(Psi)*sin(Theta)*sin(Phi)+cos(Psi)*cos(Phi) sin(Psi)*sin(Theta)*cos(Phi)-cos(Psi)*sin(Phi)];
    [-sin(Theta) cos(Theta)*sin(Phi) cos(Theta)*cos(Phi)]]

Weta=[[1 0 -sin(Theta)];
      [0 cos(Phi) cos(Theta)*sin(Phi)];
      [0 -sin(Phi) cos(Theta)*cos(Phi)]]
  
J=transpose(Weta)*II*Weta  
  
L=m/2*transpose(dXi)*dXi+(1/2)*transpose(dEta)*transpose(Weta)*II*Weta*dEta-m*g*z
\end{lstlisting}
\onehalfspacing
Aqui se obtiene con el Lagrangiano el vector de fuerzas F según la ecuación 
\begin{equation}
\mathbf{F}=\frac{d}{dt}\left( \frac{\partial \mathcal{L}}{\partial \dot{\pmb{q}}} \right) - \frac{\partial \mathcal{L}}{\partial \pmb{q}}
\end{equation}

a partir de la función implementada en Lagrange.m implementada \cite{Lagrangian_Matlab} \\

\begin{lstlisting}[language=Matlab,firstnumber=56]
F=Lagrange(L,v)
\end{lstlisting}

Para tener una expresión analítica del producto $\pmb{C(\eta,\dot{\eta})\cdot \dot{\eta}}$ se requiere haber derivado a mano hasta la ecuación \ref{3.24} para ver que 

\begin{equation}
\pmb{\tau}=\pmb{J}\ddot{\pmb{\eta}} + \pmb{C(\eta,\dot{\eta})\cdot \dot{\eta}}
\end{equation}

y saber cómo aislar el producto
\singlespacing
\begin{lstlisting}[language=Matlab,firstnumber=57]
%%% Derivando a mano se obtiene que TauB=J*ddEta+CdEta 
%%% Y como TauB=[F(4); F(5); F(6)], se tiene que el termino de Coriolis es:

CdEta=[F(4); F(5); F(6)]-J*[ddPhi; ddTheta; ddPsi]

%%% Hasta se tiene el producto Coriolis(Eta,dEta)*dEta. Pero como matlab
%%% no elimina las aceleraciones se hace a mano, y queda:

CdE1=(Iyy*dTheta^2*sin(2*Phi))/2 - (Izz*dTheta^2*sin(2*Phi))/2 - Ixx*dPsi*dTheta*cos(Theta) - (Iyy*dPsi^2*sin(2*Phi)*cos(Theta)^2)/2 + (Izz*dPsi^2*sin(2*Phi)*cos(Theta)^2)/2 - Iyy*dPsi*dTheta*cos(2*Phi)*cos(Theta) + Izz*dPsi*dTheta*cos(2*Phi)*cos(Theta);

CdE2=-dPhi*(Ixx*dPsi*cos(Theta) + 2*Iyy*dTheta*cos(Phi)*sin(Phi) - 2*Izz*dTheta*cos(Phi)*sin(Phi) + Iyy*dPsi*cos(Phi)^2*cos(Theta) - Izz*dPsi*cos(Phi)^2*cos(Theta) - Iyy*dPsi*cos(Theta)*sin(Phi)^2 + Izz*dPsi*cos(Theta)*sin(Phi)^2) - Ixx*dPsi^2*cos(Theta)*sin(Theta) + Iyy*dPsi^2*cos(Theta)*sin(Phi)^2*sin(Theta)+ Izz*dPsi^2*cos(Phi)^2*cos(Theta)*sin(Theta);

CdE3= dPhi*(Ixx*dTheta*cos(Theta) - Iyy*dTheta*cos(Phi)^2*cos(Theta) + Izz*dTheta*cos(Phi)^2*cos(Theta) + Iyy*dTheta*cos(Theta)*sin(Phi)^2 - Izz*dTheta*cos(Theta)*sin(Phi)^2 + 2*Iyy*dPsi*cos(Phi)*cos(Theta)^2*sin(Phi) - 2*Izz*dPsi*cos(Phi)*cos(Theta)^2*sin(Phi)) + Iyy*dTheta^2*cos(Phi)*sin(Phi)*sin(Theta) - Izz*dTheta^2*cos(Phi)*sin(Phi)*sin(Theta) + 2*Ixx*dPsi*dTheta*cos(Theta)*sin(Theta) - 2*Izz*dPsi*dTheta*cos(Phi)^2*cos(Theta)*sin(Theta) - 2*Iyy*dPsi*dTheta*cos(Theta)*sin(Phi)^2*sin(Theta);

CdEta=[CdE1; CdE2; CdE3];
\end{lstlisting}
\onehalfspacing
Si se quiere econtrar los puntos de equilibrio del sistema planteado en \ref{eq:system} se parte del mismo sistema de ecuaciones y se impone que tanto las velocidades y aceleraciones sean cero. 
Para facilitar al sistema a resolver el problema también se supone que se está en condiciones próximas al punto de equilibrio, y por tanto, si  $\alpha \approx 0 \rightarrow sin(\alpha)=0$ y si $\alpha \approx 1 \rightarrow cos(\alpha)=1$.
\singlespacing
\begin{lstlisting}[language=Matlab,firstnumber=68]
dPhi=0
dTheta=0
dPsi=0

R=eye(3)

sys1=(R*TB-[0; 0; m*g])/m
sys2=inv(J)*(TauB-CdEta)

eq1=sym(sys1(1))
eq2=sym(sys1(2))
eq3=sym(sys1(3))

eq4=sym(sys2(1))
eq5=sym(sys2(2))
eq6=sym(sys2(3))

syms dPhi dTheta dPsi 	% Requerido para substituir con subs()

seq1=sym(subs(eq1,{dPhi,dTheta,dPsi,sin(Phi),sin(Theta),sin(Psi),cos(Phi),cos(Theta),cos(Psi)},{0,0,0,0,0,0,1,1,1}))
seq2=sym(subs(eq2,{dPhi,dTheta,dPsi,sin(Phi),sin(Theta),sin(Psi),cos(Phi),cos(Theta),cos(Psi)},{0,0,0,0,0,0,1,1,1}))
seq3=sym(subs(eq3,{dPhi,dTheta,dPsi,sin(Phi),sin(Theta),sin(Psi),cos(Phi),cos(Theta),cos(Psi)},{0,0,0,0,0,0,1,1,1}))

seq4=sym(subs(eq4,{dPhi,dTheta,dPsi,sin(Phi),sin(Theta),sin(Psi),cos(Phi),cos(Theta),cos(Psi)},{0,0,0,0,0,0,1,1,1}))
seq5=sym(subs(eq5,{dPhi,dTheta,dPsi,sin(Phi),sin(Theta),sin(Psi),cos(Phi),cos(Theta),cos(Psi)},{0,0,0,0,0,0,1,1,1}))
seq6=sym(subs(eq6,{dPhi,dTheta,dPsi,sin(Phi),sin(Theta),sin(Psi),cos(Phi),cos(Theta),cos(Psi)},{0,0,0,0,0,0,1,1,1}))

sol=solve(seq3,seq4,seq5,seq6,'f1','f2','f3','f4')
sol.f1
sol.f2
sol.f3
sol.f4
\end{lstlisting}
\onehalfspacing

Para linealizar el sistema se deben calcular las matrices $\mathbf{A}$ y $\mathbf{B}$ como en  \ref{jacobians}. Para ello se definen los vectores de derivadas, estados y fuerzas, se calculan los jacobianos y se substituye por el punto de equilibrio

\singlespacing
\begin{lstlisting}[language=Matlab,firstnumber=100]
fx=[dx;
    eq1;
    dy;
    eq2;
    dz;
    eq3;
    dPhi;
    eq4;
    dTheta;
    eq5;
    dPsi;
    eq6]

states=[x;
        dx;
        y;
        dy;
        z;
        dz;
        Phi;
        dPhi;
        Theta;
        dTheta;
        Psi;
        dPsi];

forces=[f1;
        f2;
        f3;
        f4];  
        
A=jacobian(fx,states)
Asub=sym(subs(A,{Phi,Theta,Psi,dPhi,dTheta,dPsi,f1,f2,f3,f4},{0,0,0,0,0,0,m*g/4,m*g/4,m*g/4,m*g/4}))

B=jacobian(fx,forces)
Bsub=sym(subs(B,{Phi,Theta,Psi,dPhi,dTheta,dPsi,f1,f2,f3,f4},{0,0,0,0,0,0,m*g/4,m*g/4,m*g/4,m*g/4}))        
\end{lstlisting}
\onehalfspacing

Como se busca un sistema como el que se ha obtenido en \ref{eq:final_system}, se repite todo el proceso incluyendo únicamente las variables respectivas a los ángulos $\phi$ y $\theta$ y sus derivadas:

\singlespacing
\begin{lstlisting}[language=Matlab,firstnumber=136]
fx=[dPhi;
    eq4;
    dTheta;
    eq5];

states=[Phi;
        dPhi;
        Theta;
        dTheta];
        
disA=jacobian(fx,states);
Ared=sym(subs(disA,{Phi,Theta,dPhi,dTheta,f1,f2,f3,f4},{0,0,0,0,m*g/4,m*g/4,m*g/4,m*g/4}))

disB=jacobian(fx,forces);
Bred=sym(subs(disB,{Phi,Theta,dPhi,dTheta,f1,f2,f3,f4},{0,0,0,0,m*g/4,m*g/4,m*g/4,m*g/4}))        
\end{lstlisting}
\onehalfspacing

Para calcular las $\mathbf{K}'s$ del control se procede calculando los parámetros $\mathbf{Q}$ y $\mathbf{R}$ necesarios para especificar el control por $LQR$:

\singlespacing
\begin{lstlisting}[language=Matlab,firstnumber=151]
Cred=[[1 0 0 0];[0 0 1 0]];
Dred=[[0 0 0 0];[0 0 0 0]];

Q=1*transpose(Cred)*Cred
R=100*eye(4)

[K,S,e]=lqrd(double(Ared),double(Bred),Q,R,0.02)
\end{lstlisting}
\newpage

\section*{Anexo B:Preparación de la Raspberry Pi}
Para poner a punto la RPi se instala un Raspbian y se configura para que es pueda comunicar con la placa MPU-6050.
\subsubsection*{Instalación Raspbian}
Habiendo introducido la tarjeta SD en un lector adecuado, se detecta en una terminal mediante la orden \textit{df -h}. Suponiendo que haya estado gravada anteriormente:
\begin{center}

\end{center}
Se deben desmontar las dos particiones, tanto la \textit{/dev/sdb1} como la \textit{/dev/sdb2}:
\begin{verbatim}
           umount /dev/sdb1
           umount /dev/sdb2
\end{verbatim}
Descargada la imagen a instalar, por ejemplo en el Escritorio, se procede con:
\begin{verbatim}
    sudo dd bs=4M if=~/Escritorio/2013-07-26-wheezy-raspbian.img of=/dev/sdb
\end{verbatim}
Pasados unos minutos ya se tiene la SD grabada con el sistema operativo Raspbian.
\subsubsection*{Configuración de la Raspberry}
Para poder comunicar la RPi con la IMU MPU-6050 por I2C es necesario configurar el sistema. Primero es necesario instalar los drivers mas relevantes. Del archivo
\begin{verbatim}
           sudo nano /etc/modules
\end{verbatim}
se añaden las siguientes dos líneas al final del archivo:
\begin{verbatim}
           i2c-bcm2708
           i2c-dev
\end{verbatim}
En el archivo blacklist:
\begin{verbatim}
           sudo vi /etc/modprobe.d/raspi-blacklist.conf
\end{verbatim}
las siguientes dos líneas deben empezar con un signo \# (de comentario):
\begin{verbatim}
           #blacklist spi-bcm2708
           #blacklist i2c-bcm2708
\end{verbatim}
Para conectar el sensor, se sigue el conexionado:

%\begin{figure}[h!]
%\begin{center}
%\includegraphics[scale=0.2,viewport=0 200 800 720,clip]{images/ConSens.png}
%\caption{Conexión por I2C entre MPU-6050 y RPi}
%\end{center}
%\end{figure}
%Es decir
\begin{itemize}
\item Pin 1-3.3V se conecta a VCC.
\item Pin 3-SDA se conecta a SDA
\item Pin 5-SCL se conecta a SCL
\item Pin 6-Ground se conecta a GND
\end{itemize} 
Es necesario instalar el paquete $i2c-tools$:
\begin{verbatim}
           sudo apt-get install i2c-tools
\end{verbatim}
Para ver el sensor se escribe:
\begin{verbatim}
           sudo i2cdetect -y 1
\end{verbatim}
El resultado es el dispositivo que corresponde al MPU-6050:

\begin{figure}[h!]
\begin{center}
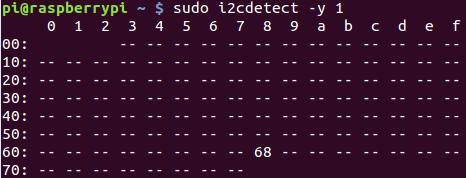
[picture p36: Latex project/images/i2cdetect.png]

\caption{Detección del sensor MPU-6050}
\end{center}
\end{figure}

\subsubsection*{Librería wiringPi}
Se utiliza esta librería \cite{wiringPi} como a interfaz del GPIO (General Porpouse Input Output). Permite, por tanto, leer las consignas y sensores y generar las acciones de control. 
La instalación y descripción de la librería esta explicado en la página web incluida en la bibliografía. Ésta también incluye la librería $wiringPiI2C.h$, usada para la comunicación por I2C con los sensores.

\subsubsection*{Librería pi-blaster}
Es necesaria esta librería \cite{pi-blaster} para enviar las señales de control a sus respectivos motores, ya que permite usar cada pin del GPIO como un PWM. Se instala y usa según se especifica en el repositorio.

\newpage
\section*{Anexo C: Filtro de Kalman}

Las lecturas del sensor están sometidas a ruido y por lo tanto no son tan precisas como convendría. Para evitar eso se usa un filtro de Kalman,  que es un algoritmo recursivo para corregir los valores obtenidos a partir de la estimación de variables no conocidas, obteniendo valores más precisos que los que se leen. 

\section*{Algoritmo del Filtro de Kalman}

Sobre un sistema dinámico $LTI$ representado en espacio de estados tal como

\begin{equation}
\begin{array}{l}
\mathbf{x}_{k}=\mathbf{A}_{k-1} \cdot \mathbf{x}_{k-1} + \mathbf{B}_{k-1} \cdot \mathbf{u}_{k-1} + \mathbf{w}_{k-1} \\
\mathbf{z}_{k}=\mathbf{H}_{k} \cdot \mathbf{x}_{k} + \mathbf{v}_{k}
\end{array}
\end{equation}		

donde $\mathbf{w}_{k-1}$ y $\mathbf{v}_{k}$ son el ruido blanco de promedio cero y varianza $\mathbf{Q}_{k-1}$ y $\mathbf{R}_{k}$ en los instantes $k-1$ y $k$ respectivamente, este algoritmo identifica los estados $\mathbf{x}_{k}$ en dos fases: la \textbf{predicción o estimación} y la \textbf{corrección}.  \\

\textbf{Predicción}\\

En la primera fase se estiman los estados del sistema. Una estimación se puede hacer respecto a un estado anterior y las estimaciones previas, en tal caso se tendrá un $estado \>\> previo$:

\begin{equation}
\hat{\mathbf{x}}_{k-1|k-1}
\end{equation}

También se puede tener un $estado \>\> a \>\> priori$, es decir, estimar el estado actual del sistema basándose en el estado actual y las estimaciones previas:

\begin{equation}
\hat{\mathbf{x}}_{k|k-1}
\end{equation}

o bien se puede obtener el $estado \>\> a \>\> posteriori$, que es la predicción del estado según el estado y las estimaciones actuales:

\begin{equation}
\hat{\mathbf{x}}_{k|k}
\end{equation}

Se procede a hacer una estimación $a \>\> priori$ del estado mediante

\begin{equation}
\hat{\mathbf{x}}_{k|k-1} =\mathbf{\Phi}_{k} \cdot \mathbf{x}_{k-1|k-1}
\end{equation}

donde $\mathbf{\Phi}_{k}$ es la matriz de transición de estados. Ésta puede depender también de otras variables, tales como $\mathbf{u}_{k}$ como se verá posteriormente y se calcula la covarianza del error asociada a la estimación $a \>\> priori$ en función de la varianza $\mathbf{Q}_{k}$ del estado como

\begin{equation}
\mathbf{P}_{k|k-1}=\mathbf{\Phi}_{k} \cdot \mathbf{P}_{k-1|k-1} \cdot \mathbf{\Phi}_{k}^{T} + \mathbf{Q}_{k}
\end{equation}

En suponer que un estado está sometido a ruido blanco se puede expresar su distribución de probabilidad con una distribución normal con media igual a la estimación realizada $\mu=\hat{\pmb{x}}_{k|k-1}$ y varianza $\sigma^{2}=P_{k|k-1}$:

\begin{figure}[h!]
\begin{center}
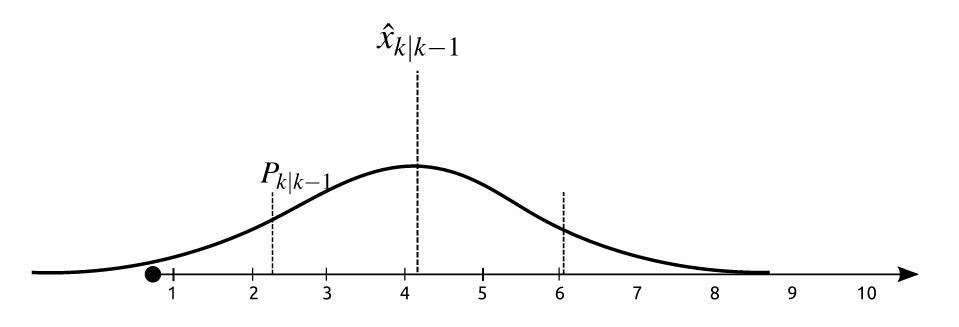
[picture p37: Latex project/images/fun_dens_x.png]

\caption{Función de densidad de la variable de estado $\hat{x}_{k|k-1}$}
\end{center}
\end{figure}
\newpage
cuya función de densidad es:

\begin{equation}
f_{\mu,\sigma^{2}}(r)=\frac{1}{\sqrt{2\pi \sigma^{2}}}e^{-\frac{(r-\mu)^{2}}{2\sigma}}
\end{equation}		

\textbf{Corrección}\\

En actualizar la medida, es decir, obtener una nueva observación del estado $\mathbf{x}_{k}$ tras una acción cualquiera al sistema  $\mathbf{u}_{k-1}$, ésta tendrá también ruido ($\mathbf{v}_{k}$):

\begin{equation}
\mathbf{z}_{k}=\mathbf{H} \cdot \mathbf{x}_{k} + \mathbf{v}_{k}
\end{equation}

y se expresa mediante una nueva distribución normal de media $z_{k}$, que en el espacio de estados se representa como $H^{-1}z_{k}$:

\begin{figure}[h!]
\begin{center}
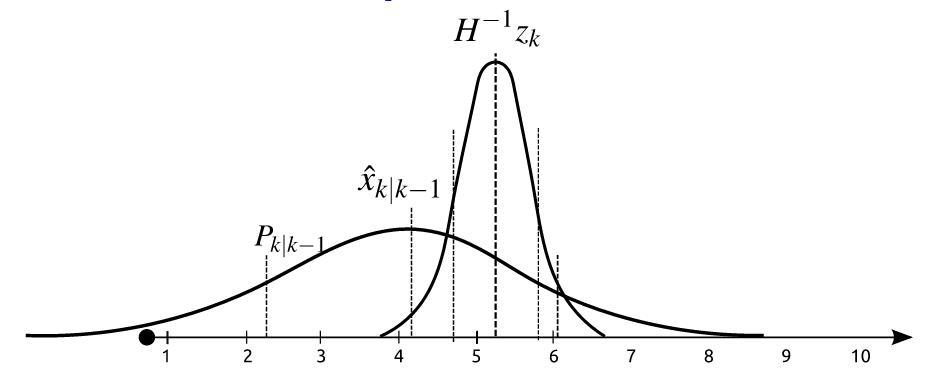
[picture p38: Latex project/images/comp_fun_dens_x.png]

\caption{Comparación con función de densidad de la medición $z_{k}$}
\end{center}
\end{figure}

Como las distribuciones de la estimación $\hat{x}_{k|k-1}$ y la observación $z_{k}$ no son iguales se combinan multiplicándolas para tener una mejor aproximación del estado $a \>\> posteriori$ en el tiempo $k$. La multiplicación de dos funciones de densidad $f_{1}$ y $f_{2}$ tiene como resultado otra función de densidad 

\begin{equation}
\begin{array}{c}
f_{1}(r) \cdot f_{2}(r) = f_{p}(r)= \frac{1}{\sqrt{2\pi \sigma^{2}_{1}}}e^{-\frac{(r-\mu_{1})^{2}}{2\sigma_{1}}} \cdot \frac{1}{\sqrt{2\pi \sigma^{2}_{2}}}e^{-\frac{(r-\mu_{2})^{2}}{2\sigma_{2}}} = \\   \\
=\frac{1}{2\pi \sqrt{\sigma^{2}_{1}\sigma^{2}_{2}}}e^{-\left(\frac{(r-\mu_{1})^{2}}{2\sigma_{1}}+\frac{(r-\mu_{1})^{2}}{2\sigma_{1}}\right)} \end{array}
\end{equation}

de media $\mu_{p}$ y varianza $\sigma^{2}_{p}$:

\begin{equation}
\mu_{p}=\mu_{1}+\frac{\sigma^{2}_{1}(\mu_{2}-\mu_{1})}{\sigma^{2}_{1}+\sigma^{2}_{2}} \hspace{2cm} \sigma^{2}_{p} = \sigma^{2}_{1} - \frac{\sigma^{4}_{1}}{\sigma^{2}_{1} + \sigma^{2}_{2}} 
\end{equation}	

Substituyendo en este caso con las dos funciones anteriores se tiene que la estimación del estado $a \>\> posteriori$ es 

\begin{equation}
\hat{\pmb{x}}_{k|k}=\hat{x}_{k|k-1} + \frac{\mathbf{P}_{k|k-1}\mathbf{H}^{T}_{k}(z_{k}-\mathbf{H}_{k}\hat{x}_{k|k-1})}{\mathbf{H}_{k} \mathbf{P}_{k|k-1} \mathbf{H}_{k}^{T} + \mathbf{R}_{k}}
\label{media_x}
\end{equation}

que se puede expresar como

\begin{equation}
\hat{\mathbf{x}}_{k|k}=\hat{\mathbf{x}}_{k|k-1}+\mathbf{K}_{k}\cdot \tilde{\mathbf{y}}_{k}
\end{equation}

donde $\mathbf{K}_{k}$ es la ganancia de Kalman y se representa como

\begin{equation}
\mathbf{K}_{k}=\mathbf{P}_{k|k-1} \mathbf{H}_{k}^{T} \cdot (\mathbf{H}_{k} \mathbf{P}_{k|k-1} \mathbf{H}_{k}^{T} + \mathbf{R}_{k})^{-1}
\end{equation}

e $\tilde{\mathbf{y}}_{k}$ es la innovación:

\begin{equation}
\tilde{\mathbf{y}}_{k} = \mathbf{z}_{k} - \mathbf{H}_{k} \cdot \hat{\mathbf{x}}_{k|k-1}
\end{equation}

Finalmente se actualiza la covarianza del error asociada a esta última estimación, substituyendo los valores de las varianzas tal y como se ha hecho para la media en \ref{media_x}:

Finalmente se actualiza la covarianza del error asociada a esta última estimación

\begin{equation}
\mathbf{P}_{k|k} = (\mathbf{I} - \mathbf{K}_{k}\mathbf{H}_{k})\mathbf{P}_{k|k-1}
\end{equation}

\section*{Implementación}

Se explicará paso por paso cómo se ha implementado el filtro de Kalman que se ha utilizado en el Quadcopter en código $C$.  \\

Se determina el tiempo de muestreo mediante la diferencia de tiempo entre dos lecturas consecutivas del sensor y con ello se obtiene $dt$. Se considera en la estimación del estado sigue una dinámica tal que 

\begin{equation}
\begin{array}{c}
\hat{\mathbf{x}}_{k|k-1}=\mathbf{F}_{k-1} \cdot \hat{\mathbf{x}}_{k-1|k-1} + \mathbf{B}_{k-1}\cdot \mathbf{u}_{k-1}= \\
\\ \left[ \begin{array}{c}
\theta \\
\dot{\theta}_{b} \\ \end{array} \right]_{k|k-1} = \left[ \begin{array}{cc}
1 & -\Delta t \\
0 & 1  \\ \end{array} \right]  \left[ \begin{array}{c}
\theta \\
\dot{\theta}_{b} \\ \end{array} \right]_{k-1|k-1} + \left[ \begin{array}{c}
\Delta t \\
0 \\ \end{array} \right]  \dot{\theta}_{k}
\end{array}
\end{equation}

A este Filtro se le conoce por Filtro de Schmidt ya que su segundo estado es el $bias$ de la velocidad. Desarrollandolo se tiene que:

\begin{equation}
\left[ \begin{array}{c}
\theta \\
\dot{\theta}_{b} \\ \end{array} \right]_{k|k-1} = \left[ \begin{array}{c}
\theta + \Delta t(\dot{\theta}-\dot{\theta}_{b}) \\
\dot{\theta}_{b} \\ \end{array} \right]
\label{9.20}
\end{equation}

Si se considera que $rate=(\dot{\theta}-\dot{\theta}_{b})$ se expresa \ref{9.20} como 

\begin{lstlisting}[language=C]   
rate=velocity-bias;
angle+=dt*rate;
\end{lstlisting}

Para estimar la varianza $\mathbf{P}_{k|k-1}$ se tiene 

\begin{equation}
\begin{array}{c}

\hspace{-1cm} \left[ \begin{array}{cc}
P_{00} & P_{01} \\
P_{10} & P_{11} \\ \end{array} \right]_{k|k-1} = \left[ \begin{array}{cc}
1 & -\Delta t \\
0 & 1 \\ \end{array} \right] \left[ \begin{array}{cc}
P_{00} & P_{01} \\
P_{10} & P_{11} \\ \end{array} \right]_{k-1|k-1} \left[ \begin{array}{cc}
1 & -\Delta t \\
0 & 1 \\ \end{array} \right]^{T} + \left[ \begin{array}{cc}
Q_{\theta} & 0 \\
0 & Q_{\dot{\theta}_{b}} \\ \end{array} \right] \Delta t = \\
\\
= \left[ \begin{array}{cc}
P_{00} + \Delta t (\Delta t P_{11} - P_{01} - P_{10} + Q_{\theta}) & P_{01} - \Delta t P_{11} \\
P_{10} - \Delta t P_{11} & P_{11}+ Q_{\dot{\theta}_{b}}\Delta t \\ \end{array} \right]
\end{array}
\end{equation}

que en código C se implementa como

\begin{lstlisting}[language=C,firstnumber=3]
P[0][0] += dt * (dt*P[1][1] - P[0][1] - P[1][0] + Q_angle);
P[0][1] -= dt * P[1][1];
P[1][0] -= dt * P[1][1];
P[1][1] += Q_gyroBias * dt;
\end{lstlisting}

La innovación $\tilde{y}_{k}$ es 

\begin{equation}
\tilde{y}_{k}=z_{k} - \mathbf{H}_{k}\cdot \hat{\mathbf{x}}_{k|k-1}=z_{k} - \theta_{k|k-1}
\end{equation}

Que en el programa que se ejecuta se calcula como la diferencia de la lectura y el estado:

\begin{lstlisting}[language=C,firstnumber=7]
y=newangle-angle;
\end{lstlisting}

Para calcular la ganancia de Kalman se debe calcular antes $\mathbf{S}_{k}$: 

\begin{equation}
\begin{array}{c}
\mathbf{S}_{k}=\mathbf{H}_{k} \mathbf{P}_{k|k-1} \mathbf{H}_{k}^{T} + \mathbf{R}_{k} = \left[ \begin{array}{cc}
1 & 0 \\ \end{array} \right] \left[ \begin{array}{cc}
P_{00} & P_{01} \\
P_{10} & P_{11} \\ \end{array} \right] \left[ \begin{array}{c}
1 \\
0 \\ \end{array} \right] + \mathbf{R}= \\
\\
={P_{00}}_{k|k-1} + R_{k}
\end{array}
\end{equation}

y para la ganancia es

\begin{equation}
\mathbf{K}_{k}=\mathbf{P}_{k|k-1}\mathbf{H}^{T}\mathbf{S}_{k}^{-1}= \left[ \begin{array}{c}
K_{0} \\
K_{1} \\ \end{array} \right] _{k} = \frac{\left[ \begin{array}{c}
P_{00} \\
P_{10} \\ \end{array} \right]_{k|k-1}}{\mathbf{S}_{k}}
\end{equation}

La implementación de la ganancia de Kalman queda como:

\begin{lstlisting}[language=C,firstnumber=8]
S = P[0][0] + R_angle;

K[0] = P[0][0] / S;
K[1] = P[1][0] / S;
\end{lstlisting}

Por último queda asignar los nuevos valores de las estimaciones. Para el caso del estado $\hat{\mathbf{x}}_{k|k}$ se tiene que 
 
\begin{equation}
\hat{\mathbf{x}}_{k|k}=\left[\begin{array}{c}
\theta \\
\dot{\theta}_{b} \\ \end{array} \right] _{k|k-1} + \left[\begin{array}{c}
K_{0}\tilde{y} \\
K_{1}\tilde{y} \\ \end{array} \right]_{k}
\end{equation}

y para la matriz de covarianzas del error 

\begin{equation}
\mathbf{P}_{k|k}=(\mathbf{I} - \mathbf{K}_{k}\mathbf{H})\hat{\mathbf{x}}_{k|k-1}=\left[ \begin{array}{cc}
P_{00} & P_{01} \\
P_{10} & P_{11} \\ \end{array} \right]_{k|k-1} - \left[ \begin{array}{cc}
K_{0}P_{00} & K_{0}P_{01} \\
K_{1}P_{00} & K_{1}P_{01} \\ \end{array} \right] 
\end{equation}

El código que implementa este último paso del filtro es 

\begin{lstlisting}[language=C,firstnumber=12]
angle += K[0] * y;
bias += K[1] * y;

P[0][0] -= K[0] * P[0][0];
P[0][1] -= K[0] * P[0][1];
P[1][0] -= K[1] * P[0][0];
P[1][1] -= K[1] * P[0][1];
\end{lstlisting}
\newpage
\section*{Anexo D: Identificación de los parámetros del Quadcopter}
%% Inercias, longitud brazos, motores (fuerza e intensidad)
Para poder trabajar en particular con el Quadcopter construido es necesario saber qué lo caracteriza o distingue de los demás. Parámetros relevantes y necesarios que se utilizan en el modelo implementado en Simulink deben ser, entonces, medidos para que se simule el mismo aparato con iguales características. \\

Se consideran relevantes la matriz de inercias, la longitud de los brazos  $l$ y la la fuerza e intensidad (consumo) de los motores respecto a la señal $PWM$ con que se controlan.\\

Con este conjunto de parámetros se considera que el Quadcopter está totalmente definido y puede obtenerse la ley de control.

\subsubsection*{Masa total}

El peso que deberán contrarrestar los motores para permitir al Quadcopter planear se obtiene mediante una báscula pesando el conjunto. Resulta una masa $m$ total de $0.96 \>\> kg$.  

\subsubsection*{Inercias}

Como se ha comentado en la sección \ref{def}, se supone que el Quadcopter es un rotor esférico, y por tanto de su tensor de inercia todos los productos de inercia serán nulos. Se tendrá entonces una matriz diagonal como tensor. En este apartado, entonces, el objetivo será la medición de los momentos de inercia $I_{xx}$, $I_{yy}$ y $I_{zz}$ correspondientes a los ángulos $Roll$, $Pitch$ y $Yaw$ respectivamente. Para el cálculo de los dos primeros se usa una bancada compuesta por un muelle de constante de torsión $D$ conocida del que cuelga el quadcopter. De querer determinar el momento de inercia $I_{xx}$, se cuelga desde uno de los extremos del eje $x$, tal y como se observa en la figura \ref{Quad_spring}

\begin{figure}[h!]
\begin{center}
\begin{tikzpicture}
\draw[decoration={aspect=0.3, segment length=2mm, amplitude=3mm,coil},decorate] (0,5) -- (0,2); 

\path[draw, line width=5pt,color =black] (0,0) -- (0,2);
\path[draw, line width=5pt,color =black] (-0.8,1.4) -- (0.8,0.6);

\path[draw, line width=5pt,color =black] (0.05,0.05) -- (-0.3,-0.18);
\path[draw, line width=5pt,color =black] (0.05,2.05) -- (-0.3,1.82);
\path[draw, line width=5pt,color =black] (-0.75,1.4) -- (-1.1,1.2);
\path[draw, line width=5pt,color =black] (0.85,0.62) -- (0.5,0.42);

\path [draw, line width=1pt] (-1,3) -- (-1,2);
\path [draw, line width=1pt] (-1.2,2.2) -- (-1,2) -- (-0.8,2.2);

\path[draw] (-1.3,2.5) node (nodeC) {\large $\dot{\Omega}$};
\path[draw] (0.7,3.5) node (nodeC) {\large D};

\path[draw,line width=1pt,dotted, color=black](-1.6,1.8) -- (1.6,0.2);
\path[draw,line width=1pt,dotted, color=black](-1,0.34) -- (1,1.66);
\path[draw,line width=1pt,dotted, color=black](0,3) -- (0,-1);

\path[draw,line width=1pt] (0,-0.5) -- (0,-1);
\path[draw,line width=1pt] (-0.1,-0.8) -- (0,-1) -- (0.1,-0.8);
\path[draw] (0.4,-0.7) node (nodeC) {\large x};
\path[draw] (-0.3,0.8) node (nodeC) {\large o};

\fill [pattern = north east lines] (-1,5) rectangle (1,5.2);
\draw[thick] (-1,5) -- (1,5);
\end{tikzpicture}
\end{center}
\caption{Bancada para la determinación de las inercias}
\label{Quad_spring}
\end{figure}

Para un sólido rígido se tiene que 

\begin{equation}
\mathbf{M}=\frac{d\mathbf{L_{o}}}{dt}
\end{equation}

donde $\mathbf{M}$ es el momento resultante y $\mathbf{L_{o}}$ es el momento cinético o angular aplicado en el punto $o$, que en este caso corresponde al centro de gravedad del cuerpo. Éste se expresa como

\begin{equation}
\mathbf{L_{o}}=\mathbf{I}\dot{\mathbf{\Omega}}
\end{equation}

El momento resultante puede expresarse entonces de la forma 

\begin{equation}
\mathbf{M}=\frac{d(\mathbf{I}\dot{\mathbf{\Omega}})}{dt}=\mathbf{I}\ddot{\mathbf{\Omega}}=\left[ \begin{array}{ccc}
I_{xx} & 0 & 0 \\
0 & I_{yy} & 0 \\
0 & 0 & I_{zz} \\
\end{array} \right]\left[ \begin{array}{c}
\ddot{\Omega}_{x} \\
\ddot{\Omega}_{y} \\
\ddot{\Omega}_{z} \\
\end{array} \right]=\left[ \begin{array}{ccc}
I_{xx} & 0 & 0 \\
0 & I_{yy} & 0 \\
0 & 0 & I_{zz} \\
\end{array} \right]\left[ \begin{array}{c}
\ddot{\Omega} \\
0 \\
0 \\
\end{array} \right] = I_{xx} \ddot{\Omega}
\label{53}
\end{equation}

en suponer que el tensor de inercia no varía con el tiempo. Se asume 
que el eje de rotación $\dot{\Omega}$ pasa por el centro de masas, de lo contrario debería aplicarse el teorema de Steiner. Para el muelle se tiene que, según la ley de Hooke

\begin{equation}
M=-D \cdot \Omega
\label{54}
\end{equation}

donde $\mathbf{\Omega}$ es el ángulo girado en la dirección longitudinal del muelle. Igualando las expresiones \ref{53} y \ref{54} se llega a 

\begin{equation}
-D \cdot \Omega = I_{xx}\ddot{\Omega}\quad \Longrightarrow \quad \ddot{\Omega}+\frac{D}{I_{xx}}\Omega =0 
\end{equation}

La solución de la ecuación anterior es la de un oscilador armónico de periodo 

\begin{equation}
T=2\pi \sqrt{\frac{I_{xx}}{D}}
\end{equation}

Ésto se cumple en oscilaciones pequeñas cercanas al punto de equilibrio, es decir,donde $\Omega=\dot{\Omega}=\ddot{\Omega}=0$. Por lo tanto, el periodo de una oscilación es suficiente para poder calcular el momento de inercia en estar directamente relacionados. Para obtener resultados más precisos se medirá el tiempo varias veces. \\

Para calcular la constante de torsión del muelle se le ha sometido a ensayo, sometiéndolo a diferentes deformaciones elásticas y observando el momento resultante:
\begin{center}
\begin{tabular}{|c|c|c|}
\hline
$\mathbf{\Omega}$(º) & $\mathbf{M}$($g \cdot 10cm$) & $\mathbf{M}$($N \cdot m$) \\
\hline 
\hline 
30 & 33 & 0.0323 \\
45 & 46 & 0.0451 \\
60 & 62 & 0.0608 \\
90 & 93 & 0.0912 \\
\hline 
\end{tabular}
\end{center}

En calcular la relación entre ambas magnitudes para obtener la constante de torsión del muelle, por regresión lineal se obtiene que la pendiente es de $1.0095\>\>g\cdot10cm/grad$. La constante entonces puede expresarse en unidades del Sistema Internacional como 

\begin{equation}
D=1.0095 \>\> \frac{g\cdot10cm}{grad}\cdot\frac{9.81 \>\> N}{1000 \>\> g} \cdot \frac{1 \>\> m}{100 \>\> cm} \cdot \frac{360 \>\> grad}{2\pi \>\> rad} = 0.0567 \>\> \frac{Nm}{rad}
\end{equation}

En hacer oscilar el Quadcopter en el eje $x$ se obtiene:

\begin{center}
\begin{tabular}{|c|cccc|c|c|}
\hline
\textbf{Eje} & \multicolumn{4}{c|}{\textbf{Muestras}(s)} & \textbf{Media}(s) & \textbf{Momento de inercia}($kg \cdot m^{2}$) \\
\hline
\multirow{4}{*}{$x$} & 2.3 & 2.3 & 2.5 & 2.2 & \multirow{4}{*}{2.35} & \multirow{4}{*}{$7.932\cdot 10^{-3}$} \\
& 2.3 & 2.4 & 2.5 & 2.4 & & \\
& 2.4 & 2.3 & 2.3 & 2.4 & & \\
& 2.3 & 2.4 & 2.3 & 2.3 & & \\
\hline
\multirow{4}{*}{$y$} & 2.4 & 2.3 & 2.2 & 2.4 & \multirow{4}{*}{2.31} & \multirow{4}{*}{$7.664\cdot 10^{-3}$} \\
& 2.2 & 2.4 & 2.3 & 2.2 & & \\
& 2.4 & 2.3 & 2.3 & 2.4 & & \\
& 2.3 & 2.3 & 2.3 & 2.3 & & \\
\hline
\end{tabular}
\end{center}

y por tanto se obtiene que $I_{xx}=7.931\cdot 10^{-3} \>\> kg \cdot m^{2}$ y $I_{yy}=7.664\cdot 10^{-3}\>\> kg \cdot m^{2}$.

Para el cálculo del $I_{zz}$ se usa una bancada parecida a la anterior, pero eliminando el muelle, de tal manera que pueda oscilar desde uno de los agujeros de uno de los brazos. El periodo que resulta en hacer oscilar el Quadcopter es 

\begin{equation}
T=2\pi \sqrt{\frac{I}{mgd}}
\end{equation}

donde d es la distancia entre el centro de masas y el punto del que se oscila. Mediante el teorema de Steiner se descompone la inercia que se obtiene no es respecto al eje que pasa por el su centro, sino mayor. Ésta es 

\begin{equation}
I=I_{zz}+md^{2}
\end{equation}

Y por lo tanto se obtiene que

\begin{equation}
T=2\pi \sqrt{\frac{I_{zz}+md^{2}}{mgd}}
\end{equation}

En el experimento se tiene que $g=9.81\>\>m/s^{2}$, $d=0.13\>\>m$ y $m=0.96\>\>kg$. Se realizan 8 mediciones de 5 oscilaciones cada una, por lo que la media que se obtiene se divide entre 5

\begin{center}
\begin{tabular}{|c|cccc|c|c|}
\hline
\textbf{Eje} & \multicolumn{4}{c|}{\textbf{Muestras}(s) (5 oscil.)} & \textbf{Media}(s) & \textbf{Momento de inercia}($kg \cdot m^{2}$) \\
\hline
\multirow{2}{*}{$z$} & 4.6 & 4.5 & 4.5 & 4.6 & \multirow{2}{*}{4.575} & \multirow{2}{*}{$9.741 \cdot 10^{-3}$} \\
& 4.6 & 4.6 & 4.6 & 4.6 & & \\
\hline
\end{tabular}
\end{center}
y por tanto se tiene que el tensor de inercia del Quadcopter es

\begin{equation}
\mathbf{I}=\left[ \begin{array}{ccc}
7.932 & 0 & 0 \\
0 & 7.664 & 0 \\
0 & 0 & 9.741 \\
\end{array} \right] \cdot 10^{-3}
\end{equation}

\subsubsection*{Longitud de brazo}

Queda especificado en el modelo del Frame elegido que es de $33 \>\> cm$ la distancia de motor a motor en la diagonal principal. La longitud que se considera  es de $l=16.5 \>\> cm$.

\subsubsection*{Motores}
Para poder controlar la planta es necesario saber cómo responden los actuadores para realizar un control preciso. De éstos se debe conocer qué fuerza y momento proporcionan, así como el consumo de energía para un PWM dado. La respuesta varía según las aspas que se utilicen, por lo que las curvas que se obtengan serán únicas para este caso. De cambiarlas tanto la fuerza, consumo y momentos generados se verían modificados.  

Para obtener una curva de la fuerza respecto del PWM se pesa con una balanza la acción del motor. La rudimentaria bancada que se tiene para tal objetivo es un codo articulado en el punto en donde se crea el ángulo, de tal manera que la distancia del eje del motor al fulcro y de éste a la balanza sea la misma (en este caso de 12 cm). El consumo que se tiene se obtiene mediante un amperímetro conectado en serie al ESC.

%Las partes están hechas de madera (parte marrón) y plástico ABS (parte verde). Toda la estructura se sujeta a unas maderas:

%\begin{figure}[h!]
%\begin{center}
%\includegraphics[scale=0.4]{images/bancada1_b.jpeg}
%\caption{Bancada para el estudio del motor}
%\end{center}
%\end{figure}

%\begin{figure}[h!]
%\begin{center}
%\includegraphics[scale=0.09]{images/montaje.jpg}
%\caption{Montaje para el estudio del motor}
%\end{center}
%\end{figure}

Se transmite al ESC cómo se debe hacer funcionar el motor desde la Raspberry Pi por medio de una señal PWM. El código que se ejecuta para hacer las pruebas es:
\singlespacing
\begin{lstlisting}[language=C]
#include <stdio.h>
#include <termios.h>
#include <wiringPi.h>
#include <unistd.h>

#define PIN 2 // pin 13

int main(void){

        int i,p;
        wiringPiSetup();

        pinMode(PIN,OUTPUT);
        digitalWrite(PIN,LOW);

        for(i=0;i<=100;i+=5){
                for(p=0;p<250;p++){
                        digitalWrite(PIN,HIGH);
                        delayMicroseconds(950+i*10);
                        digitalWrite(PIN,LOW);
                        delayMicroseconds(19050-i*10);

                        printf("PWM(i): %d \t h:%d \n",i,p);
                }
        }
        return 0;
}
\end{lstlisting}
\onehalfspacing 
Se obtiene una lectura de fuerza y  de intensidad por cada incremento del 0.25\% del PWM enviado al Variador. Las lecturas que se obtienen 
se representan en pondios($p$) siendo conocedores de la no pertenencia al Sistema Internacional de Unidades (sino al Sistema Técnico de Unidades) debido a que guarda una equivalencia directa con la masa medida en la bancada. Las lecturas obtenidas son: 

\begin{center}
\begin{tabular}{|c|c|c|}
\hline
\textbf{PWM(\%)} & \textbf{Intensidad(A)} & \textbf{Masa(g)} \\
\hline
\hline
5    &	  0 &   0 \\
\hline
5,25 & 0,25 &  13 \\
\hline
5,5	 &  0,5 &  38 \\
\hline
5,75 &  0,9 &  74 \\
\hline
6    & 1,38 &  98 \\
\hline
6,25	 &  1,8 & 128 \\
\hline
6,5  &	2,4 & 158 \\
\hline
6,75 & 	2,9 & 191 \\
\hline
7    &	3,5 & 215 \\
\hline
7,25 &  	  4	& 250 \\
\hline
7,5  & 	4,6 & 277 \\
\hline
7,75	 &  5,5 & 318 \\
\hline
8    &	6,5	& 360 \\
\hline
8,25 &    8 & 400 \\
\hline
8,5  & 9,15 & 450 \\
\hline
\end{tabular}
\end{center}
El PWM(\%) que se envía está comprendido entre el 5\% y el 10\% del ciclo de trabajo, que corresponden al mínimo y máximo del motor. Para un PWM elevado la fuerza se considera demasiado grande y al no preverse que se haga funcionar al sistema en semejantes condiciones, no se estudia. Se detecta una relación proporcional del PWM con la fuerza $f$ generada.

Graficado: 

%\begin{figure}[h!]
%\begin{center}
%\includegraphics[scale=0.8]{images/MvsPWM.jpeg}
%\caption{Relación entre la fuerza (en gramos) y el PWM}
%\end{center}
%\end{figure}
\begin{figure}[ht]
\begin{center}
\begin{tikzpicture}[domain=5:9]
\path[draw] (11,-0.8) node {PWM(\%)};
\path[draw] (-0.6,4.4) node {f(p)};
\begin{axis}[width=12cm,height=6cm,xmin=5,ymin=0,xmax=8.5,ymax=475]
\addplot [color=black,solid,thick,mark=*, mark options={fill=white}] coordinates {
			(5,0)
			(5.25,13)	
			(5.5,38)
			(5.75,74)
			(6,98)
			(6.25,128)
			(6.5,158)
			(6.75,191)
			(7,215)
			(7.25,250)
			(7.5	,277)
			(7.75,318)
			(8,360)
			(8.25,400)
			(8.5	,450)
        }; 
\addplot [color=red,dashed] {118.73*x-613};
\end{axis}
\end{tikzpicture}
\end{center}
\end{figure}

Se considera que una regresión lineal será suficiente en observarse una relación tan directamente proporcional. Para ello se decide utilizar los valores comprendidos entre los $PWM=5.5$ y $PWM=7.5$ porque no se espera hacer trabajar al sistema con los valores extremos.  Se obtiene que la fuerza $f(PWM)$ del motor será:

\begin{equation}
f(PWM)=119 \cdot PWM - 613
\end{equation}

con un coeficiente de determinación en la regresión de  $R^2=0.999$. Este resultado facilita el problema en ser una relación entre las dos magnitudes lo suficientemente sencilla.

Respecto a la intensidad, será caso de estudio únicamente el saber cuánto consume en el punto de equilibrio, pues no es necesaria la ecuación de la curva para poder volar. Se verá una aproximación de lo que puede llegar a consumir cada motor para asegurar una autonomía de vuelo no irrisoria. Se tiene 
% \newpage

%\begin{figure}[!h]
%\begin{center}
%\includegraphics[scale=0.8]{images/IvsPWM.jpeg}
%\caption{Relación entre la corriente consumida y el PWM}
%\end{center}
%\end{figure}

\begin{figure}[ht]
\begin{center}
\begin{tikzpicture}[domain=5:9]
\path[draw] (11,-0.8) node {PWM(\%)};
\path[draw] (-0.8,4.7) node {I(A)};
\begin{axis}[width=12cm,height=6cm,xmin=5,ymin=0,xmax=8.5]
\addplot [color=black,solid,thick,mark=*, mark options={fill=white}] coordinates {
			(5,0)
			(5.25,0.25)	
			(5.5,0.5)
			(5.75,0.9)
			(6,1.38)
			(6.25,1.8)
			(6.5,2.4)
			(6.75,2.9)
			(7,3.5)
			(7.25,4)
			(7.5	,4.6)
			(7.75,5.5)
			(8,6.5)
			(8.25,8)
			(8.5	,9.15)
        }; 
% \addplot [color=red,dashed] {0.0776*x^(2)};
\end{axis}
\end{tikzpicture}
\end{center}
\end{figure}

Como en el punto de equilibrio cada motor soporta una cuarta parte del peso, el PWM debería corresponder al de una fuerza de $m_{Quadcopter}\cdot g/4\approx0.250$kg. El consumo correspondiente es de $4$A aproximadamente. Entre los cuatro motores se consumirán $4 \cdot 4=16$A. En ser la batería de 2200mAh se supone una autonomía de 8.25 minutos aproximadamente:

\begin{equation}
\frac{2.2 \>\> A \cdot h}{16\>\>A} \cdot \frac{60\>\> minutos}{1 h}=8.28 \>\> minutos
\end{equation} 

\end{document}
