Gabrieldelacal/PFC/Latex project/images/10389068_10152525588004802_6640584116308163649_n.png

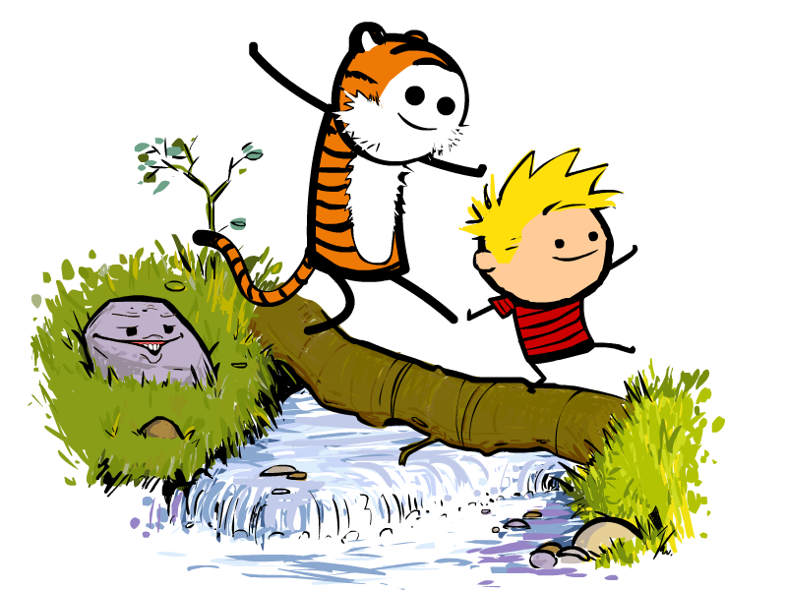
Latex project/images/10389068_10152525588004802_6640584116308163649_n.png
