Gabrieldelacal/PFC/Latex project/images/bancada1.jpeg

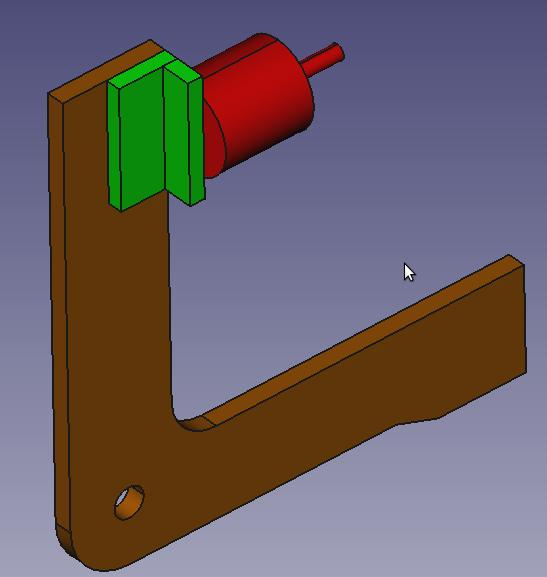
Latex project/images/bancada1.jpeg
