Gabrieldelacal/PFC/Latex project/images/ConSens.png

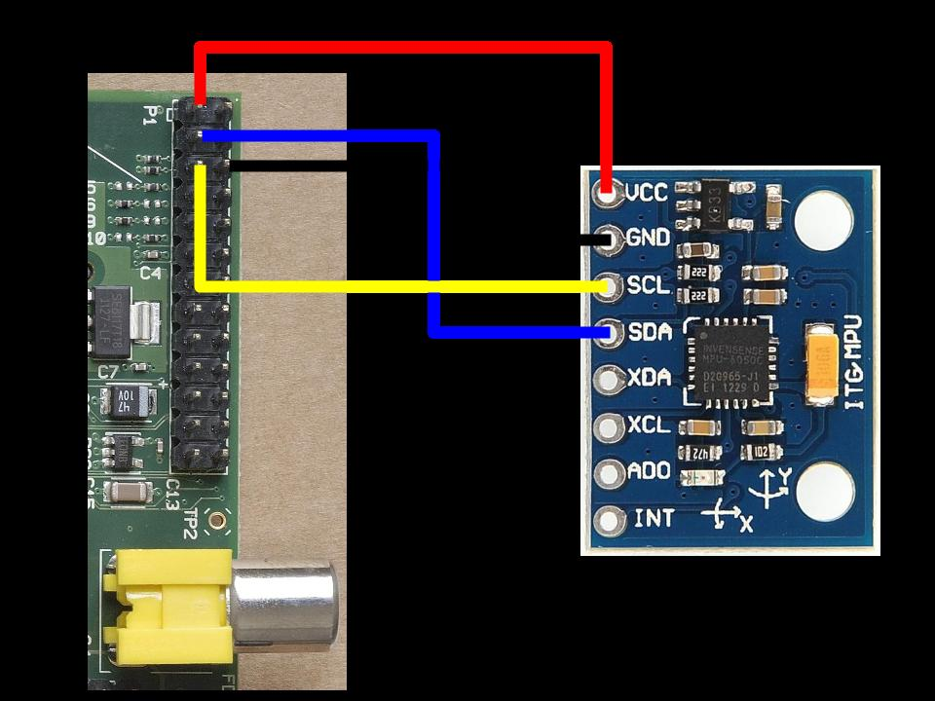
Latex project/images/ConSens.png
