Gabrieldelacal/PFC/Latex project/images/DSC_0413.jpg

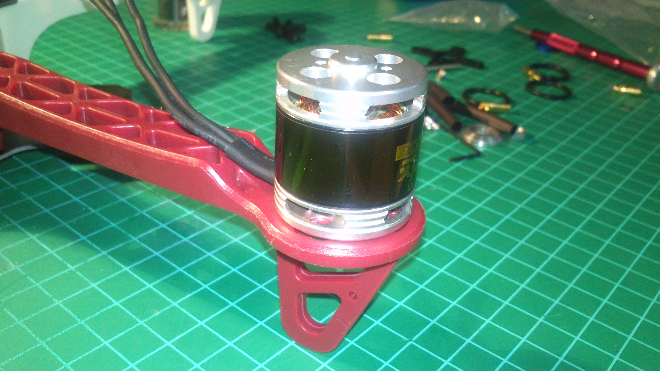
Latex project/images/DSC_0413.jpg
