Gabrieldelacal/PFC/Latex project/images/DSC_0415.jpg

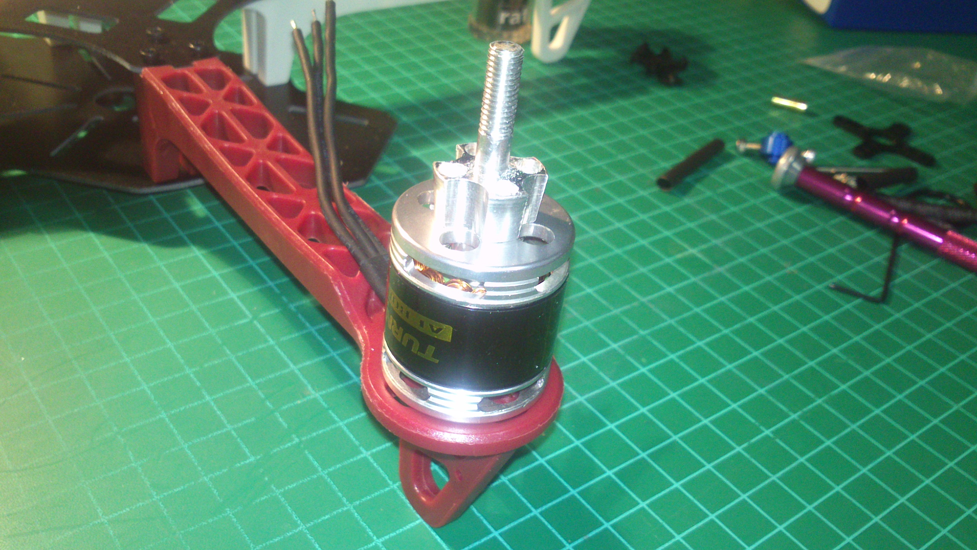
Latex project/images/DSC_0415.jpg
