Gabrieldelacal/PFC/Latex project/images/DSC_0548.jpg

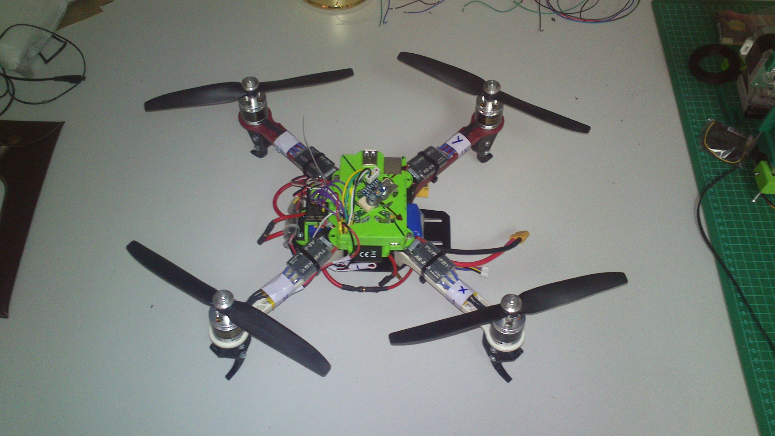
Latex project/images/DSC_0548.jpg
