Gabrieldelacal/PFC/Latex project/images/etseib_black.png

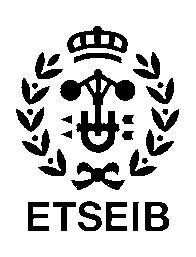
Latex project/images/etseib_black.png
