Gabrieldelacal/PFC/Latex project/images/IvsPWM.jpeg

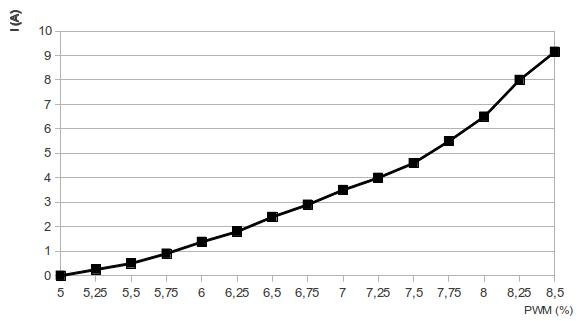
Latex project/images/IvsPWM.jpeg
