Gabrieldelacal/PFC/Latex project/images/LiPo_borrosa.png

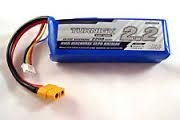
Latex project/images/LiPo_borrosa.png
