Gabrieldelacal/PFC/Latex project/images/MvsPWM.jpeg

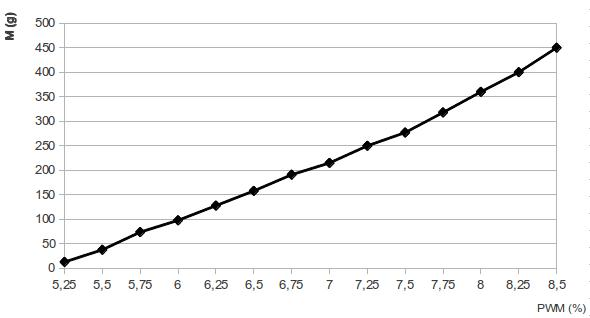
Latex project/images/MvsPWM.jpeg
