Gabrieldelacal/PFC/Latex project/images/propeller_image.jpg

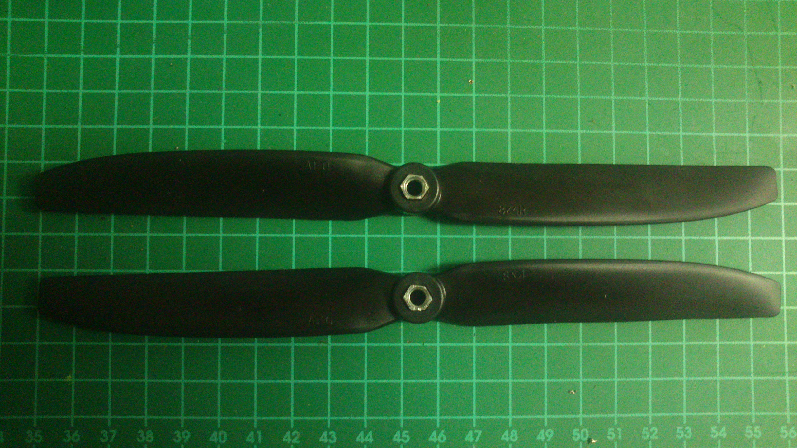
Latex project/images/propeller_image.jpg
