Gabrieldelacal/PFC/Latex project/images/propellers.png

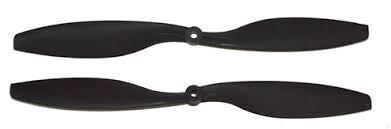
Latex project/images/propellers.png
