Gabrieldelacal/PFC/Latex project/images/Reg_stepdown.jpg

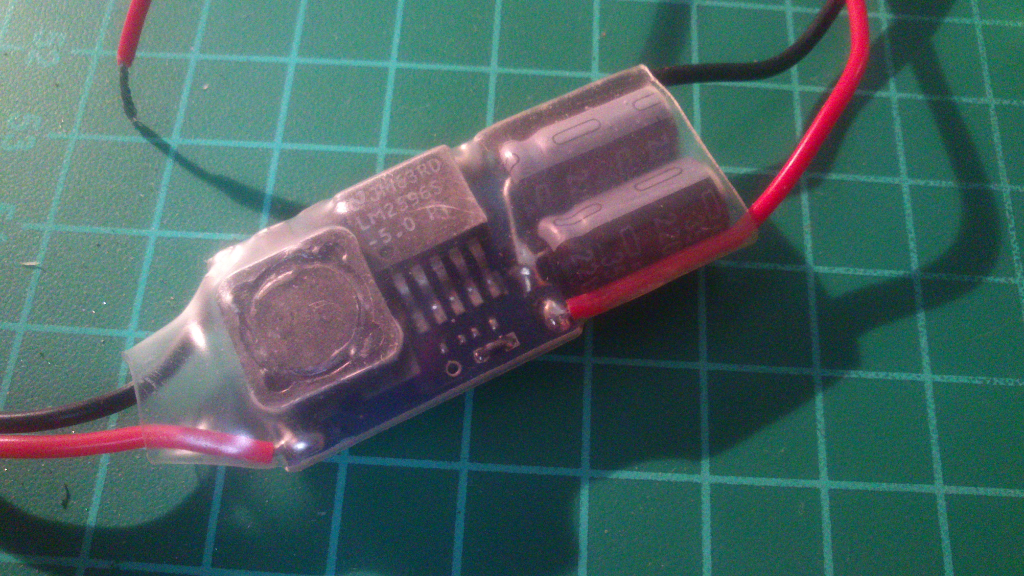
Latex project/images/Reg_stepdown.jpg
