Gabrieldelacal/PFC/Latex project/images/regulator.jpg

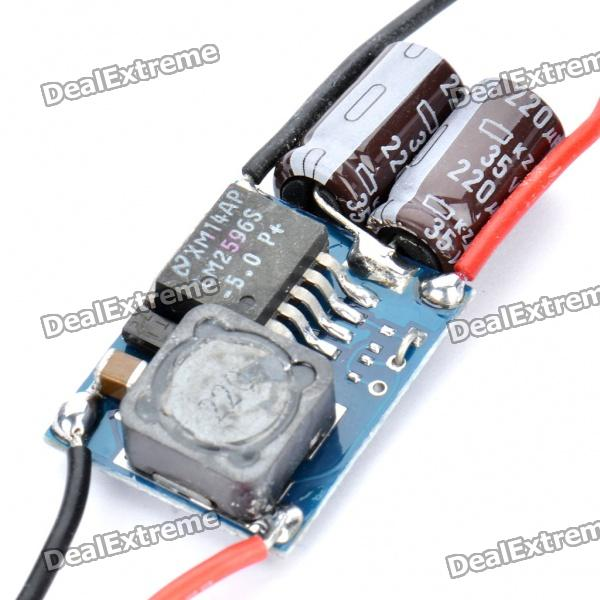
Latex project/images/regulator.jpg
