Gabrieldelacal/PFC/Latex project/images/simulation_1.jpeg

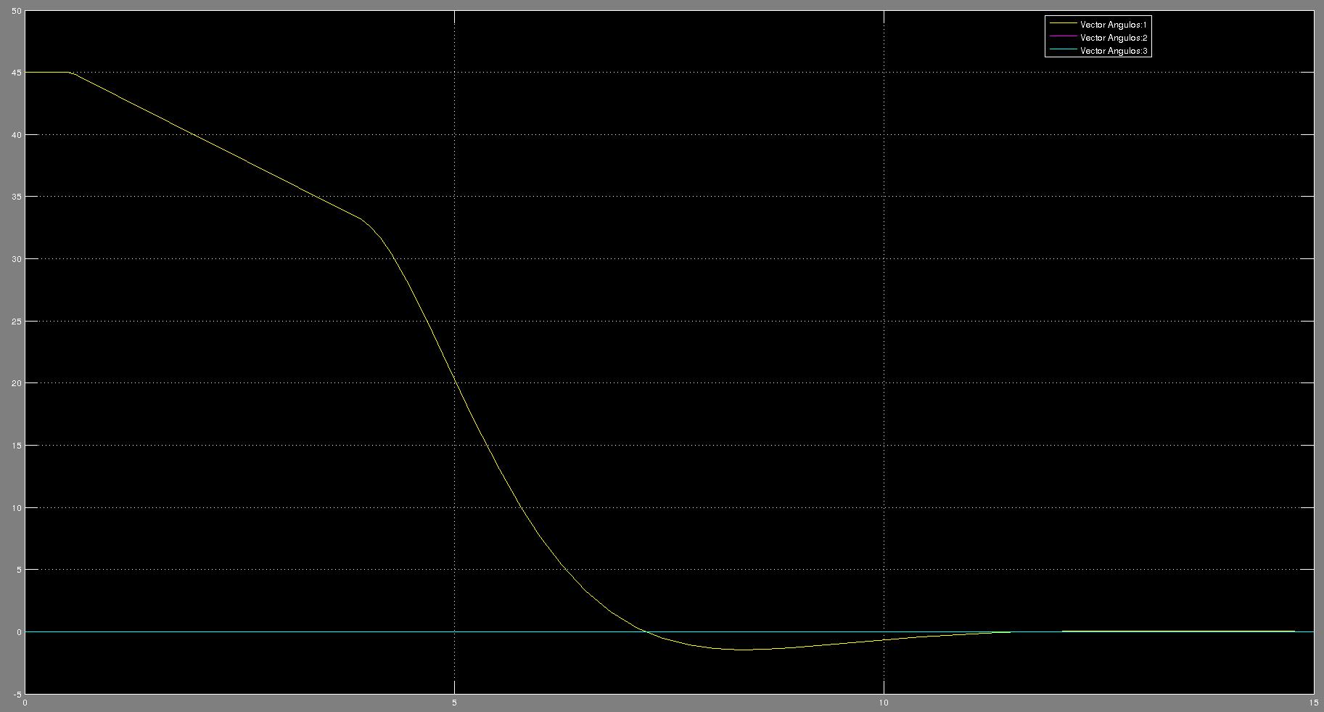
Latex project/images/simulation_1.jpeg
