Gabrieldelacal/PFC/Latex project/images/simulation_1.png

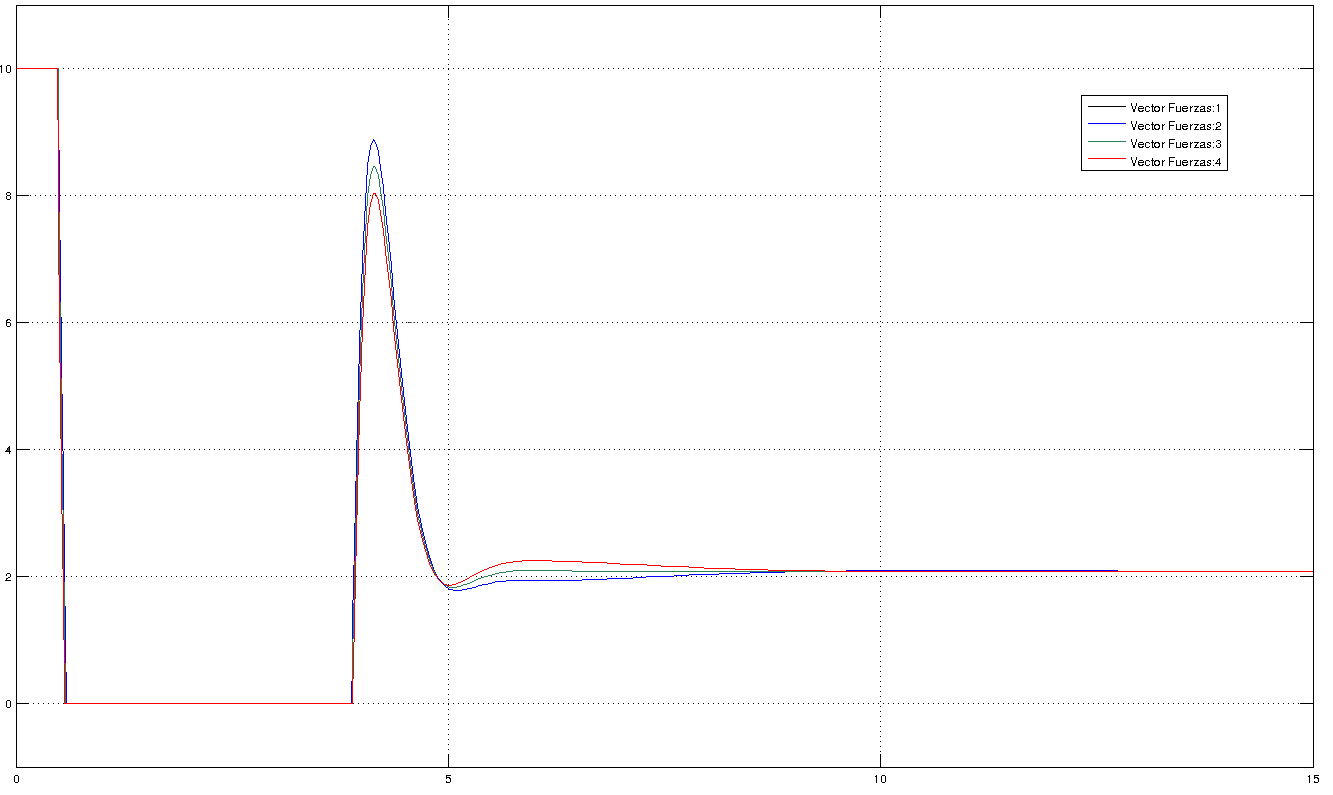
Latex project/images/simulation_1.png
