Gabrieldelacal/PFC/Latex project/images/simulation_2.jpeg

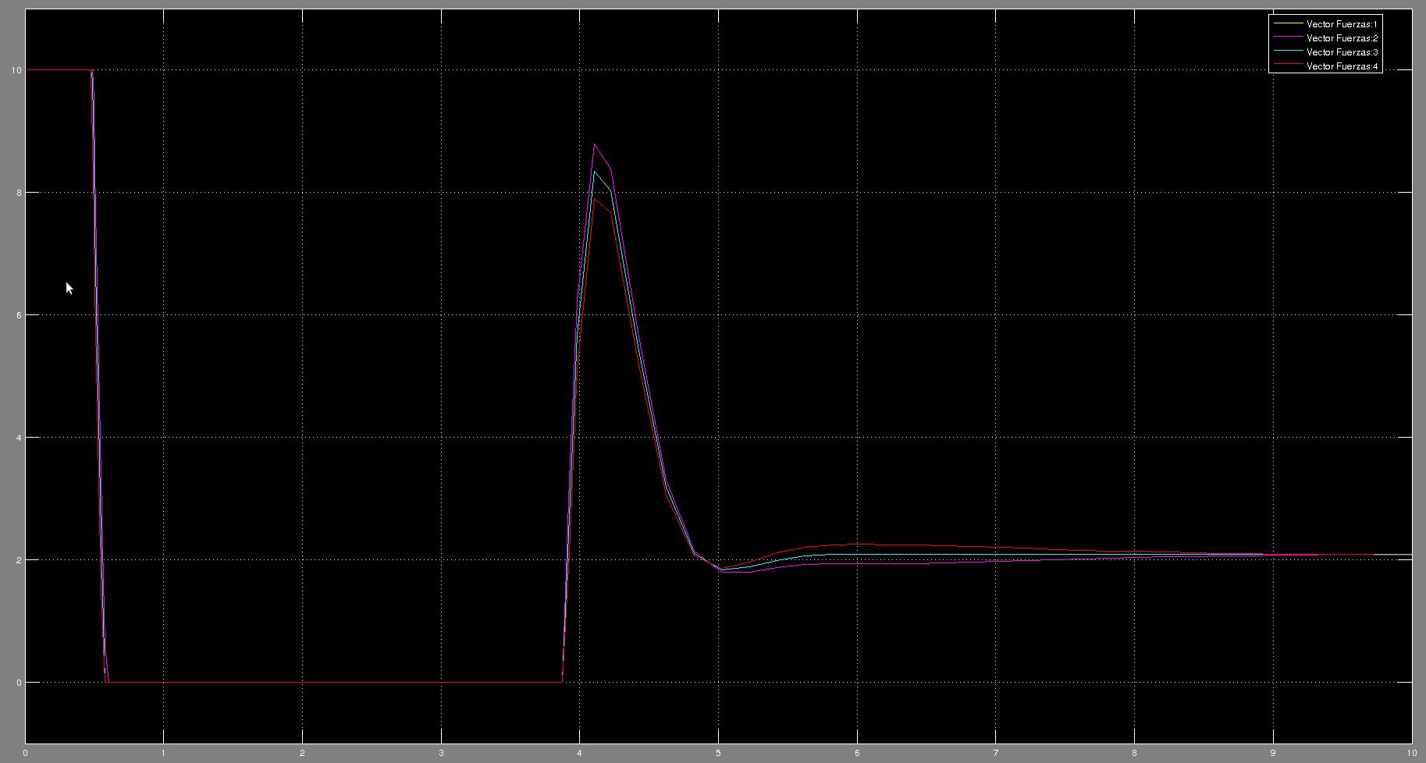
Latex project/images/simulation_2.jpeg
