Gabrieldelacal/PFC/Latex project/images/simulation_2.png

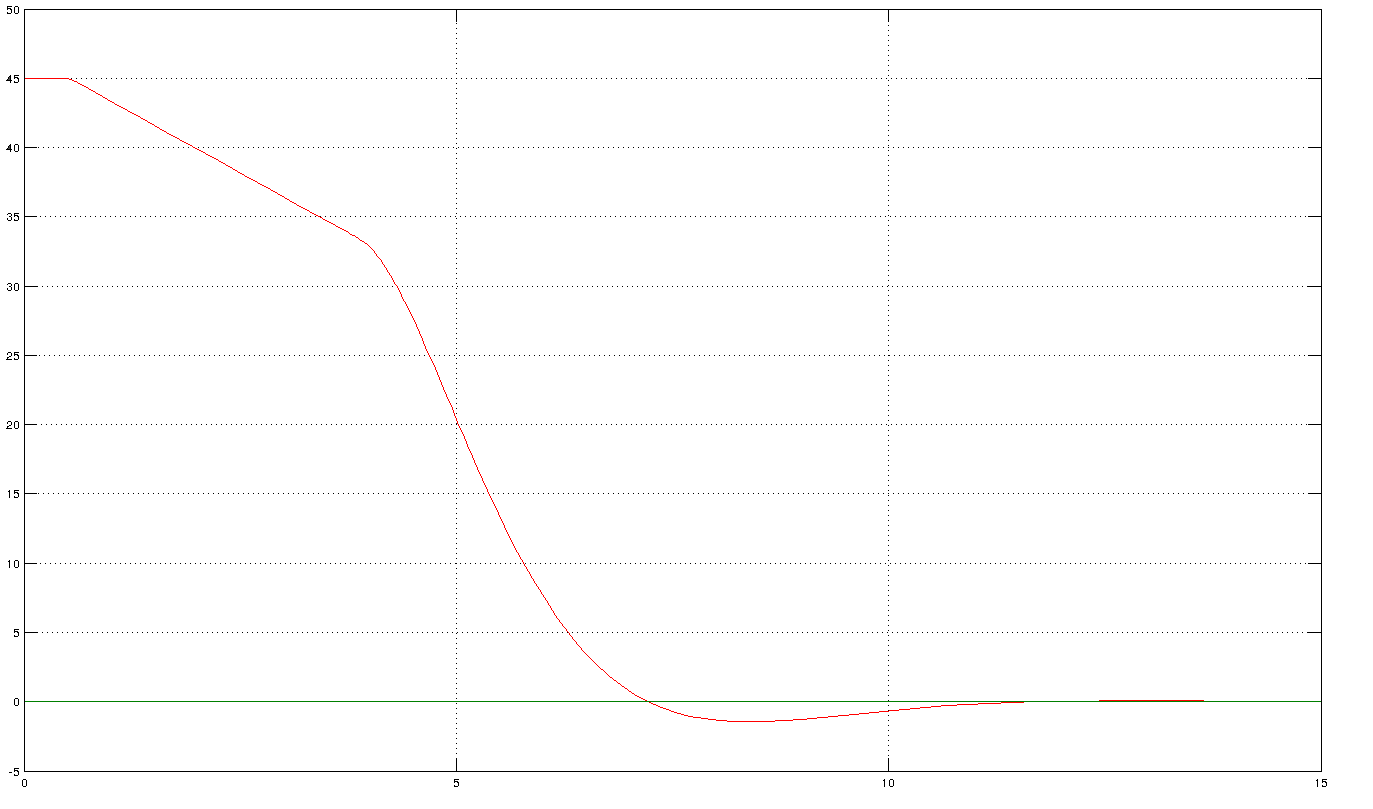
Latex project/images/simulation_2.png
