Gabrieldelacal/PFC/Rubbish/Model1.0/simulinklagrange/Quad.jpeg

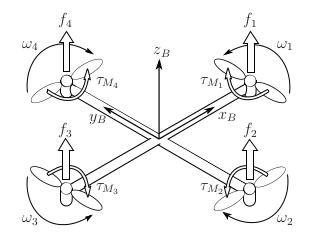
Rubbish/Model1.0/simulinklagrange/Quad.jpeg
