Gabrieldelacal/PFC/STL/Superior/RPI_mount/Ensamblaje_mount_RPI/Ensamblaje2.SLDASM

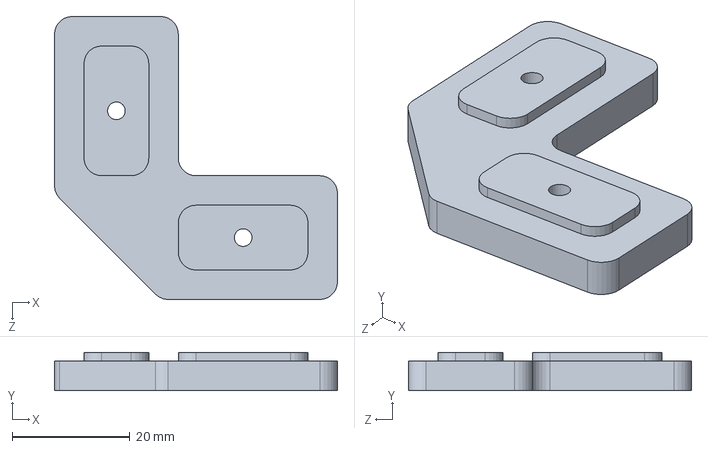
[picture p58: CAD file, 2014-05-26]
STL/Superior/RPI_mount/Ensamblaje_mount_RPI/Ensamblaje2.SLDASM
48.0 x 6.50 x 48.0 mm
