Gabrieldelacal/PFC/STL/Superior/RPI_mount/Ensamblaje_mount_RPI/Ensamblaje.SLDASM

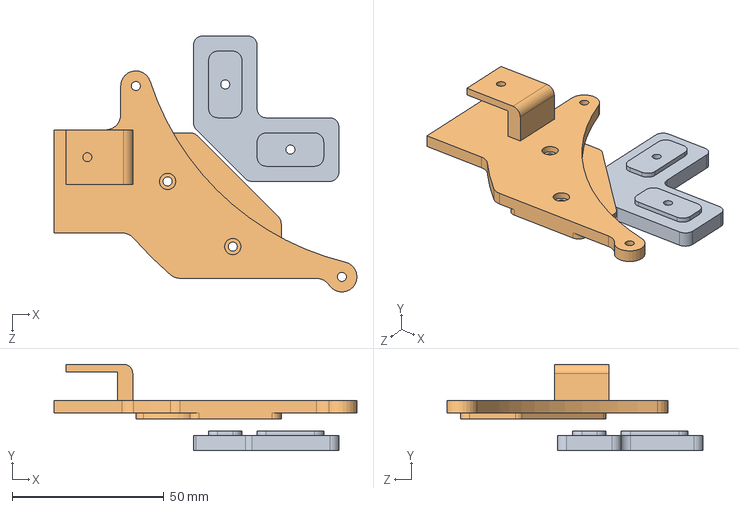
[picture p59: CAD file, 2014-05-26]
STL/Superior/RPI_mount/Ensamblaje_mount_RPI/Ensamblaje.SLDASM
100.0 x 28.5 x 84.5 mm
RPI mount 1
RPI mount 2
