Gabrieldelacal/PFC/Latex project/Bancada/Codo_bancada.fcstd

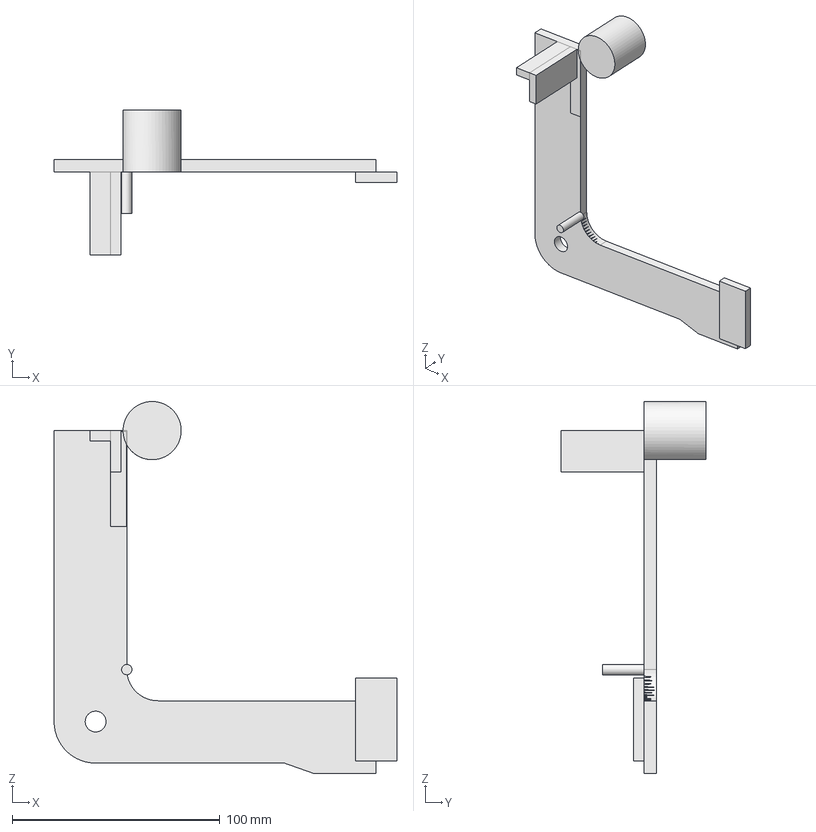
[picture p60: CAD file, 2014-05-14]
Latex project/Bancada/Codo_bancada.fcstd
165.0 x 70.0 x 179.0 mm
