Gabrieldelacal/PFC/STL/Batería/bateria_rear/Battery block rear.SLDPRT

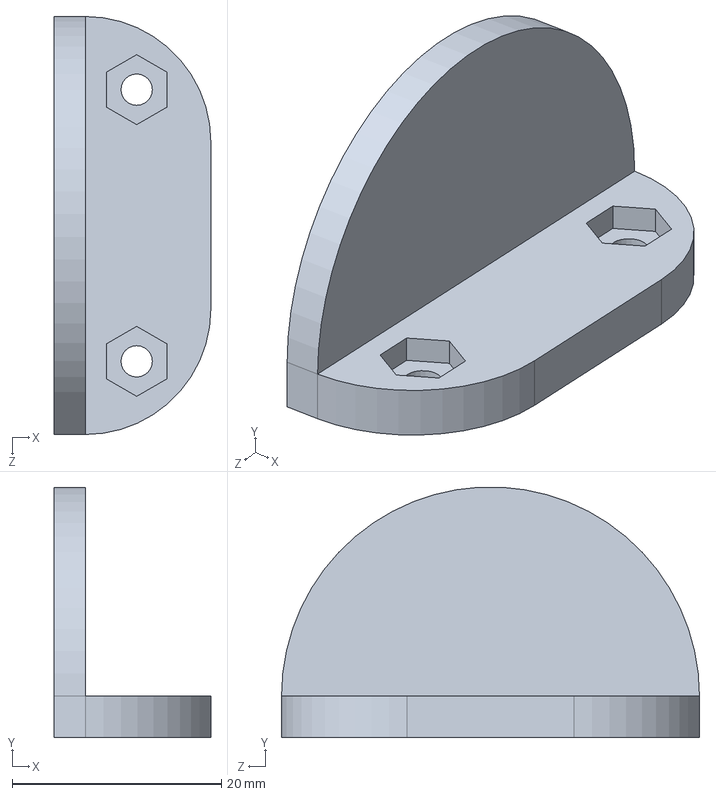
[picture p61: CAD file, 2014-05-26]
STL/Batería/bateria_rear/Battery block rear.SLDPRT
15.0 x 24.0 x 40.0 mm
