Gabrieldelacal/PFC/STL/Batería/bateria_side/Battery block side.SLDPRT

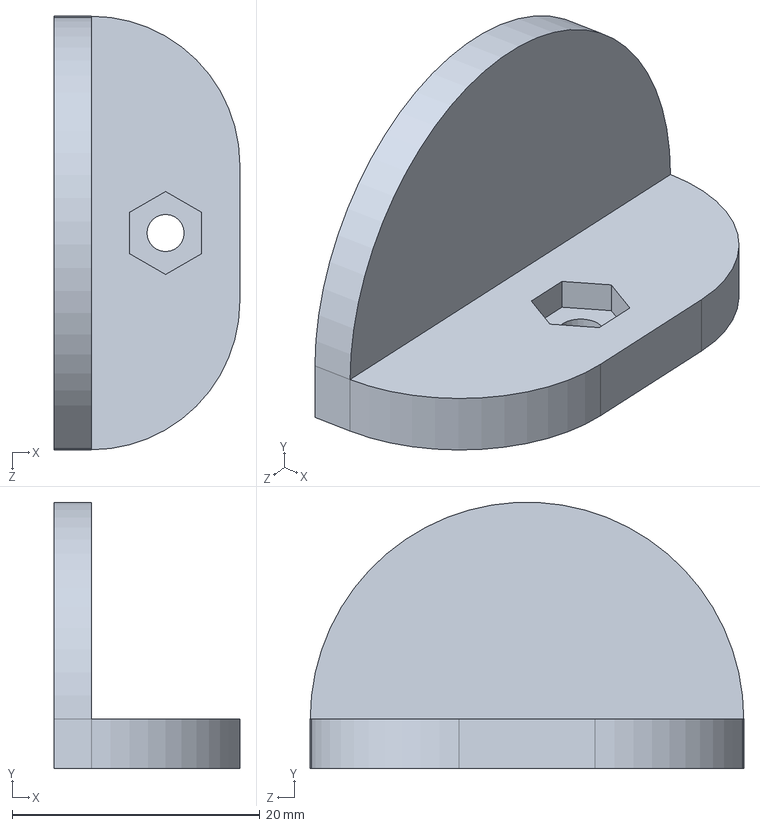
[picture p62: CAD file, 2014-05-26]
STL/Batería/bateria_side/Battery block side.SLDPRT
15.0 x 21.5 x 35.0 mm
