Gabrieldelacal/PFC/STL/Inferior/Base_inferior_soporte_patas/base qc.stl

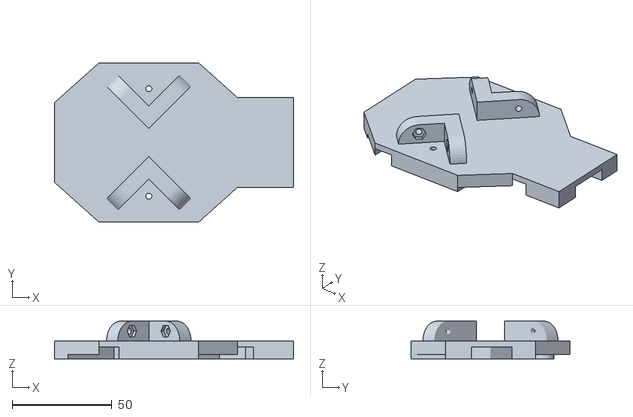
[picture p63: CAD file, 2014-05-26]
STL/Inferior/Base_inferior_soporte_patas/base qc.stl
120.0 x 80.0 x 19.0
