Gabrieldelacal/PFC/STL/Inferior/pata/pata.stl

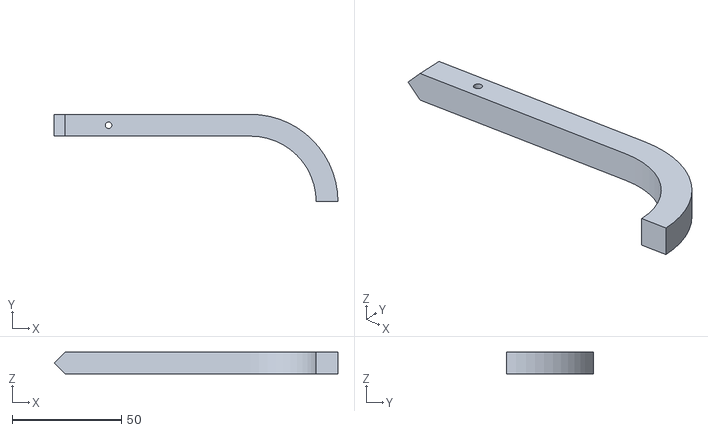
[picture p64: CAD file, 2014-05-26]
STL/Inferior/pata/pata.stl
130.0 x 40.0 x 10.0
