Gabrieldelacal/PFC/STL/Patas/Pata 1.SLDPRT

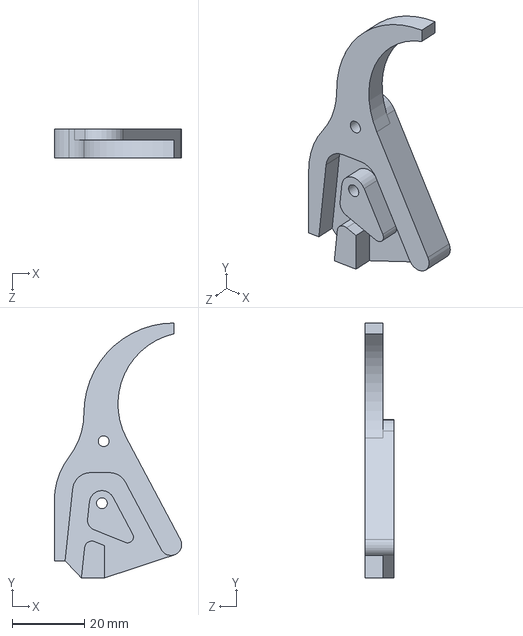
[picture p65: CAD file, 2014-05-29]
STL/Patas/Pata 1.SLDPRT
35.4 x 70.8 x 8.00 mm
