Gabrieldelacal/PFC/STL/Patas/Pata 2.SLDPRT

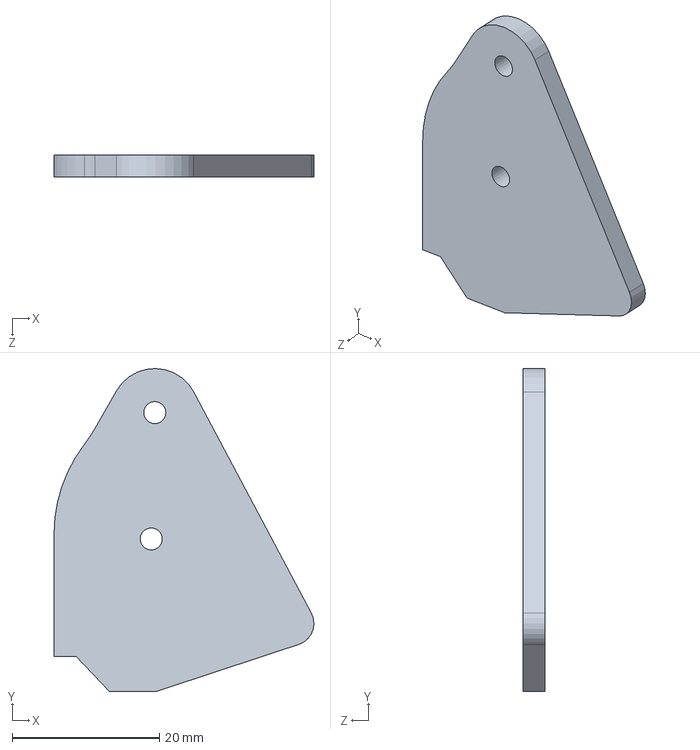
[picture p66: CAD file, 2014-05-29]
STL/Patas/Pata 2.SLDPRT
35.4 x 43.9 x 3.00 mm
