Gabrieldelacal/PFC/STL/Superior/RPI_mount/RPI mount 2.SLDPRT

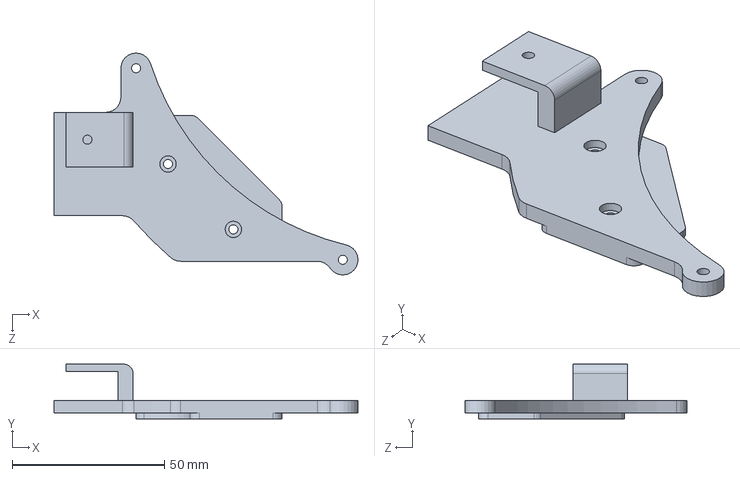
[picture p67: CAD file, 2014-05-26]
STL/Superior/RPI_mount/RPI mount 2.SLDPRT
100.0 x 18.0 x 73.0 mm
