Gabrieldelacal/PFC/(list of files, cad)

Other CAD files:
STL/Superior/RPI_mount/RPI mount 1.SLDPRT
STL/Batería/bateria_rear/Battery block rear.STL
STL/Batería/bateria_side/Battery block side.STL
STL/Patas/Pata 1.STL
STL/Patas/Pata 2.STL
STL/Superior/RPI_mount/RPI mount 1.STL
STL/Superior/RPI_mount/RPI mount 2.STL
