Gabrieldelacal/PFC/Latex project/images/montaje.jpg

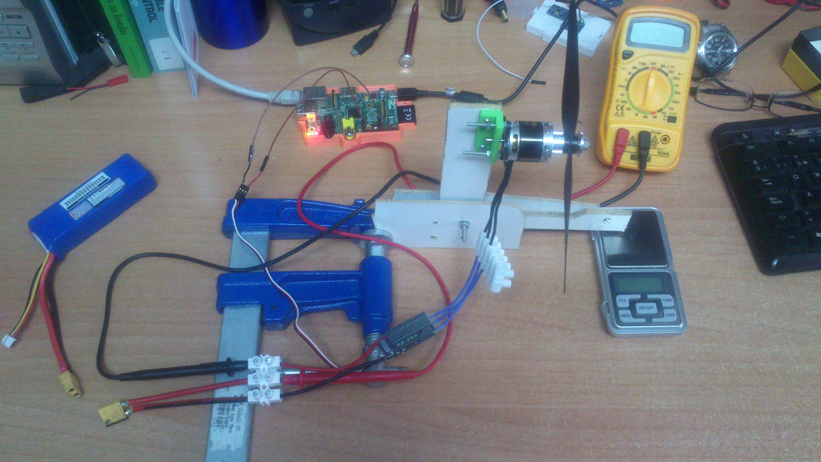
Latex project/images/montaje.jpg
