Gabrieldelacal/PFC/Rubbish/kicad PSU buck/buck.kicad_pcb

## KiCad design Rubbish/kicad PSU buck/buck.kicad_pcb (2014-04-10)

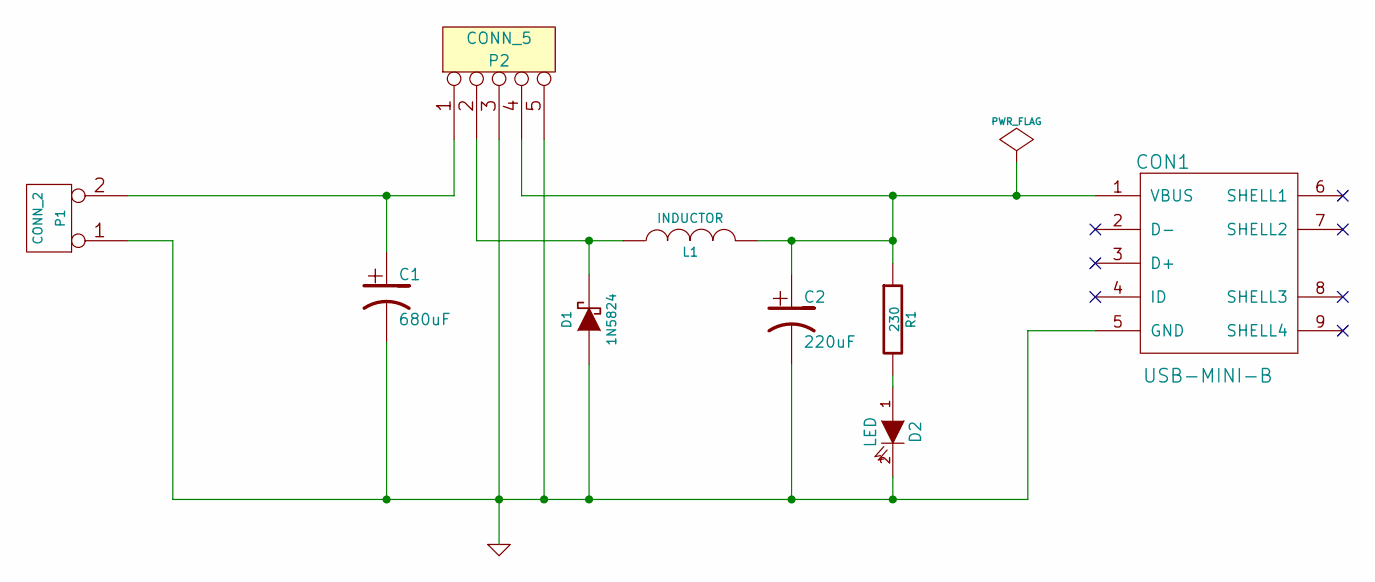
[picture p69: schematic buck.sch]

Parts:
C1: 680uF
C2: 220uF
CON1: USB-MINI-B
D1: 1N5824
D2: LED
L1: INDUCTOR
P1: CONN_2
P2: CONN_5
R1: 230

Connections:
unnamed: D1.2 (K), L1.1, P2.2
unnamed: C1.2, C2.2, CON1.5 (GND), D1.1 (A), D2.2 (K), P1.1, P2.3, P2.5
unnamed: D2.1 (A), R1.2
unnamed: C2.1, CON1.1 (VBUS), L1.2, P2.4, R1.1
unnamed: C1.1, P1.2 (PM), P2.1

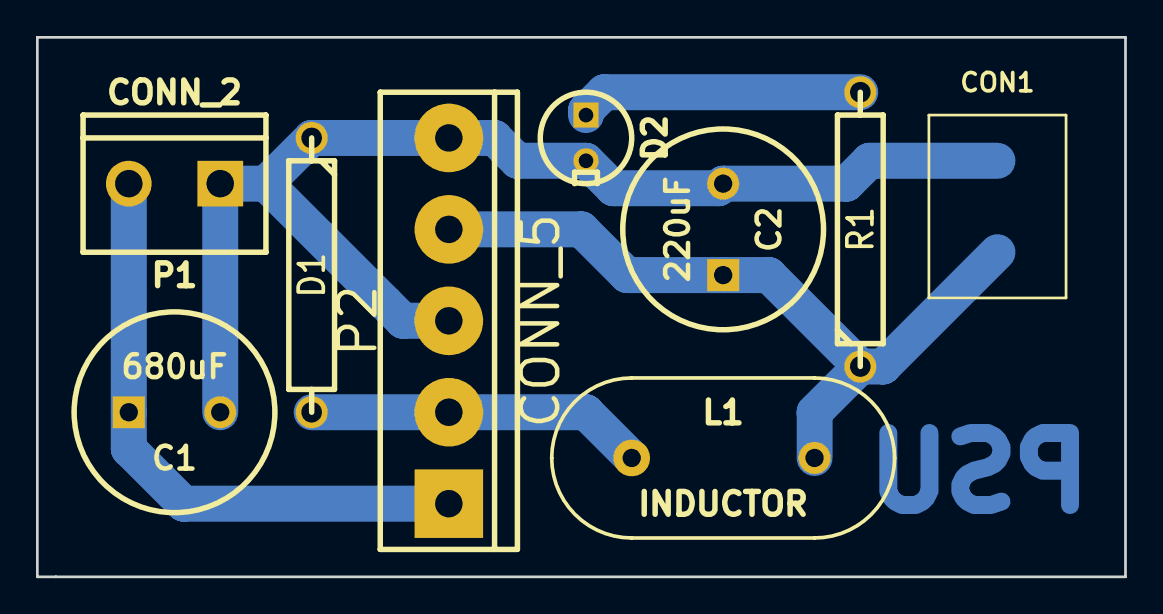
[picture p70: board buck.kicad_pcb from above]

Board: 2 copper layers, 60.5 x 30.0 mm, 9 parts (0 on the bottom side), 5 nets.
