Gabrieldelacal/PFC/(commit log)

2014-04-10 aibo y la galleta
    [buck.kicad_pcb, buck.sch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]
2014-05-14 lots more
    [Codo_bancada.fcstd]
2014-05-28 with spring
2014-06-17 con el Registro
